meetmrhung/eyecu/documentation/TechnicalManual/Arielle/DaughterBoard1stRevision.JPG

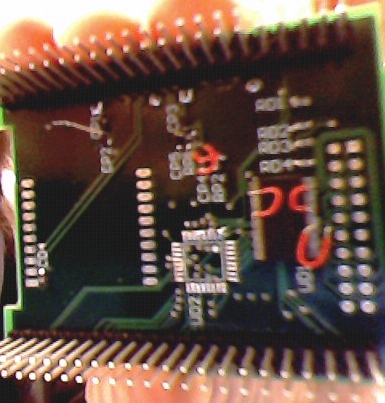
documentation/TechnicalManual/Arielle/DaughterBoard1stRevision.JPG
