meetmrhung/eyecu/documentation/TechnicalManual/Arielle/MSP430Board.JPG

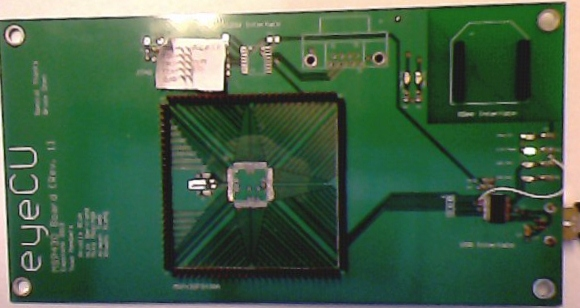
documentation/TechnicalManual/Arielle/MSP430Board.JPG
