meetmrhung/eyecu/documentation/TechnicalManual/Khashi/Power Rev 1 Schematic.png

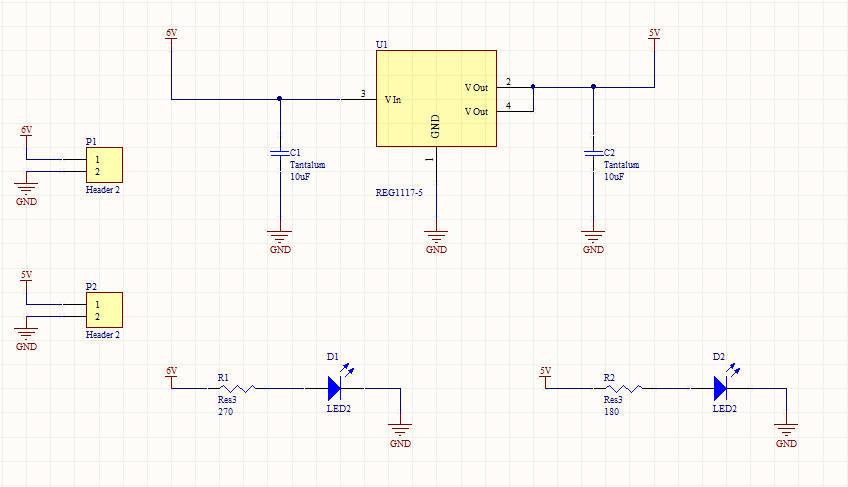
documentation/TechnicalManual/Khashi/Power Rev 1 Schematic.png
