meetmrhung/eyecu/documentation/TechnicalManual/Khashi/Power Rev 2 Schematic.png

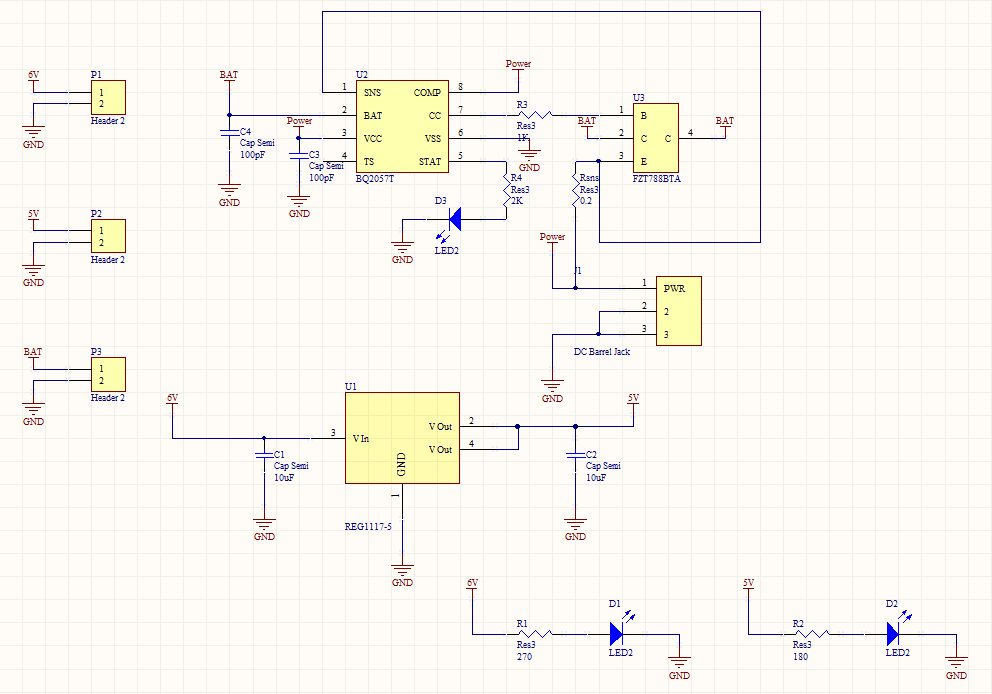
documentation/TechnicalManual/Khashi/Power Rev 2 Schematic.png
