meetmrhung/eyecu/hardware/doc/Camera_Scope_Captures/dclck_no_lvlshft.bmp

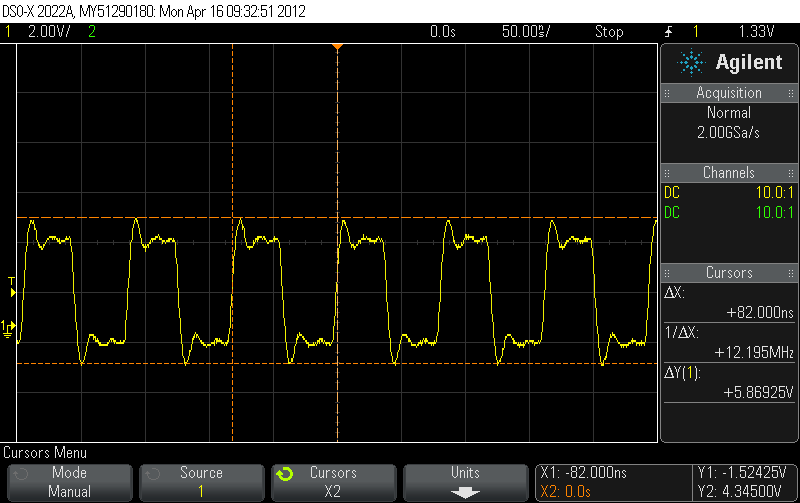
hardware/doc/Camera_Scope_Captures/dclck_no_lvlshft.bmp
