meetmrhung/eyecu/hardware/doc/Camera_Scope_Captures/dout0_no_lvlshft.bmp

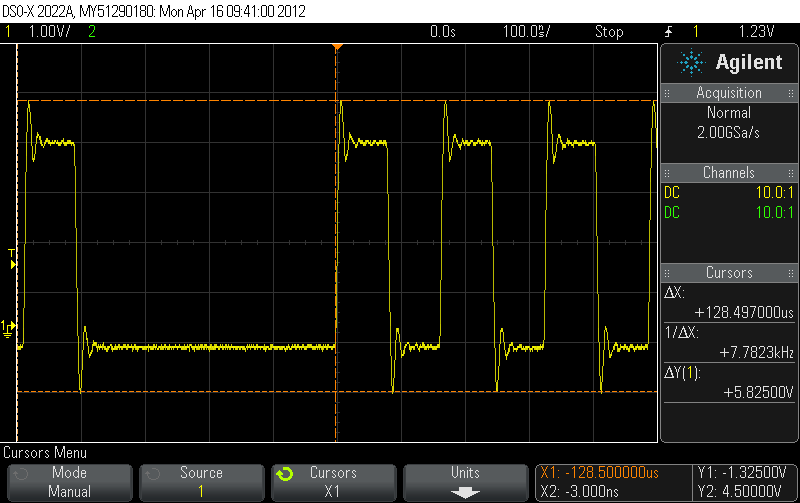
hardware/doc/Camera_Scope_Captures/dout0_no_lvlshft.bmp
