meetmrhung/eyecu/hardware/doc/Camera_Scope_Captures/horiz_sync_no_lvlshf.bmp

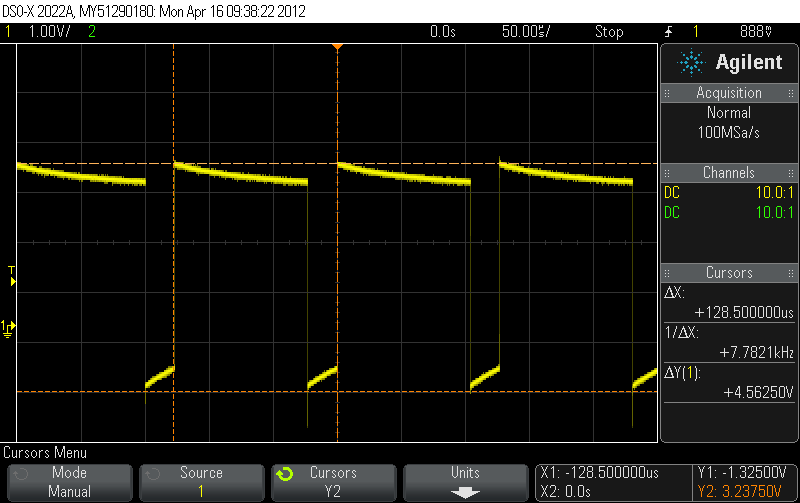
hardware/doc/Camera_Scope_Captures/horiz_sync_no_lvlshf.bmp
