meetmrhung/eyecu/hardware/doc/Camera_Scope_Captures/NewScope/dout0_4_17_12.bmp

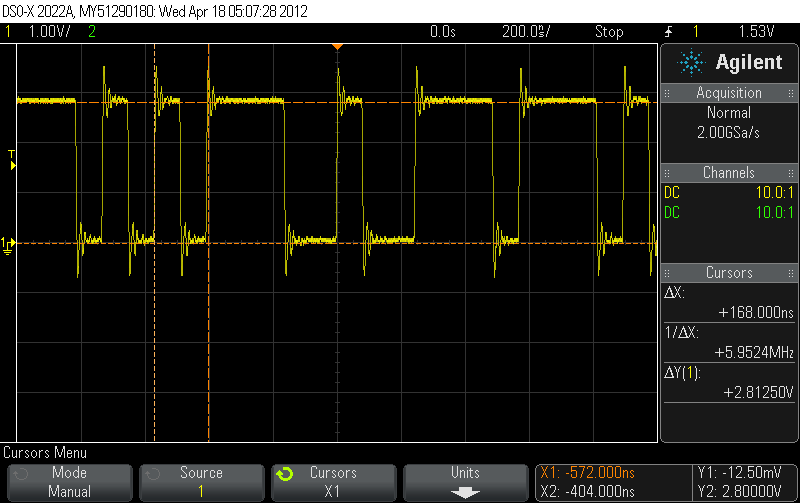
hardware/doc/Camera_Scope_Captures/NewScope/dout0_4_17_12.bmp
