meetmrhung/eyecu/hardware/doc/Camera_Scope_Captures/NewScope/hd_4_17_13.bmp

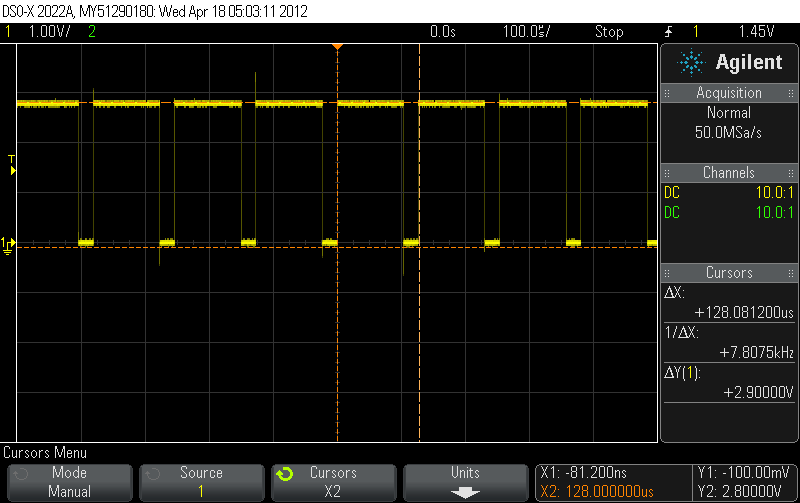
hardware/doc/Camera_Scope_Captures/NewScope/hd_4_17_13.bmp
