meetmrhung/eyecu/hardware/doc/Camera_Scope_Captures/NewScope/vd_4_17_14.bmp

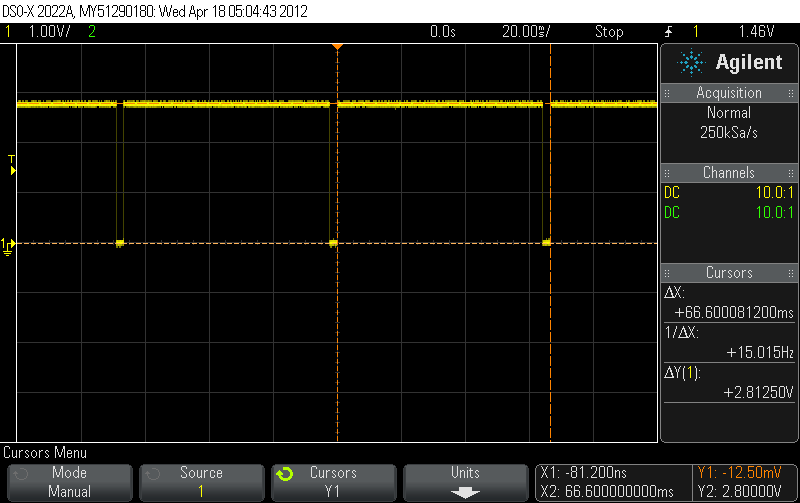
hardware/doc/Camera_Scope_Captures/NewScope/vd_4_17_14.bmp
