meetmrhung/eyecu/hardware/doc/Camera_Scope_Captures/vertical_no_lvlshft.bmp

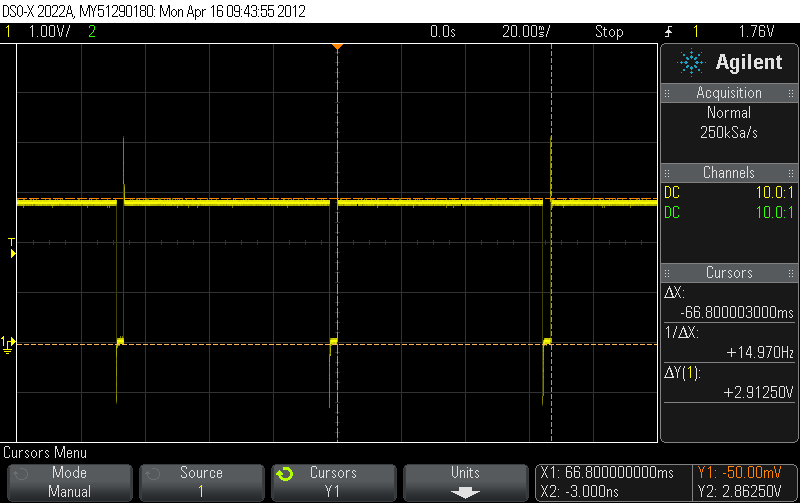
hardware/doc/Camera_Scope_Captures/vertical_no_lvlshft.bmp
