meetmrhung/eyecu/software/stellaris/I2C_Camera_Init.PNG

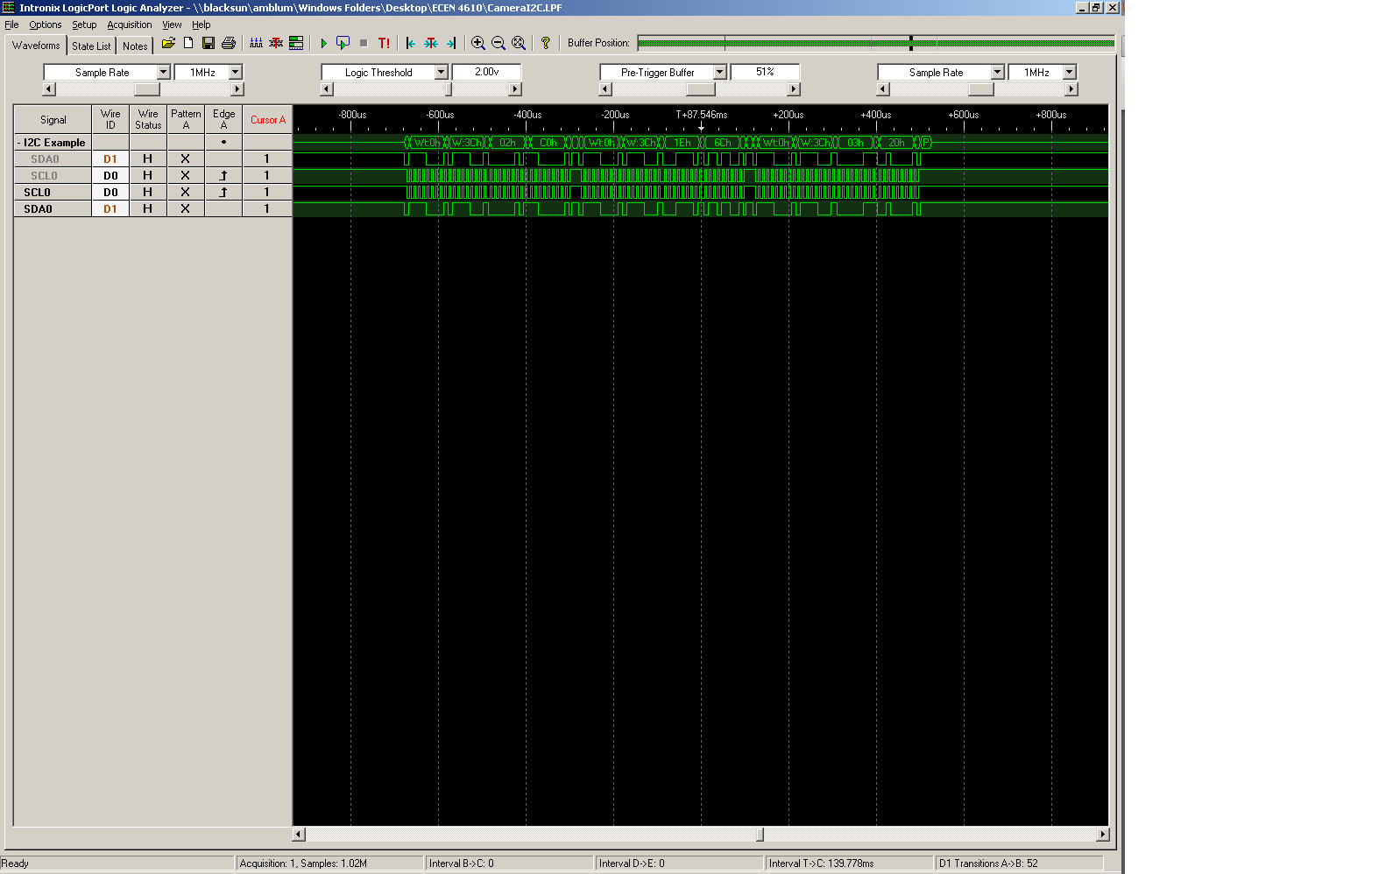
software/stellaris/I2C_Camera_Init.PNG
