meetmrhung/eyecu/hardware/bom/MSP_BOM_Record.xlsx

Serial and JTAG
Part | Manufacturer | Manufacturer Number | Description | Supplier | Price Per Unit ($/sampled) | Quantity Needed | Status (in-hand/ordered/not ordered) | Quantity In Hand | Datasheet (Y/N) | Schematic Part | Footprint | PCB Verified
MAX232 | Maxim | MAX232CWE+ | IC 2DVR/2RCVR RS232 5V 16-SOIC | Digi-Key | 3.47 | 1 | in-hand 3, (only needed 1) | 3 | Y
DB9 Connector | TE Connectivity | 1734351-1 | SERIAL PORT, CONN D-SUB PLUG R/A 9POS GOLD/FL | Digi-Key | 1.17 | 1 | in-hand 2, (only needed 1) | 2 | Y
Resistor 47K | Panasonic | ERJ-8ENF4702V | RES 47.0K OHM 1/4W 1% 1206 SMD | Digi-Key | 0.1 | 1 | in-hand 2, (only needed 1) | 2 | Y
Capacitor 1uF | KEMET | C1206C105K4RACTU | CAP CER 1UF 16V 10% X7R 1206 | Digi-Key | 0.36 | 5 | in-hand 15, (only needed 11) | 15 | Y
Capacitor 0.01uF | KEMET | C1206C103J1RACTU | CAP CER 10000PF 100V 5% X7R 1206 | Digi-Key | 0.36 | 1 | in-hand 5, (only needed 2) | 5 | Y
Capacitor 0.1uF | KEMET | C1206C104K5RACTU | CAP CER 0.1UF 50V 10% X7R 1206 | Digi-Key | 10 @ 1.5 | 1 | in-hand 10 (only needed 3) | 10 | Y
SW-PB | Omran Electronics | B3F-1052 | PUSH BUTTON SWITCH TACTILE SPST-NO 0.05A 24V | Digi-Key | 0.35 | 1 | in-hand 5, (only needed 1) | 5 | Y | TODO | TODO
JTAG Header | Samtec | TSW-105-07-F-D | JTAG HEADER DOUBLE ROW HEADER, 5 PINS PER ROW | Samtec | sample | 1 | in-hand 5, (only needed 1) | 5 | Y
USB Interface
Part | Manufacturer | Manufacturer Number | Description | Supplier | Price Per Unit ($/sampled) | Quantity Needed | Status (in-hand/ordered/not ordered) | Quantity In Hand | Datasheet (Y/N) | Schematic Part | Footprint | PCB Verified
USB Port | Samtec | USB-B-S-S-W-TH | USB-B THRU-HOLE | Samtec | sample | 1 | in-progress order 2 (total need 1) |  | Y
FT232RL | FTDI | FT232RL-REEL | IC USB FS SERIAL UART 28-SSOP | Digi-Key | 4.5 | 1 | in-hand 2, (only needed 1) | 2 | Y
MI0805K400R-10 | Laird Technologies | MI0805K400R-10 | FERRITE BEAD 1.5A 40 OHM 0805 SMD | Digi-Key | 10 @ 0.064 | 1 | in-hand 10, (only needed 1) | 10 | Y
Resistor 4.7K | Panasonic | ERJ-8GEYJ472V | RES 4.7K OHM 1/4W 5% 1206 SMD | Digi-Key | 0.06 | 1 | in-hand 2, (only needed 1) | 2 | Y
Resistor 10K | Panasonic | ERJ-8GEYJ103V | RES 10K OHM 1/4W 5% 1206 SMD | Digi-Key | 0.06 | 1 | in-hand 3, (only needed 1) | 3 | Y
Resistor 300 | Panasonic | ERJ-8GEYJ301V | RES 300 OHM 1/4W 5% 1206 SMD | Digi-Key | 0.06 | 3 | in-hand 10, (only needed 5) | 10 | Y
Capacitor 0.1uF | KEMET | C1206C104K5RACTU | CAP CER 0.1UF 50V 10% X7R 1206 | Digi-Key | 10 @ 1.5 | 2 | in-hand 10 (only needed 3) | 10 | Y
Capacitor 10uF | KEMET | T491A106K010AT | CAP TANT 10UF 10V 10% 1206 | Digi-Key | 0.51 | 1 | in-hand 2, (only needed 1) | 2 | Y
Capacitor 0.01uF | KEMET | C1206C103J1RACTU | CAP CER 10000PF 100V 5% X7R 1206 | Digi-Key | 0.36 | 1 | in-hand 5, (only needed 2) | 5 | Y
Header | Samtec | TSW-103-07-F-S | HEADER SINGLE ROW, 3 PINS | Samtec | sample | 1 | in-hand 4, (only needed 1) | 4 | Y
LED, Red | Lite-On Inc. | LTST-C230EKT | LED RED-ORAN CLR1206REAR MNT SMD | Digi-Key | 0.4 | 1 | in-hand 4, (only needed 2) | 4 | Y
LED, Amber | Lite-On Inc. | LTST-C230AKT | LED AMBER CLR 1206 REAR MNT SMD | Digi-Key | 0.4 | 1 | in-hand 4, (only needed 2) | 4 | Y
LED, Green | Lite-On Inc. | LTST-C150GKT | LED GREEN CLEAR 1206 SMD | Digi-Key | 0.38 | 1 | in-hand 4, (only needed 2) | 4 | Y
Ribbon Cable | Samtec | IDSS-03-D-04.00 | CABLE ASSEMBLY FEMALE SINGLE ROW 3 PINS | Samtec | sample | 1 | in-hand 1 | 1 | Y
 |  | IDMS-03-T-04.00-T |  |  |  |  |  | 1
Xbee Interface
Part | Manufacturer | Manufacturer Number | Description | Supplier | Price Per Unit ($/sampled) | Quantity Needed | Status (in-hand/ordered/not ordered) | Quantity In Hand | Datasheet (Y/N) | Schematic Part | Footprint | PCB Verified
Capacitor 1uF | KEMET | C1206C105K4RACTU | CAP CER 1UF 16V 10% X7R 1206 | Digi-Key | 0.36 | 1 | in-progress order 15 (total need 11) |  | Y
Resistor 300 | Panasonic | ERJ-8GEYJ301V | RES 300 OHM 1/4W 5% 1206 SMD | Digi-Key | 0.06 | 2 | in-hand 10, (only needed 5) | 10 | Y
XBee | Digi International Inc. | OEM RF Module XB24-A...-001 | WIRELESS TRANS. 1mW CHIP ANTENNA SERIES 1 | Sparkfun | 22.95 | 1 | in-hand 2, (only needed 2) | 2 | Y
LED, Red | Lite-On Inc. | LTST-C230EKT | LED RED-ORAN CLR1206REAR MNT SMD | Digi-Key | 0.4 | 1 | in-hand 4, (only needed 2) | 4 | Y
LED, Amber | Lite-On Inc. | LTST-C230AKT | LED AMBER CLR 1206 REAR MNT SMD | Digi-Key | 0.4 | 1 | in-hand 4, (only needed 2) | 4 | Y
LED, Green | Lite-On Inc. | LTST-C230AKT | LED GREEN CLEAR 1206 SMD | Digi-Key | 0.38 | 1 | in-hand 4, (only needed 2) | 4 | Y
MSP430
Part | Manufacturer | Manufacturer Number | Description | Supplier | Price Per Unit ($/sampled) | Quantity Needed | Status (in-hand/ordered/not ordered) | Quantity In Hand | Datasheet (Y/N) | Schematic Part | Footprint | PCB Verified
Crystal | ECS Inc. | ECS-.327-12.5-13FLX-C | CRYSTAL 32.768 KHZ 12.5PF SMD | Digi-Key | 0.94 | 1 | in-hand 2, (only needed 1) | 2 | Y
Capacitor 22pF | KEMET | C1206C220J5GACTU | CAP CER 22PF 50V 5% NP0 1206 | Digi-Key | 0.31 | 2 | in-hand 3, (only needed 2) | 3 | Y
Capacitor 1uF | KEMET | C1206C105K4RACTU | CAP CER 1UF 16V 10% X7R 1206 | Digi-Key | 0.36 | 5 | in-hand 15, (only needed 11) | 15 | Y
Capacitor0.47uF | KEMET | C1206C474J5NACTU | CAP CER 0.47UF 50V 5% X8L 1206 | Digi-Key | 0.96 | 1 | in-hand 2, (only needed 1) | 2 | Y
Header | Samtec | TSW-125-07-F-S | HEADER SINGLE ROW 25 PINS | Samtec | sample | 4 | in-hand 5, (only needed 4) | 5 | Y
MSP430 Chip | Texas Instruments | MSP430F5438AIPZR | MSP430F5438AIPZR 100 PIN LQFP MICROCONTROLLER | Texas Instruments | sample | 1 | in-hand 2, (only needed 1) | 2 | Y
Resistor 100 | Panasonic | ERJ-8GEYJ101V | RES 100 OHM 1/4W 5% 1206 SMD | Digi-Key | 0.06 |  | in-hand 10 | 10 | Y
CPLD | Atmel | ATF22LV10C-10SU | CPLD IC PLD EE 10NS 24-SOIC | Digi-Key | 2.8 |  | in-hand 2 | 2
TPS60501DGS | Texas Instruments | TPS60501DGS | IC CHRG PUMP STPDWN 250MA 10MSOP | Texas Instruments | sample |  | in-hand 2 | 2
Capacitor 2.2uF | KEMET | C3216X5R1C225K/1.60 | CAP CER 2.2UF 16V 10% X5R 1206 | Digi-Key | 0.4 |  | in-hand 4 | 4
TPS79915DDCR | Texas Instruments | TPS79915DDCR | IC LDO 200MA 1.5V TSOT-23-5 | Digi-Key | 0.96 |  | in-hand 3 | 3
TPS79928DDCR | Texas Instruments | TPS79928DDCR | IC LDO 200MA 2.8V TSOT-23-5 | Digi-Key | 0.96 |  | in-hand 3 | 3
Capacitor 1uF | KEMET | C3216X7R1E105M/0.85 | CAP CER 1UF 25V 20% X7R 1206 | Digi-Key | 0.28 |  | in-hand 12 | 12
Capacitor 2.2uF | KEMET | C3216X5R1C225K/1.60 | CAP CER 2.2UF 16V 10% X5R 1206 | Digi-Key | 0.4 |  | in-hand 4 | 4
Capacitor 0.012uF | KEMET | C1206C123K5RACTU | CAP CER 0.012UF 50V 10% X7R 1206 | Digi-Key | 0.48 |  | in-hand 4 | 4
Resistor 165 | Panasonic | ERJ-8ENF1650V | RES 165 OHM 1/4W 1% 1206 SMD | Digi-Key | 0.1 |  | in-hand 4 | 4
Resistor 0.0 | Panasonic | ERJ-8GEY0R00V | RES 0.0 OHM 1/4W 1206 SMD | Digi-Key | 0.06 |  | in-hand 8 | 8
Capacitor 0.1uF | KEMET | C3216X7R1H104K | CAP CER 0.1UF 50V 10% X7R 1206 | Digi-Key | 0.225 |  | in-hand 10 | 10
Oscillator 24 MHz | AVX Corporation | KC2520B24.0000C10E00 | OSCILLATOR 24.0000MHZ SMD | Digi-Key | 3.96 |  | in-hand 2 | 2
SN74LVCH16T245DGGR | Texas Instruments | SN74LVCH16T245DGGR | IC BUS TRANSCVR 16BIT 48TSSOP | Digi-Key | 2.39 |  | in-hand 3 | 3
I2C Level Translator | Texas Instruments | TXS0102DCTR | IC VOLT-LVL TRANSL 2BIT BI SM8 | Texas Instruments | sample |  | in-hand 2 | 2
Resistor 10K | Panasonic | ERJ-8GEYJ103V | RES 10K OHM 1/4W 5% 1206 SMD | Digi-Key | 0.06 |  | in-hand 3 | 3
Crystal 24MHz | ECS INC | ECS-240-20-4 | CRYSTAL 24.000 MHZ 20PF 49US | Digi-Key | 0.81 |  | in-hand 2 | 2
I2C Level Translator | Texas Instruments | PCA9306DCTR | IC VOLT-LEVEL TRANSLATOR SM8 | Digi-Key | 0.94 |  | in-hand 4 | 4
