meetmrhung/eyecu/hardware/bom/Daughter_and_Camera_Board_PCB_BOM.xlsx

Camera Interface
Part | Manufacturer | Manufacturer Number | Description | Supplier | Supplier Part Number | Price Per Unit ($/sampled) | Quantity Needed | Status (in-hand/ordered/not ordered) | Quantity In Hand | Datasheet (Y/N) | Schematic Part | Footprint | PCB Verified
Camera Connection Header | Samtec | TSW-110-09-G-D | MALE TO MALE 10x2 HEADER | Samtec | TSW-110-09-G-D | sampled | 1 | in-hand 6, (only needed 2) | 6
FIFO Buffer | Integrated Device Technology | IDT72V241L10PF | IC FIFO SYNC 4KX9 10NS 32QFP | DigiKey | 800-1518-ND | 24.89 | 1 | in-progress order 2
Resistor 165 | Panasonic | ERJ-3EKF1650V | RES 165 OHM 1/10W 1% 0603 SMD | DigiKey | P165HCT-ND | 0.04 | 2 | 4
??? Resistor 300
Capacitor 1 uF | Muarata Electronics North America | GRM188R60J105MA01D | CAP CER 1UF 6.3V 20% X5R 0603 | DigiKey | 490-1549-1-ND | 0.032 | 1 | 10
LED Green | OSRAM | LG Q971-KN-1 | LED CHIPLED 570NM GREEN 0603 SMD | DigiKey | 475-1409-1-ND | 0.1 | 1 | 2
LED Amber | OSRAM | LA L296-Q2R2-1-Z | LED SMARTLED AMBER 615NM 0603 | DigiKey | 475-2712-1-ND | 0.17 | 2 | 1
LED Red | OSRAM | LS Q976-NR-1 | LED CHIPLED 633NM RED 0603 SMD | DigiKey | 475-2512-1-ND | 0.11 | 1 | 1
Connections to BeagleBone
Part | Manufacturer | Manufacturer Number | Description | Supplier | Supplier Part Number | Price Per Unit ($/sampled) | Quantity Needed | Status (in-hand/ordered/not ordered) | Quantity In Hand | Datasheet (Y/N) | Schematic Part | Footprint | PCB Verified
BeagleBone Connection Header | Samtec | TSW-123-09-G-D | MALE TO MALE 23x2 HEADER | Samtec | TSW-123-09-G-D | sampled | 2 | in-hand 6, (only needed 2)
XBee | Digi International Inc. | OEM RF Module XB24-A...-001 | WIRELESS TRANS. 1mW CHIP ANTENNA SERIES 1 | Sparkfun | WRL-08664 | 22.95 | 1 | in-hand 2, (only needed 2) | 2 | Y
Capacitor 1 uF | Muarata Electronics North America | GRM188R60J105MA01D | CAP CER 1UF 6.3V 20% X5R 0603 | DigiKey | 490-1549-1-ND | 0.032 | 1 | 10
Resistor 665 | Panasonic | ERJ-3EKF6650V | RES 665 OHM 1/10W 1% 0603 SMD | DigiKey | P665HCT-ND | 0.04 | 1 | 6
Resistor 165 | Panasonic | ERJ-3EKF1650V | RES 165 OHM 1/10W 1% 0603 SMD | DigiKey | P165HCT-ND | 0.04 | 1 | 4
LED Pink | Panasonic | LNJP12X8ARA | LED SMD PINK TSS TYPE | DigiKey | LNJP12X8ARACT-ND | 0.54 | 1 | 1
LED Blue | OSRAM | LB Q39G-L2N2-35-1 | LED CHIPLED BLUE 470NM 0603 SMD | DigiKey | 475-2816-1-ND | 0.27 | 1 | 4
Camera Board
Part | Manufacturer | Manufacturer Number | Description | Supplier | Supplier Part Number | Price Per Unit ($/sampled) | Quantity Needed | Status (in-hand/ordered/not ordered) | Quantity In Hand | Datasheet (Y/N) | Schematic Part | Footprint | PCB Verified
Crystal | AVX Corporation | KC2520B24.5760C10E00 | OSCILLATOR 24.5760MHZ SMD | DigiKey | 478-4779-1-ND | 3.96 | 1 | 2
Mosfet N | Fairchild Semiconductor | FDV301N | MOSFET N-CH 25V 220MA SOT-23 | DigiKey | FDV301NCT-ND | 0.47 | 3 | 3
CMOS Camera - 640x480 | Toshiba | TCM8230MD | CMOS CAMERA 8-BIT WIDE RAW DATA OUTPUT RGB/YUV |  | SEN-08667 | 9.95 | 1 | 5
SN74LVCH16T245DGGR | Texas Instruments | SN74LVCH16T245DGGR | IC BUS TRANSCVR 16BIT 48TSSOP | Digi-Key | 296-19568-1-ND | 2.39 | 1 | 4
TPS79915DDCR | Texas Instruments | TPS79915DDCR | IC LDO 200MA 1.5V TSOT-23-5 | Digi-Key | 296-17777-1-ND | 0.96 | 1 | 3
TPS79928DDCR | Texas Instruments | TPS79928DDCR | IC LDO 200MA 2.8V TSOT-23-5 | Digi-Key | 296-17781-1-ND | 0.96 | 1 | 3
Resistor 2.0K | Panasonic | ERJ-3GEYJ202V | RES 2.0K OHM 1/10W 5% 0603 SMD | Digi-Key | P2.0KGCT-ND | 0.02 | 4 | 4
Resistor 0.0 | Panasonic | ERJ-3GEY0R00V | RES 0.0 OHM 1/10W 0603 SMD | Digi-Key | P0.0GCT-ND | 0.02 | 3 | 4
Resistor 10K | Panasonic | ERJ-3GEYJ103V | RES 10K OHM 1/10W 5% 0603 SMD | Digi-Key | P10KGCT-ND | 0.02 | 1 | 2
Resistor 165 | Panasonic | ERJ-3EKF1650V | RES 165 OHM 1/10W 1% 0603 SMD | DigiKey | P165HCT-ND | 0.04 | 2 | 4
Capacitor 1 uF | Muarata Electronics North America | GRM188R60J105MA01D | CAP CER 1UF 6.3V 20% X5R 0603 | DigiKey | 490-1549-1-ND | 0.032 | 5 | 10
Capacitor 0.1uF | Muarata Electronics North America | GRM188R71E104KA01D | CAP CER 0.1UF 25V 10% X7R 0603 | DigiKey | 490-1524-1-ND | 0.026 | 2 | 10
Capacitor 0.01uF | Muarata Electronics North America | GRM188R71H103KA01D | CAP CER 10000PF 50V 10% X7R 0603 | DigiKey | 490-1512-1-ND | 0.023 | 2 | 10
Capacitor 2.2uF | Taiyo Yuden | JMK107BJ225KA-T | CAP CER 2.2UF 6.3V 10% X5R 0603 | DigiKey | 587-1254-1-ND | 0.24 | 2 | 4
LED Blue | OSRAM | LB Q39G-L2N2-35-1 | LED CHIPLED BLUE 470NM 0603 SMD | DigiKey | 475-2816-1-ND | 0.27 | 2 | 4
