meetmrhung/eyecu/hardware/bom/Power PCB BOM.xlsx

Description | Quantity | Manufacturer P/N: | Supplier P/N: | Supplier
Linear Regulator, 5V, 800mA | 1 | REG117-5 | 296-27921-1-ND | Digi-Key
Capacitor, Tantalum, 10uF, 10% | 2 | TR3B106K010C0750 | 718-1462-1-ND | Digi-Key
LED, Red, 1.7V, 50mA | 2 | SML-LX1206SRC-TR | 67-1359-1-ND | Digi-Key
Resistor,Thick Film, 180Ohms, 1/4 W, 1% | 1 | RC1206FR-07180RL | 311-180FRCT-ND | Digi-Key
Resistor,Thick Film, 270Ohms, 1/4 W, 1% | 1 | RC1206FR-07270RL | 311-270FRCT-ND | Digi-Key
DC Plug, 2.1mm ID, 5.5mm OD, 24AWG | 1 | CA-2185 | CP-2185-ND | Digi-Key
Dean Ultra Plug, Female | 1 | Ultra Plug | Ultra Plug, Female (2) | Amazon
