meetmrhung/eyecu/documentation/budget/budget.xlsx

Section | Component | Quantity | Cost (each) | Cost to Team | Extended cost | Source
Wireless
 | XBee | 2 | 11.75 | 11.75 | 23.5 | Sparkfun.com
 | USB XBee Explorer | 1 | 24.95 | 24.95 | 24.95 | Sparkfun.com
 | XBee Breakout Board | 2 | 2.95 | 2.95 | 5.9 | Sparkfun.com
Processing |  |  |  | 0
 | Beagle Bone Evaluation Board | 2 | 89 | 0 | 0 | Capstone
Mechanical |  |  |  | 0
 | Lens-less Glasses | 1 | 5.99 | 5.99 | 5.99
Camera |  |  |  | 0
 | 640x480 CMOS Camera | 5 | 9.99 | 9.95 | 49.75 | Sparkfun.com
 | Test Cameras | 3 | Donated |  | 0 | Capstone
 | FTDI to USB | 1 | 10 | 10 | 10 | Sparkfun.com
Manufacturing |  |  |  | 0
 | PCB Fabrications (2 at 4 layer) | 3 | 66 | 66 | 198 | 4pcb.com (Advanced Circuits)
 | PCB Fabrications (2 at 4 layer, 2 image) | 3 | 112 | 112 | 336 | 4pcb.com (Advanced Circuits)
Components
 | LCD Screen | 9.95 | 1 |  | 0 | Adafruit.com
 | Hardware Buffer | 2 | 25 | 25 | 50 | Digikey.com
 | Daughterboard components | 40 | 2 |  | 0 | Digikey.com
Presentation
 | Poster | 1 | 55 | 55 | 55 | ITLL
Misc.
 | Shipping, miscellanous parts | 1 | 200 | 200 | 200
Total Cost |  |  |  |  | 959.09
