meetmrhung/eyecu/hardware/solidworks/BeagleBone.SLDASM

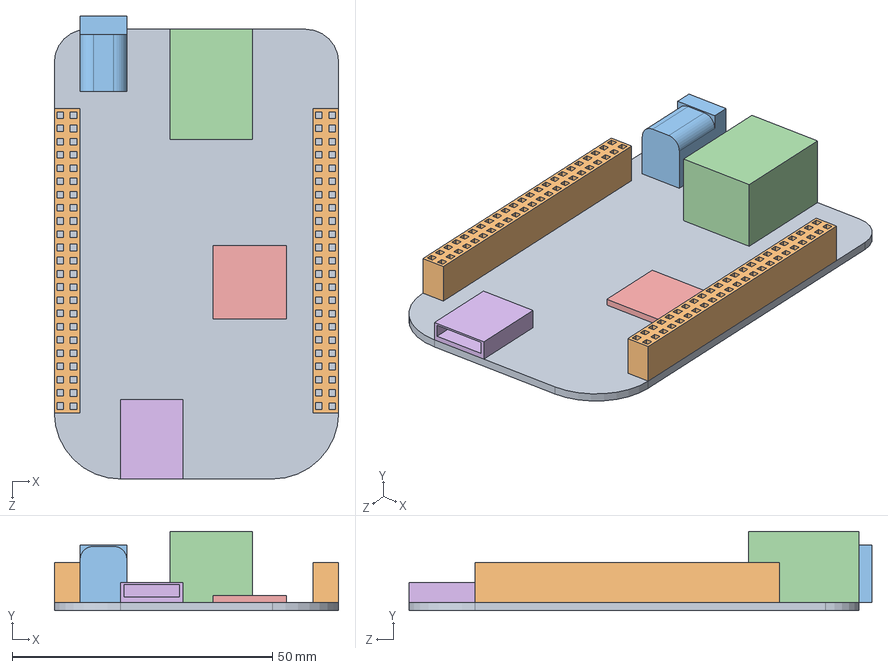
[picture p51: CAD file, 2012-03-21]
hardware/solidworks/BeagleBone.SLDASM
54.6 x 15.2 x 88.9 mm
BeagleBone_PCB
BeagleBone_Header x 2
BeagleBone_DC_Jack
BeagleBone_Ethernet
BeagleBone_ARM
BeagleBone_USB_A
