meetmrhung/eyecu/hardware/solidworks/BeagleBone_DC_Jack.SLDPRT

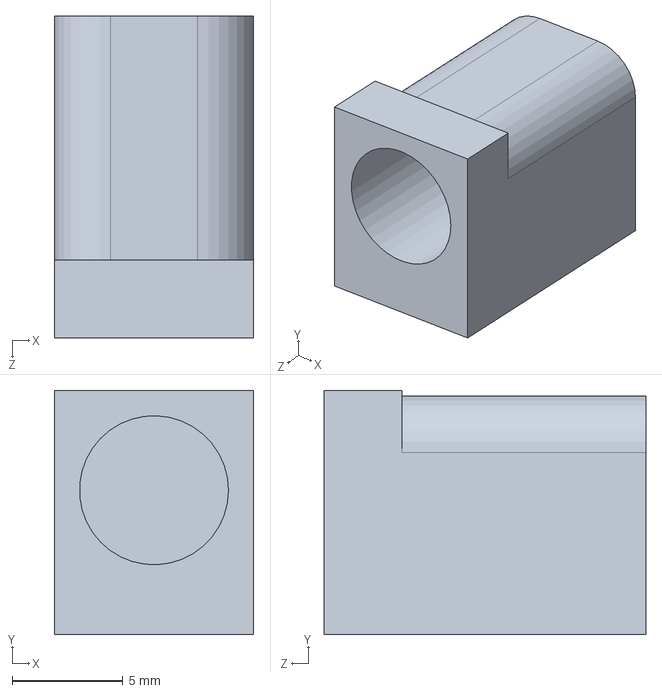
[picture p52: CAD file, 2012-03-21]
hardware/solidworks/BeagleBone_DC_Jack.SLDPRT
8.99 x 11.0 x 14.5 mm
