meetmrhung/eyecu/hardware/solidworks/BeagleBone_ARM.SLDPRT

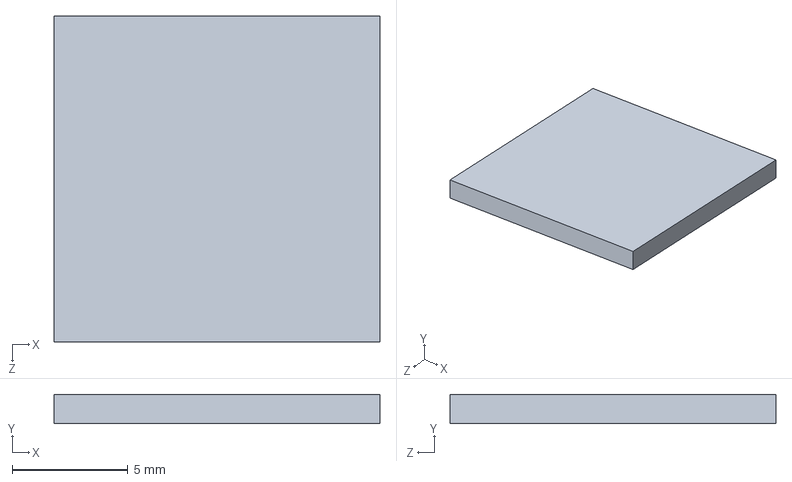
[picture p53: CAD file, 2012-03-21]
hardware/solidworks/BeagleBone_ARM.SLDPRT
14.1 x 1.27 x 14.1 mm
