meetmrhung/eyecu/hardware/solidworks/BeagleBone_USB_A.SLDPRT

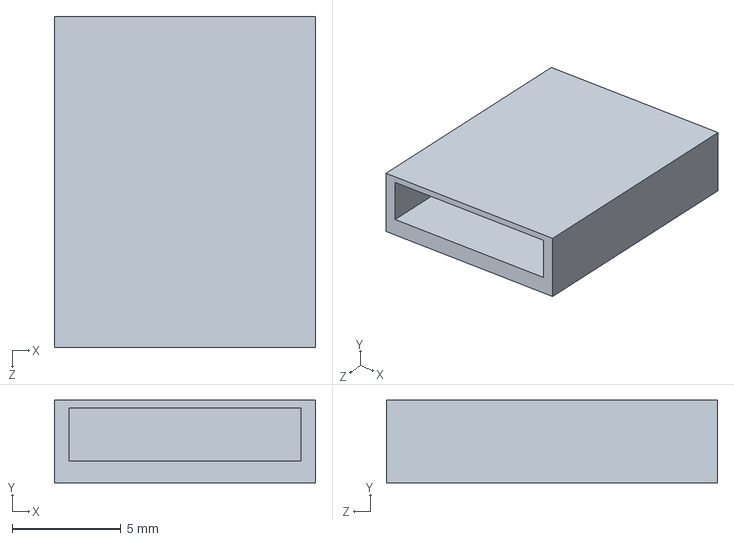
[picture p54: CAD file, 2012-03-21]
hardware/solidworks/BeagleBone_USB_A.SLDPRT
12.0 x 3.81 x 15.2 mm
