meetmrhung/eyecu/hardware/solidworks/BeagleBone_Header.SLDPRT

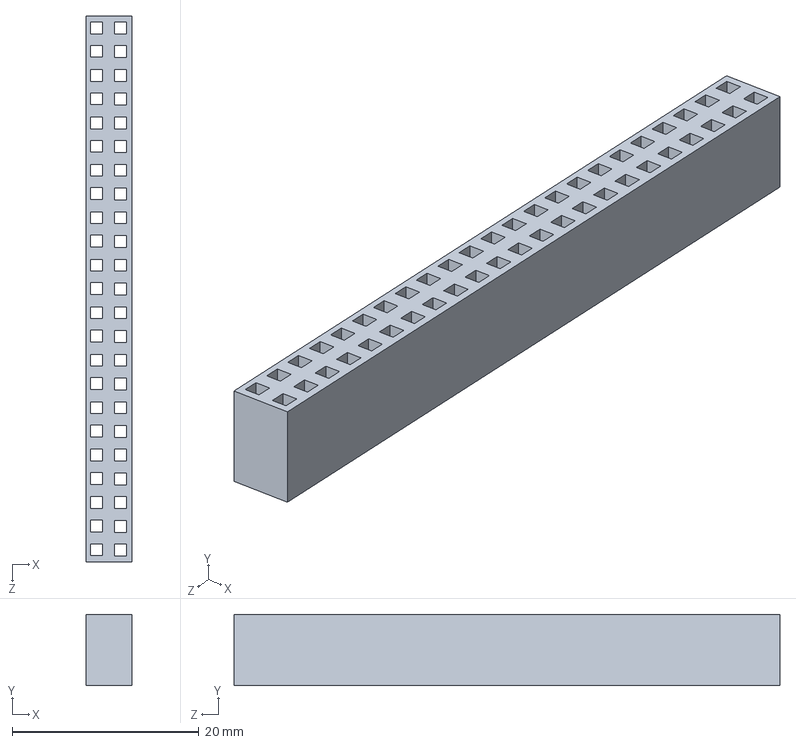
[picture p55: CAD file, 2012-03-21]
hardware/solidworks/BeagleBone_Header.SLDPRT
4.95 x 7.62 x 58.4 mm
