meetmrhung/eyecu/hardware/solidworks/BeagleBone_PCB.SLDPRT

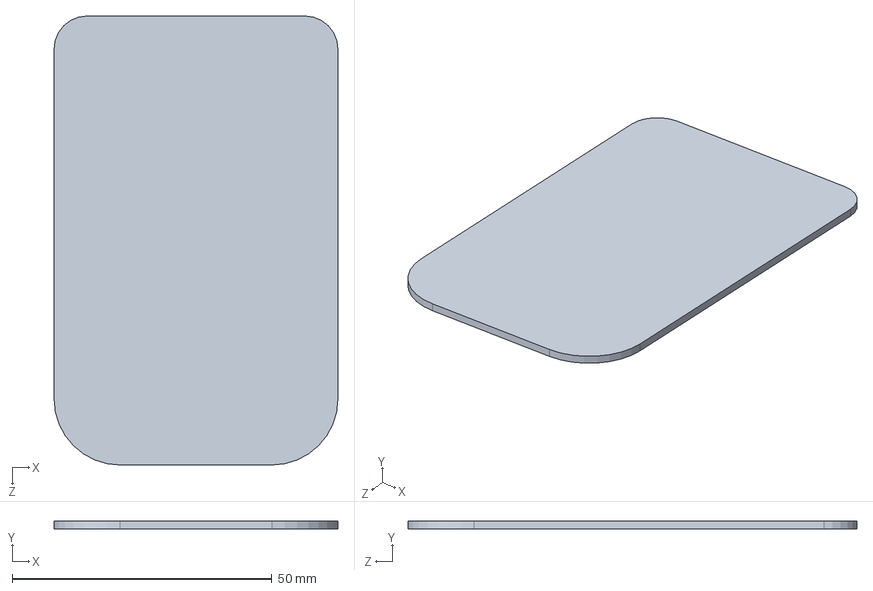
[picture p56: CAD file, 2012-03-21]
hardware/solidworks/BeagleBone_PCB.SLDPRT
54.6 x 1.57 x 86.4 mm
