meetmrhung/eyecu/hardware/solidworks/BeagleBone_Ethernet.SLDPRT

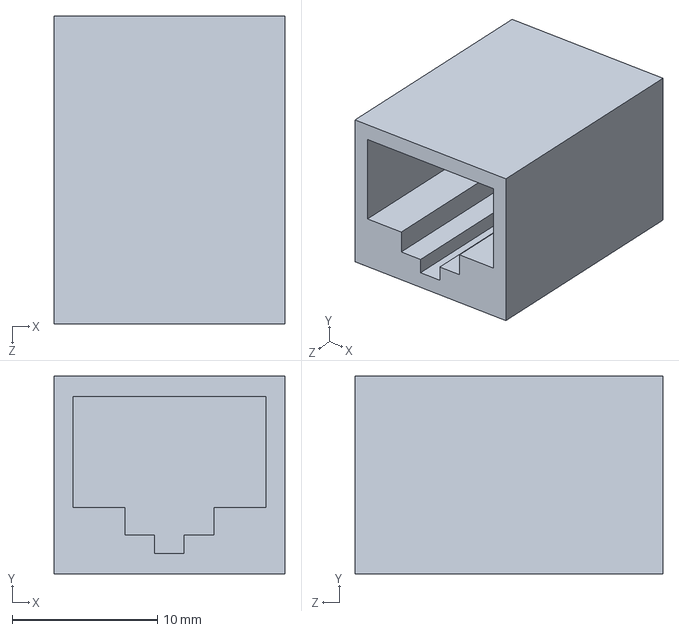
[picture p57: CAD file, 2012-03-21]
hardware/solidworks/BeagleBone_Ethernet.SLDPRT
15.9 x 13.6 x 21.2 mm
