meetmrhung/eyecu/documentation/TechnicalManual/Arielle/CameraProtoboard.JPG

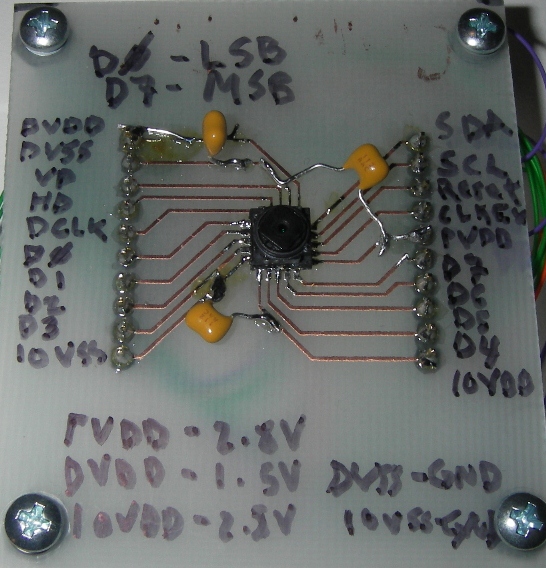
documentation/TechnicalManual/Arielle/CameraProtoboard.JPG
