meetmrhung/eyecu/documentation/TechnicalManual/Arielle/EyeGlassesPrototype.JPG

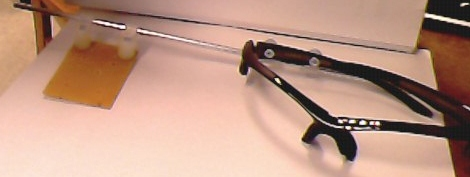
documentation/TechnicalManual/Arielle/EyeGlassesPrototype.JPG
