meetmrhung/eyecu/documentation/TechnicalManual/Arielle/CameraBoardTesting0.JPG

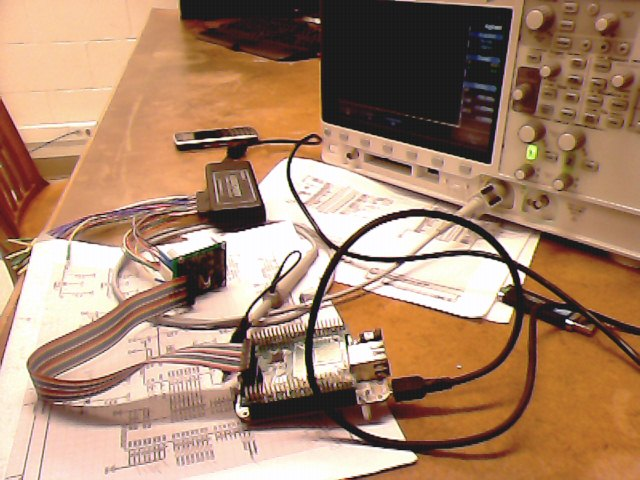
documentation/TechnicalManual/Arielle/CameraBoardTesting0.JPG
