meetmrhung/eyecu/documentation/TechnicalManual/Arielle/CameraBoardTesting1.JPG

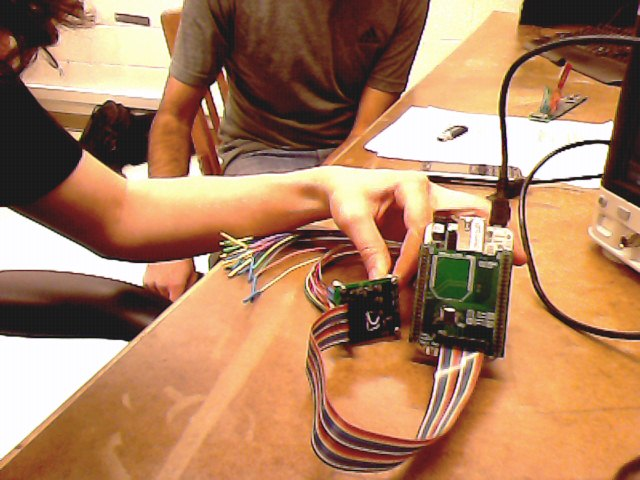
documentation/TechnicalManual/Arielle/CameraBoardTesting1.JPG
