meetmrhung/eyecu/hardware/doc/MSP430_Todo_list.docx

MSP 430 To do list

Header Footprints

Make XBee Component and footprint

Double Check the Power for schematic

-Add power and ground for MSP430

-I would collect the powers and grounds together in the schematic diagram

Do PCB layout and routing

Complete Advance Circuits PCB check thingy

Submit order to Digikey and finalize

Submit Samtec order and finalize
