meetmrhung/eyecu/hardware/schematics/BONE_SCH.pdf

REV | BY Description | DATE
A3 | Production release. | 10/21/2011 | GC

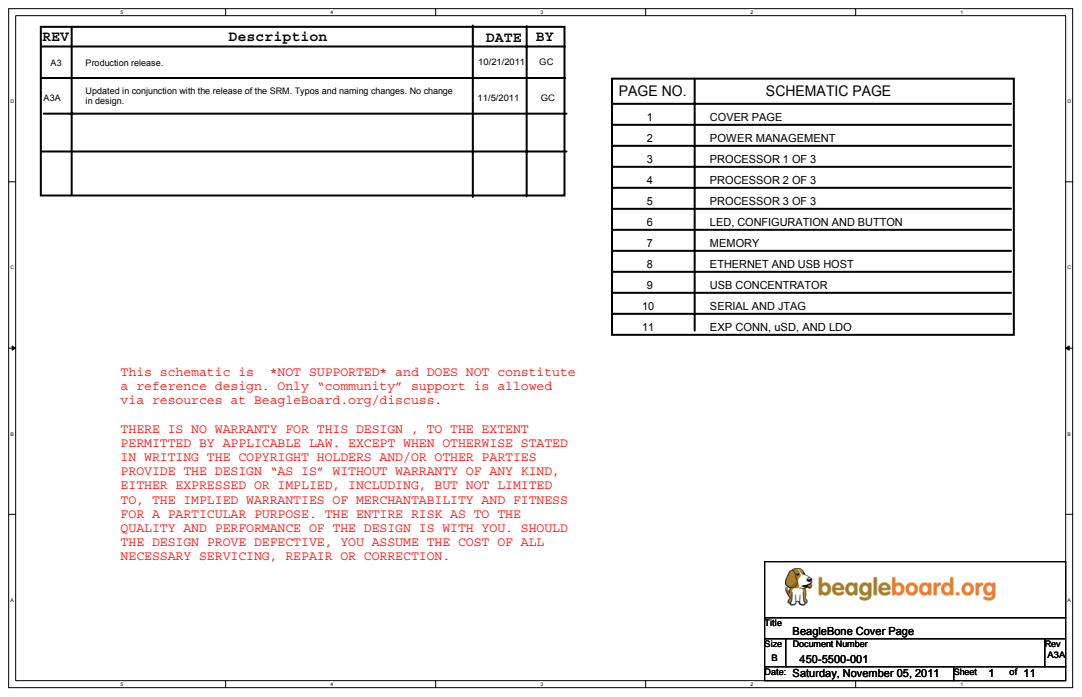
[picture p97: page 1]
PAGE NO.; SCHEMATIC PAGE; EXP CONN, uSD, AND LDO; Updated in conjunction with the release of the SRM. Typos and naming changes. No change; in design.

COVER PAGE
POWER MANAGEMENT
PROCESSOR 1 OF 3
PROCESSOR 2 OF 3
PROCESSOR 3 OF 3
LED, CONFIGURATION AND BUTTON
MEMORY
ETHERNET AND USB HOST
USB CONCENTRATOR
SERIAL AND JTAG

This schematic is *NOT SUPPORTED* and DOES NOT constitute
a reference design. Only “community” support is allowed
via resources at BeagleBoard.org/discuss.

THERE IS NO WARRANTY FOR THIS DESIGN , TO THE EXTENT
PERMITTED BY APPLICABLE LAW. EXCEPT WHEN OTHERWISE STATED
IN WRITING THE COPYRIGHT HOLDERS AND/OR OTHER PARTIES
PROVIDE THE DESIGN “AS IS” WITHOUT WARRANTY OF ANY KIND,
EITHER EXPRESSED OR IMPLIED, INCLUDING, BUT NOT LIMITED
TO, THE IMPLIED WARRANTIES OF MERCHANTABILITY AND FITNESS
FOR A PARTICULAR PURPOSE. THE ENTIRE RISK AS TO THE
QUALITY AND PERFORMANCE OF THE DESIGN IS WITH YOU. SHOULD
THE DESIGN PROVE DEFECTIVE, YOU ASSUME THE COST OF ALL
NECESSARY SERVICING, REPAIR OR CORRECTION.

Title
BeagleBone Cover Page

Size Size Size B B B | Document Number Document Number Document Number 450-5500-001 450-5500-001 450-5500-001 | Rev Rev Rev A3A A3A A3A

Date: Date: Date: Saturday, November 05, 2011 Saturday, November 05, 2011 Saturday, November 05, 2011 | Sheet Sheet Sheet 1 1 1 of of of 11 11 11

# 5V DC POWER

### P_INT_LDO

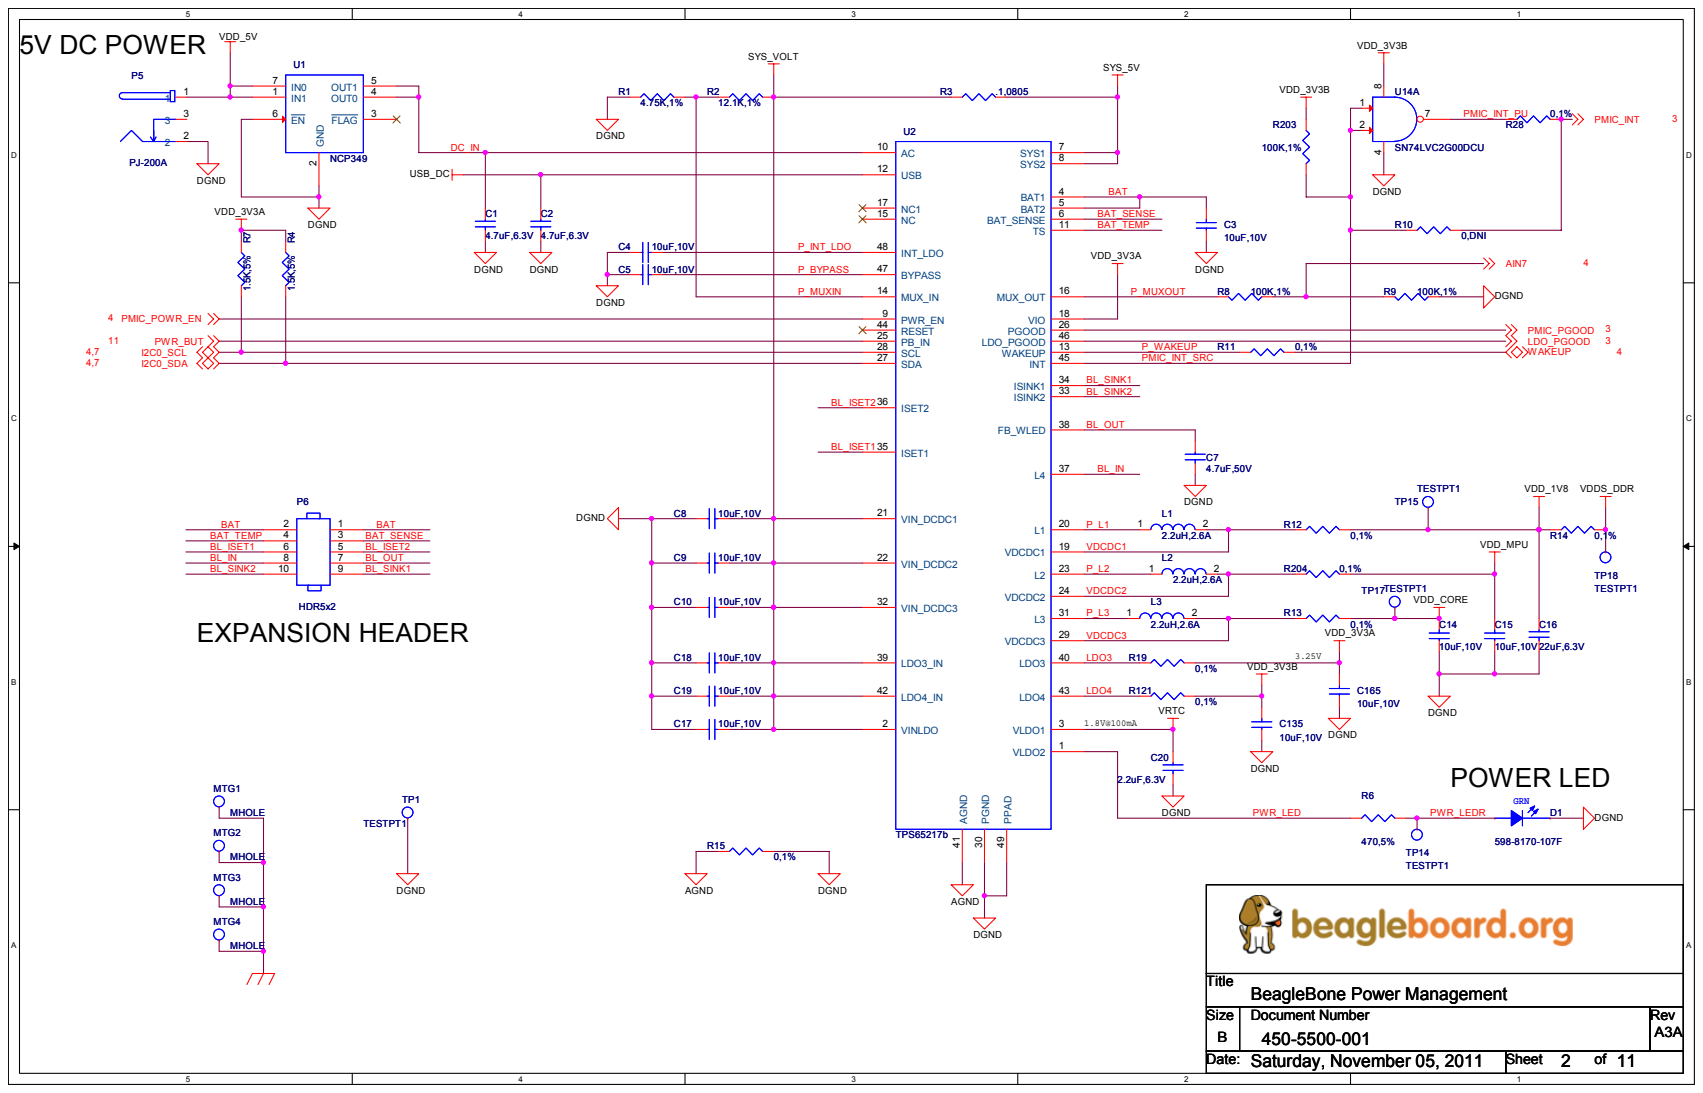
[picture p98: page 2]
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

Date: Date: Date: Saturday, November 05, 2011 Saturday, November 05, 2011 Saturday, November 05, 2011 | Sheet Sheet Sheet 2 2 2 of of of 11 11 11

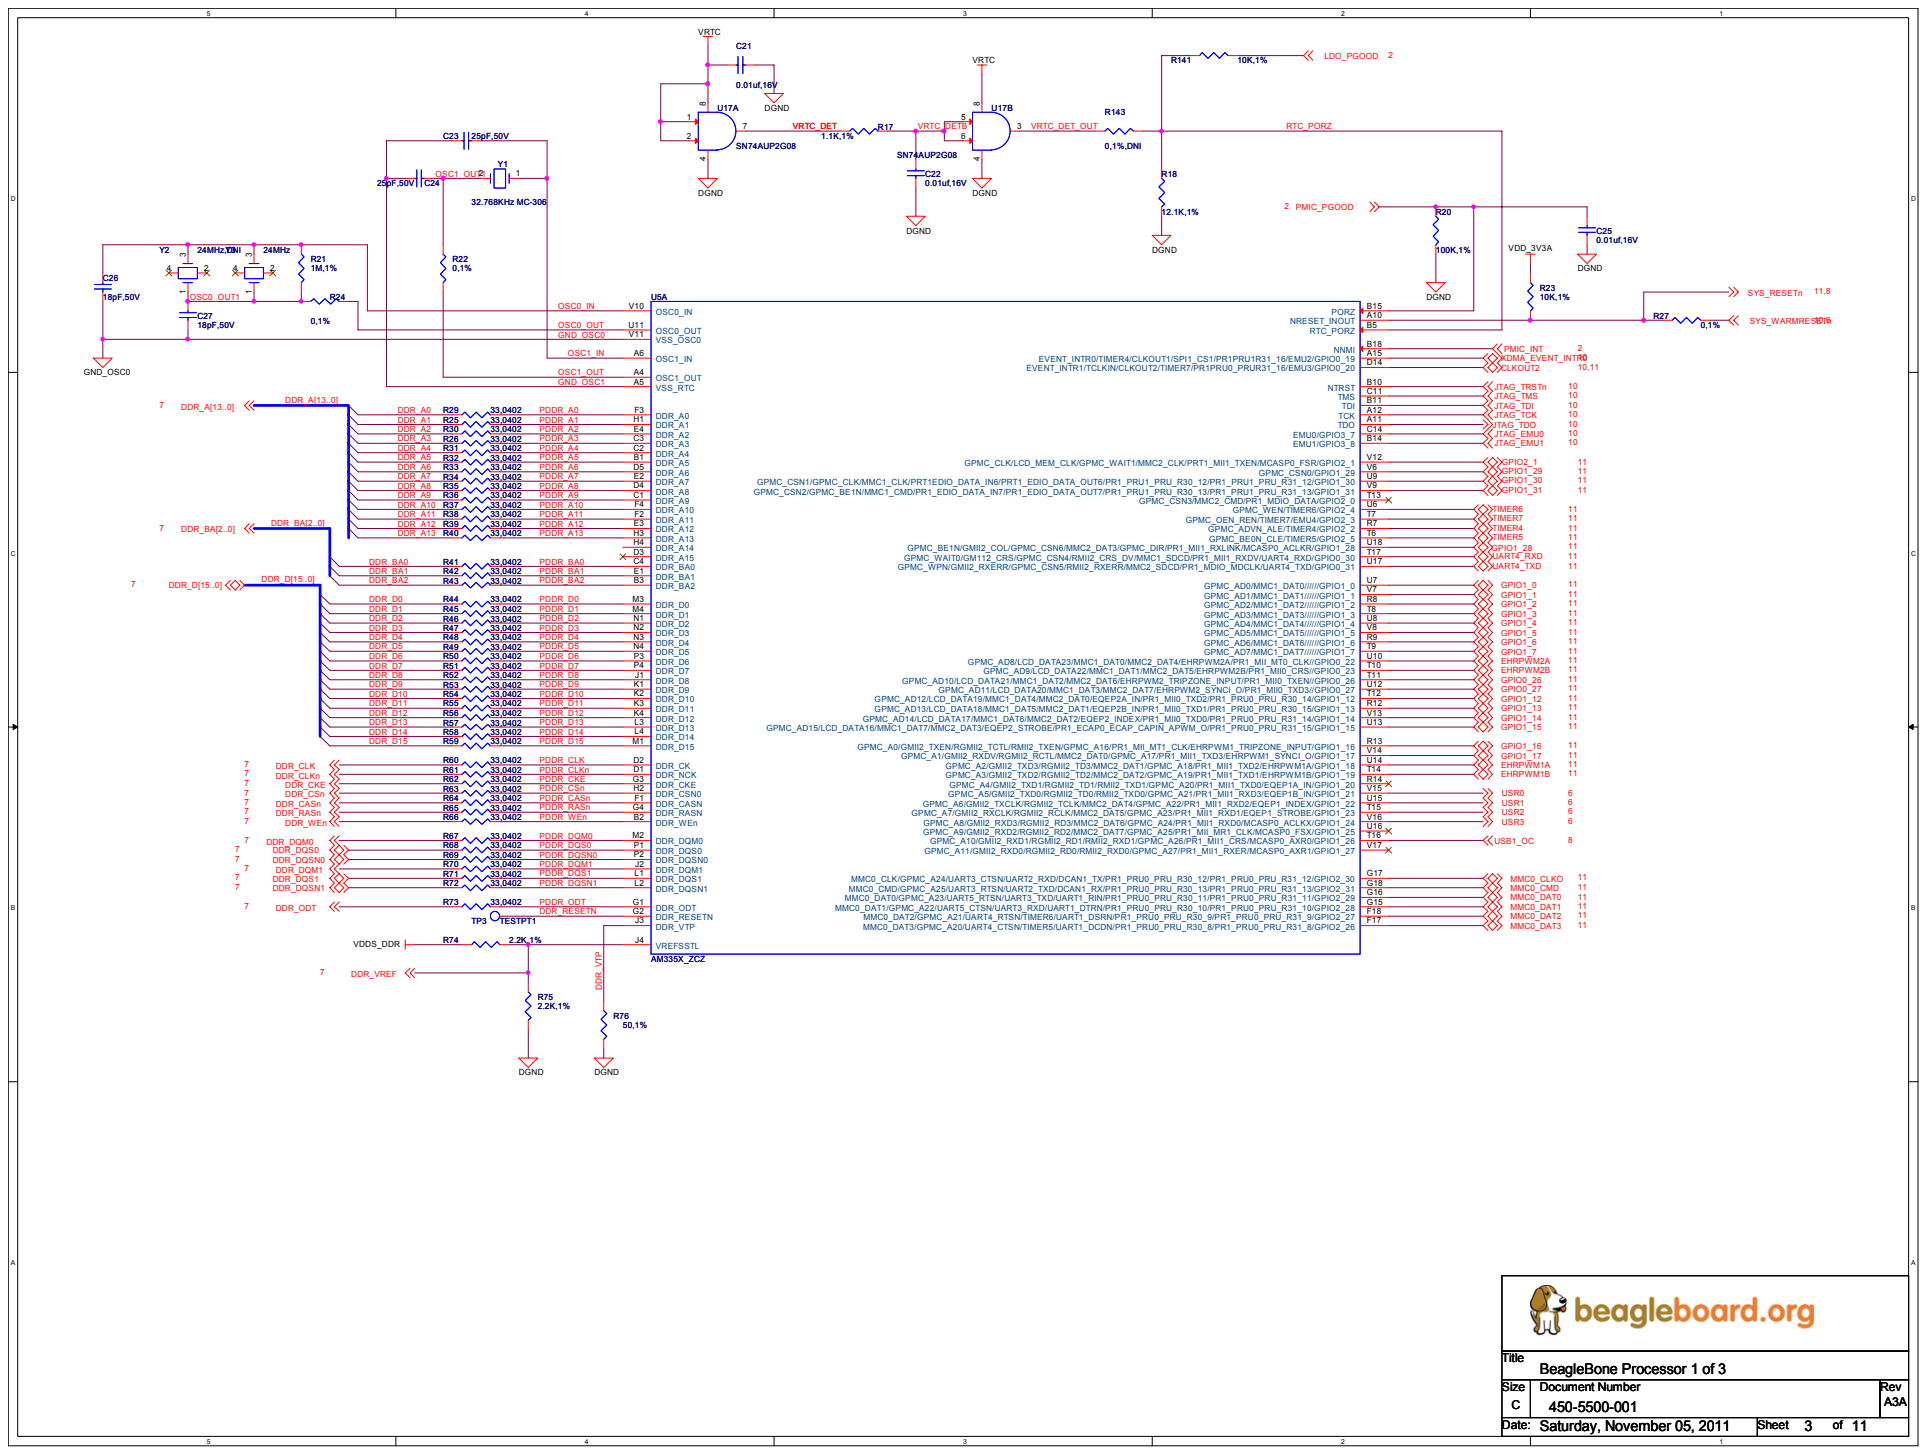
[picture p99: page 3]

Size Size Size C C C | Document Number Document Number Document Number 450-5500-001 450-5500-001 450-5500-001 | Rev Rev Rev A3A A3A A3A

Date: Date: Date: Saturday, November 05, 2011 Saturday, November 05, 2011 Saturday, November 05, 2011 | Sheet Sheet Sheet 3 3 3 of of of 11 11 11

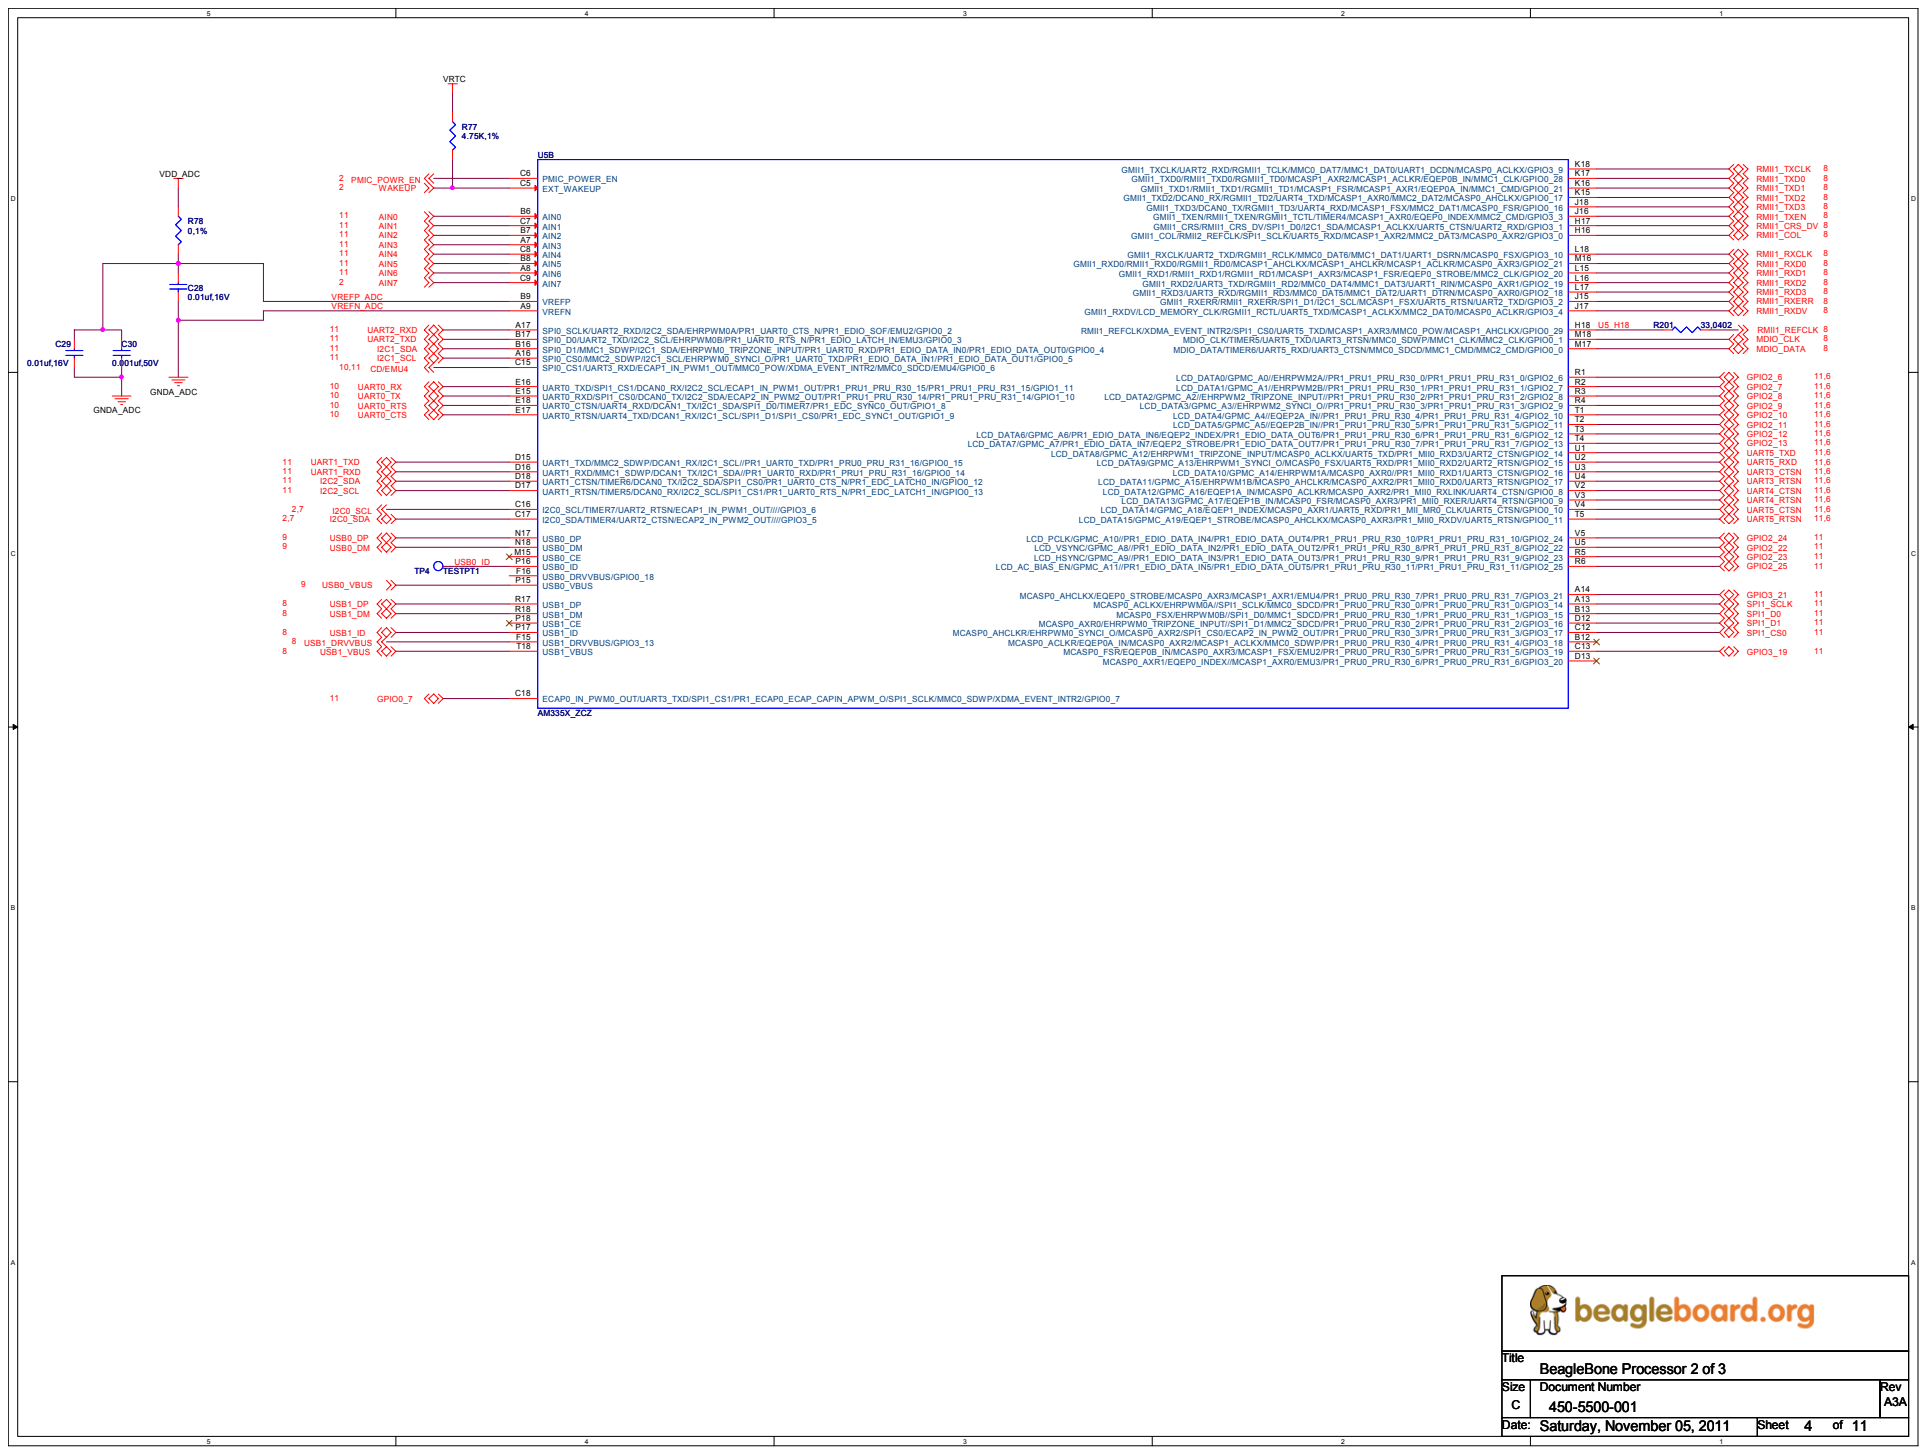
[picture p100: page 4]
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

Date: Date: Date: Saturday, November 05, 2011 Saturday, November 05, 2011 Saturday, November 05, 2011 | Sheet Sheet Sheet 4 4 4 of of of 11 11 11

## C540.01uf,16V

## C370.01uf,16V

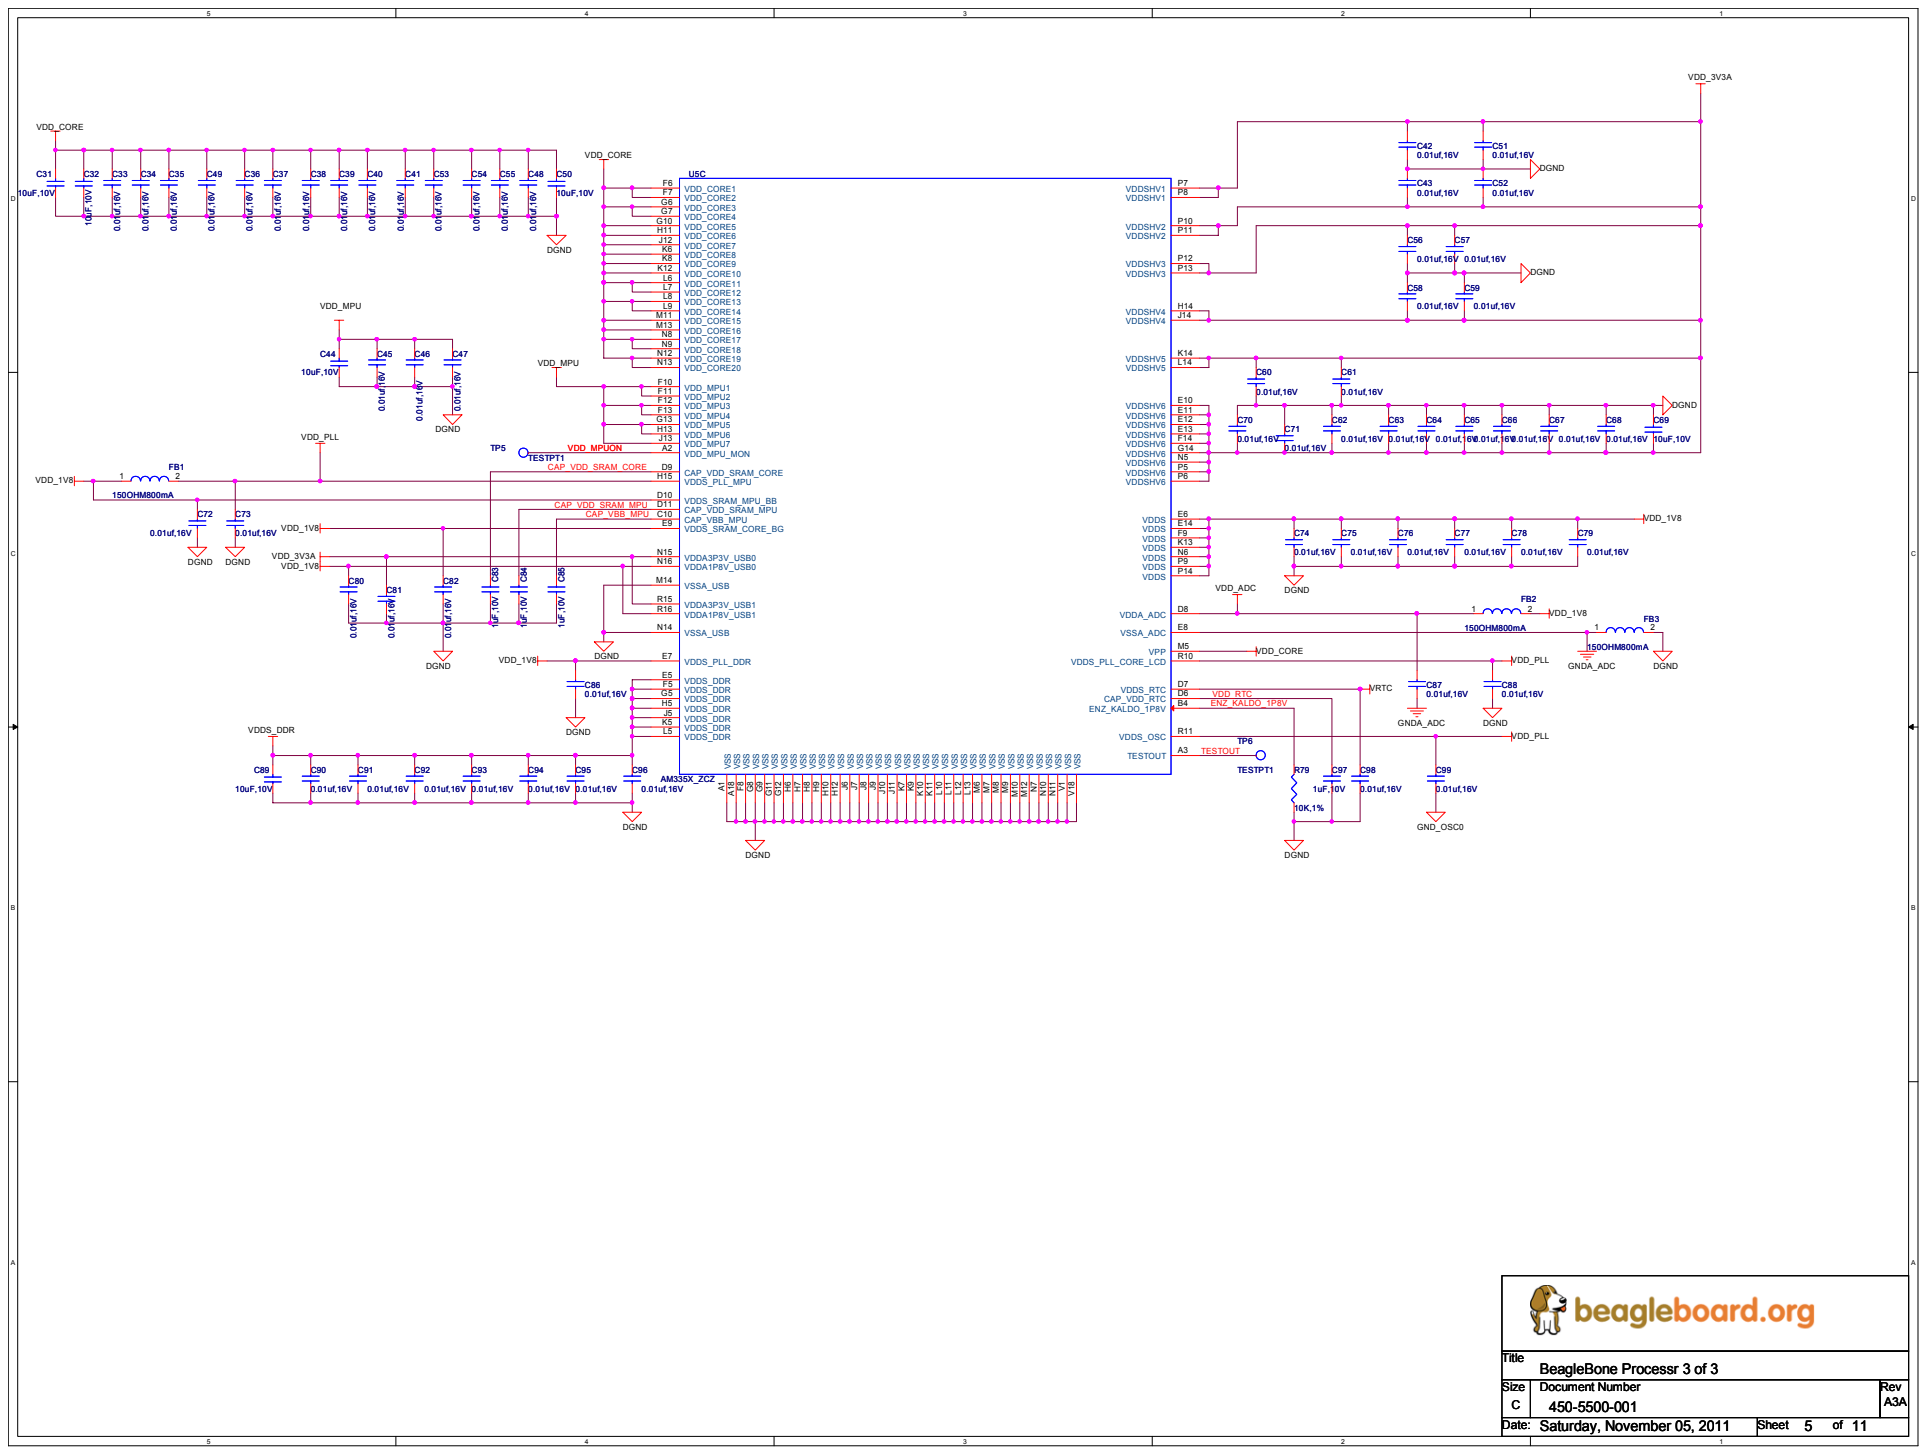
[picture p101: page 5]
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

Date: Date: Date: Saturday, November 05, 2011 Saturday, November 05, 2011 Saturday, November 05, 2011 | Sheet Sheet Sheet 5 5 5 of of of 11 11 11

## SYS_BOOT8 SYS_BOOT9

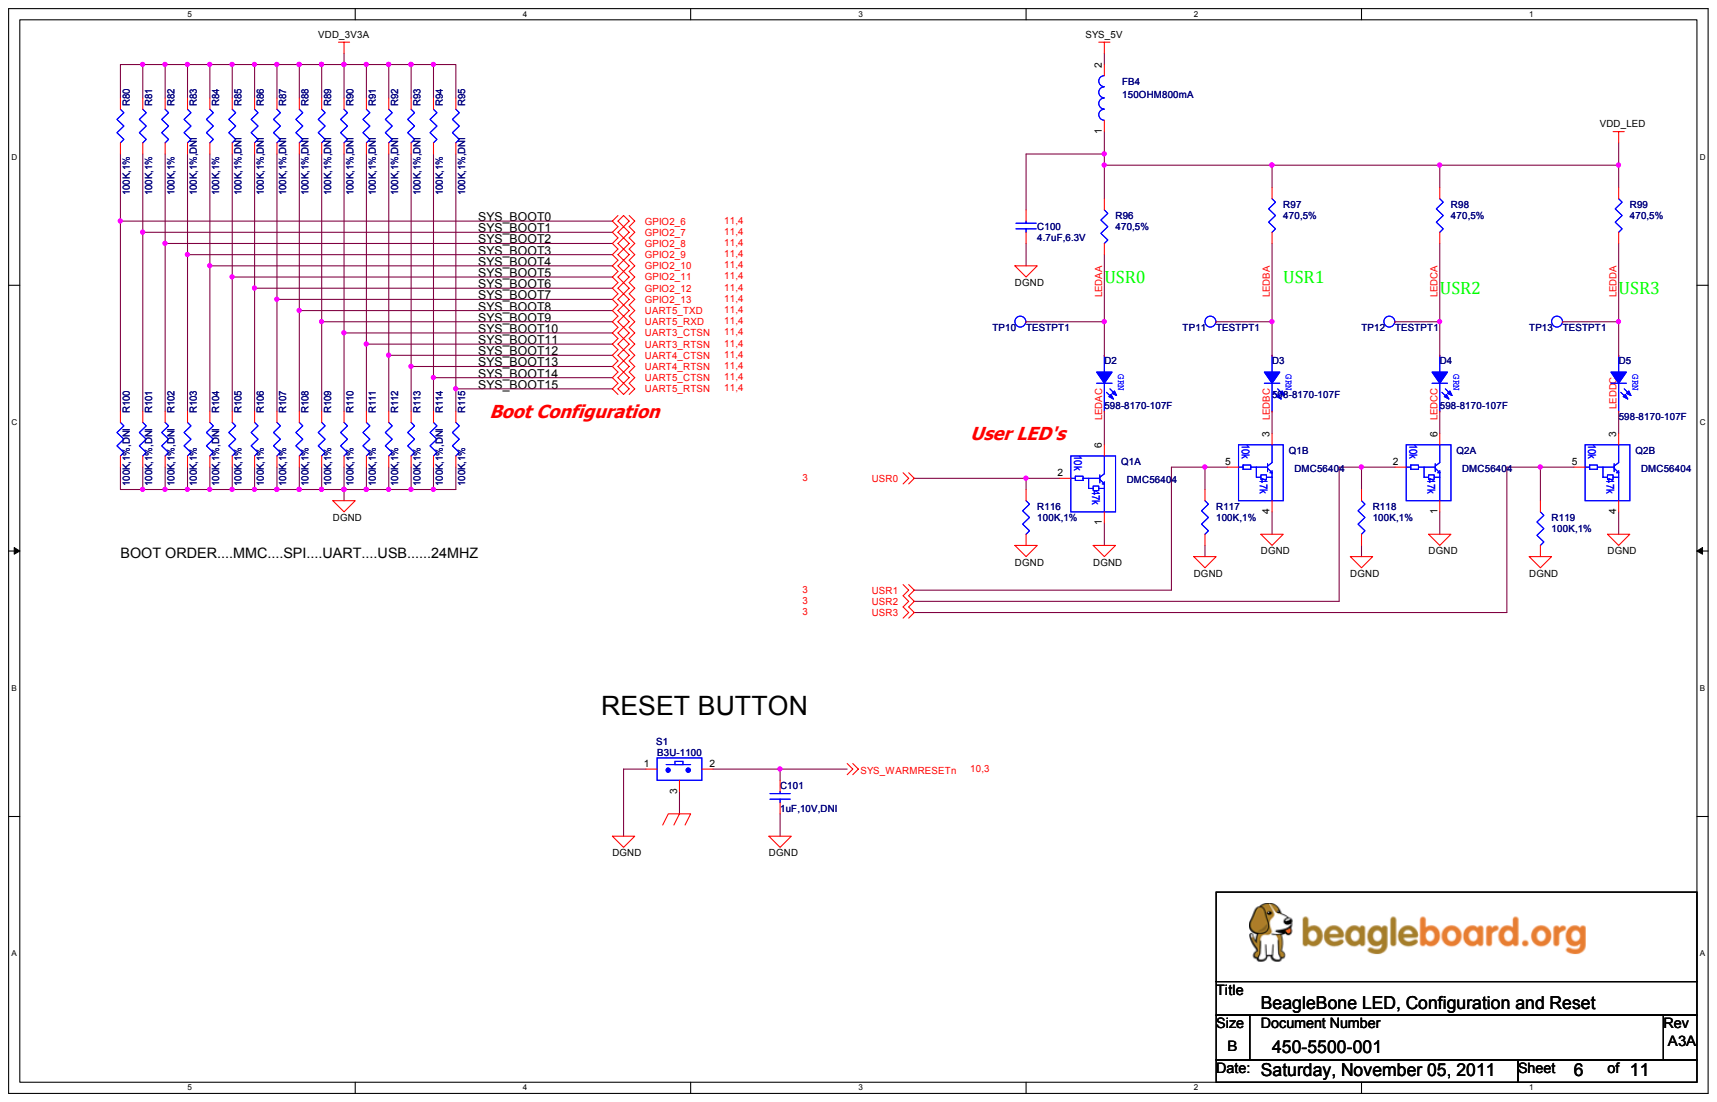
[picture p102: page 6]

BOOT ORDER....MMC....SPI....UART....USB......24MHZ

Title
BeagleBone LED, Configuration and Reset

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

Date: Date: Date: Saturday, November 05, 2011 Saturday, November 05, 2011 Saturday, November 05, 2011 | Sheet Sheet Sheet 6 6 6 of of of 11 11 11

# Variable & MAC Memory

### DDR_A13R

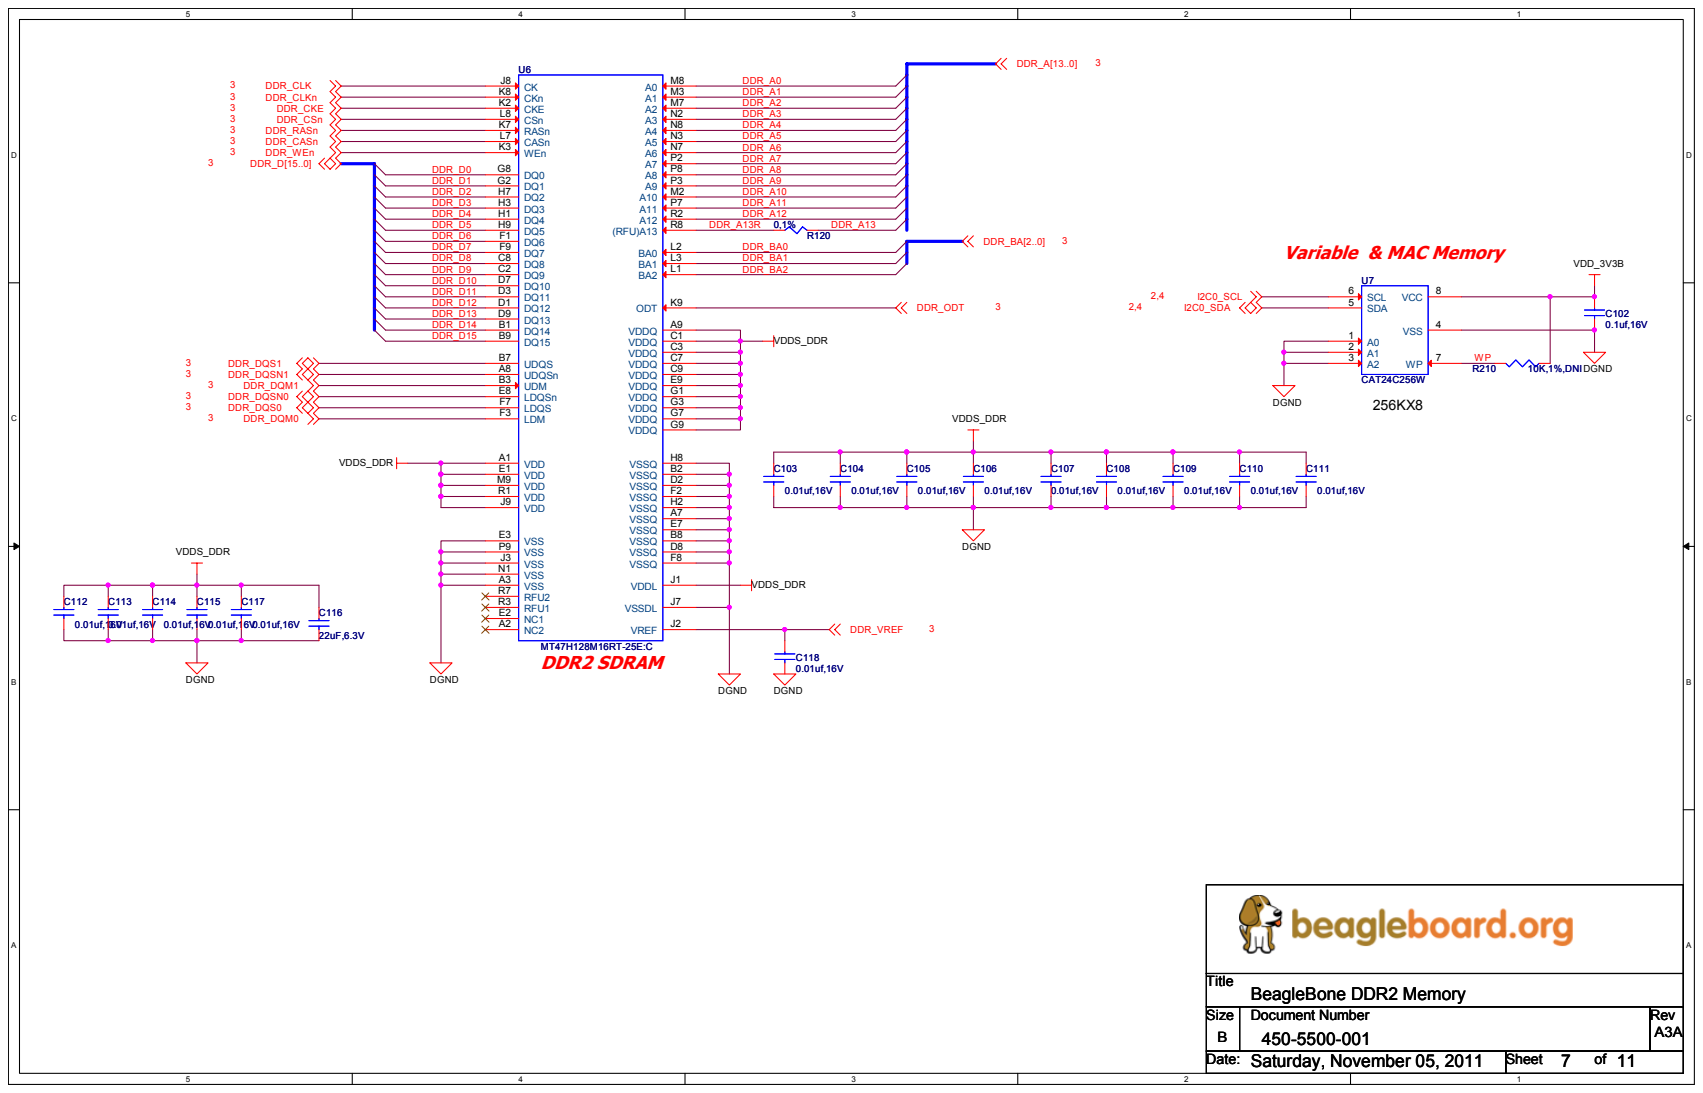
[picture p103: page 7]
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

Date: Date: Date: Saturday, November 05, 2011 Saturday, November 05, 2011 Saturday, November 05, 2011 | Sheet Sheet Sheet 7 7 7 of of of 11 11 11

# ETHERNET CONNECTOR

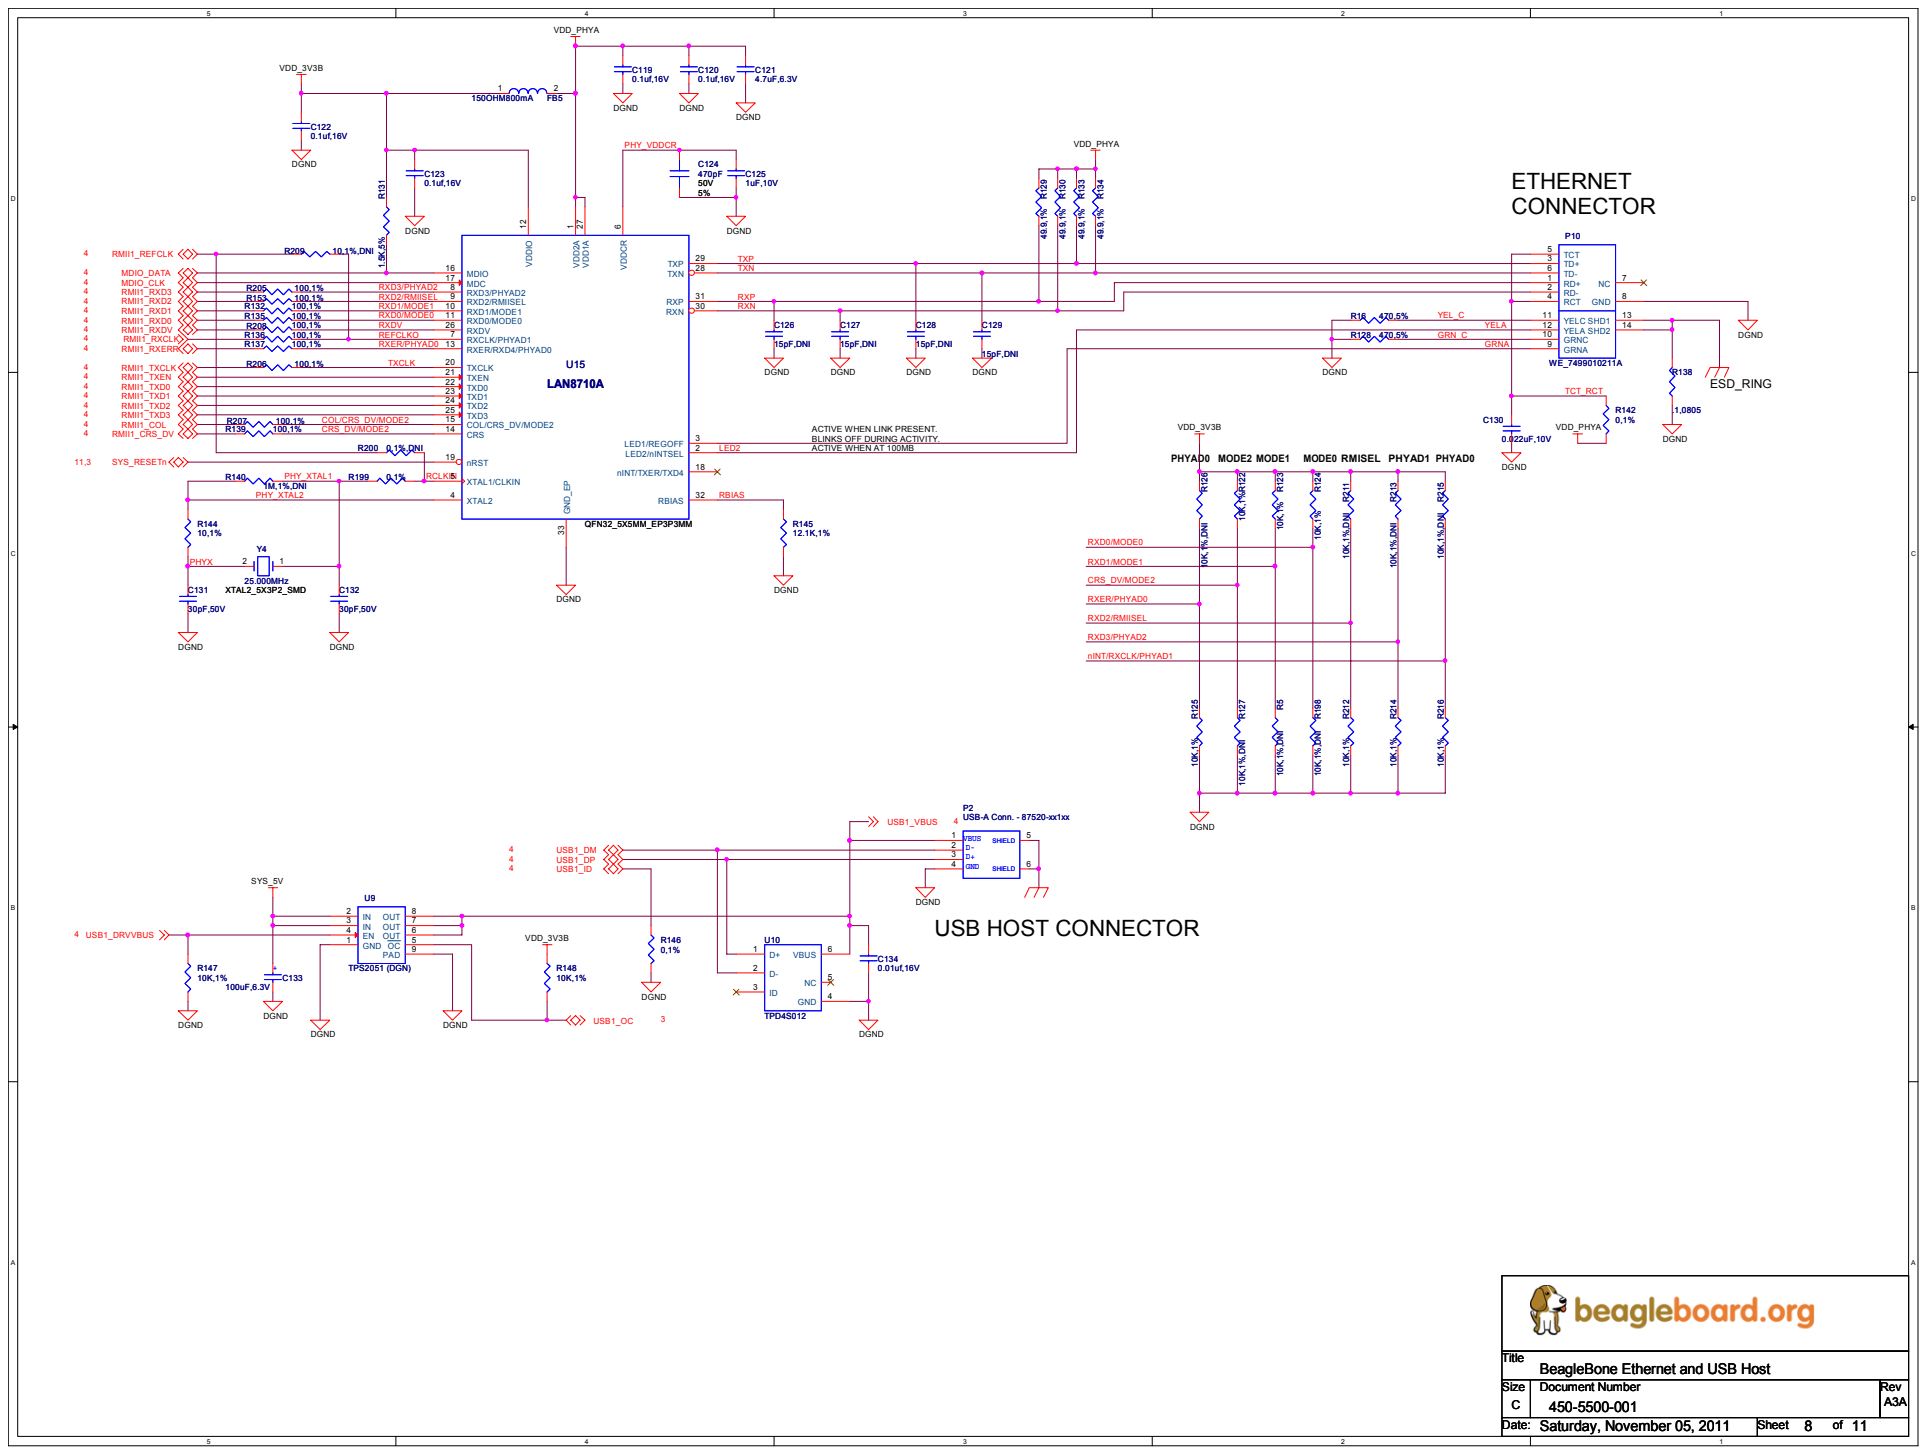
[picture p104: page 8]

ACTIVE WHEN LINK PRESENT.
BLINKS OFF DURING ACTIVITY.
ACTIVE WHEN AT 100MB

Title
BeagleBone Ethernet and USB Host

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

Date: Date: Date: Saturday, November 05, 2011 Saturday, November 05, 2011 Saturday, November 05, 2011 | Sheet Sheet Sheet 8 8 8 of of of 11 11 11

# USB PC CONNECTOR

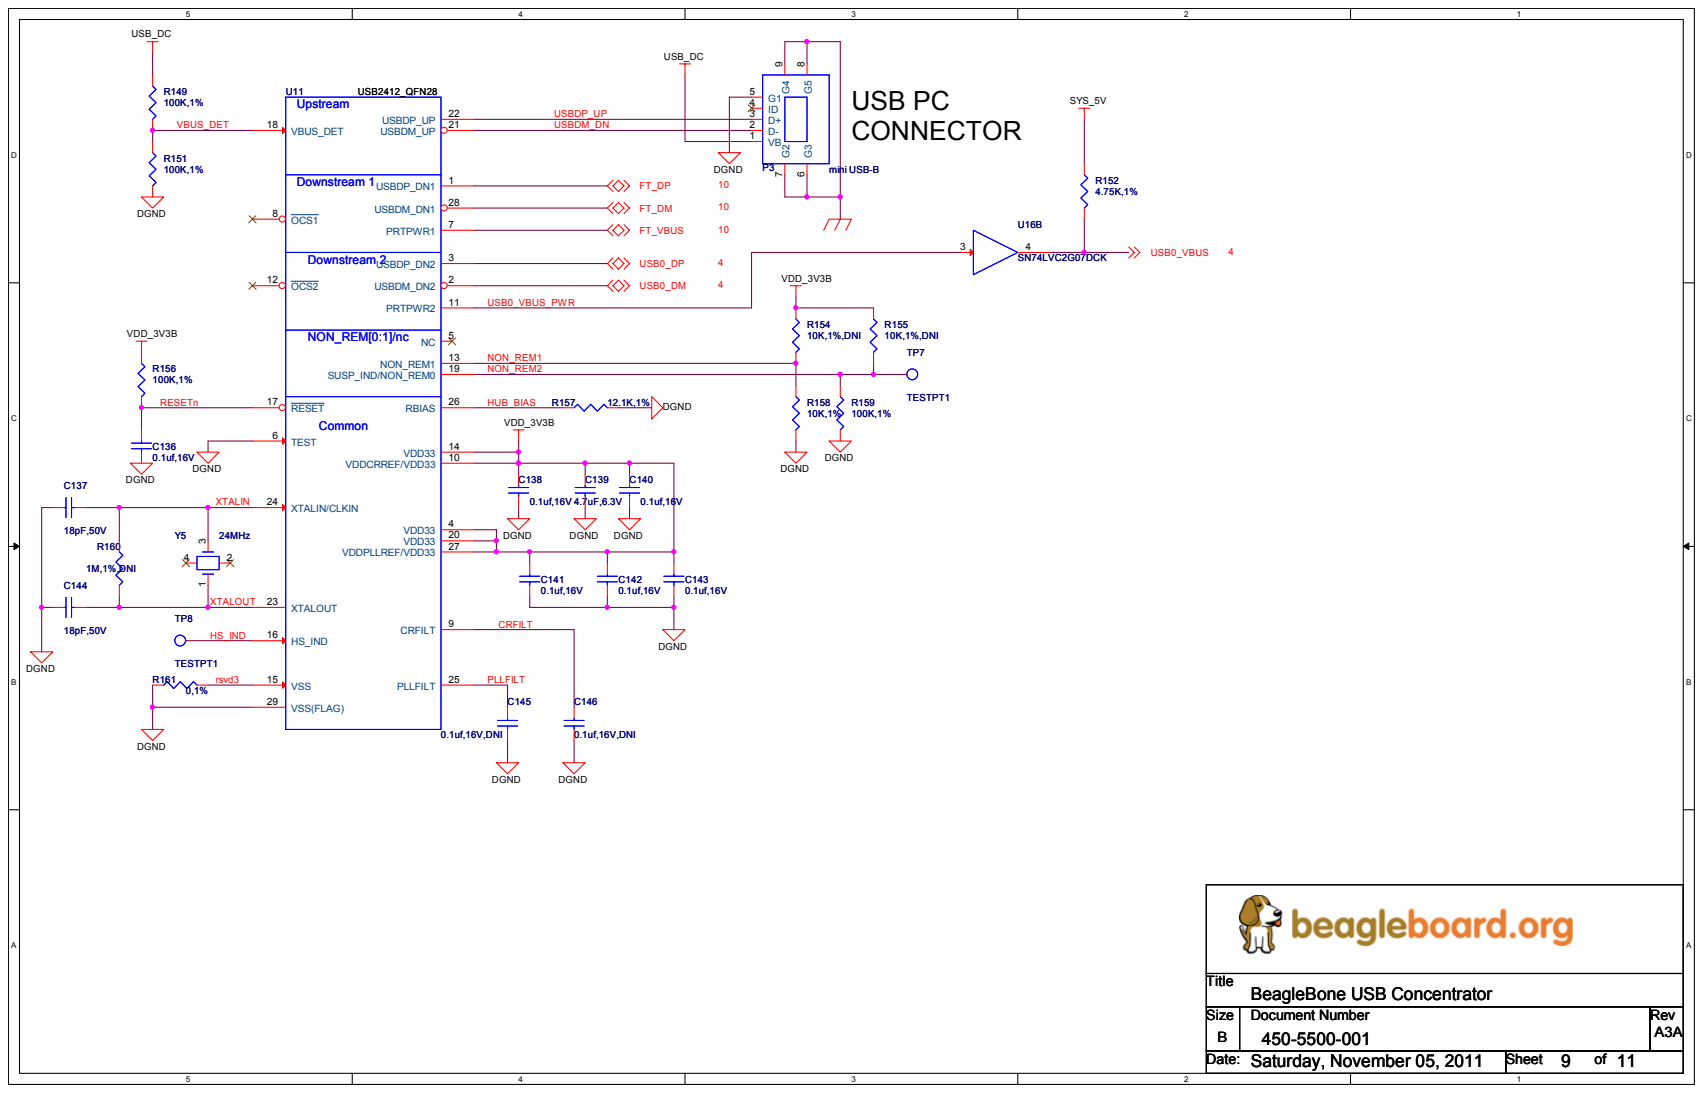
[picture p105: page 9]
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

Date: Date: Date: Saturday, November 05, 2011 Saturday, November 05, 2011 Saturday, November 05, 2011 | Sheet Sheet Sheet 9 9 9 of of of 11 11 11

### VDD_FTREGIN

### VDD_FTVPLL

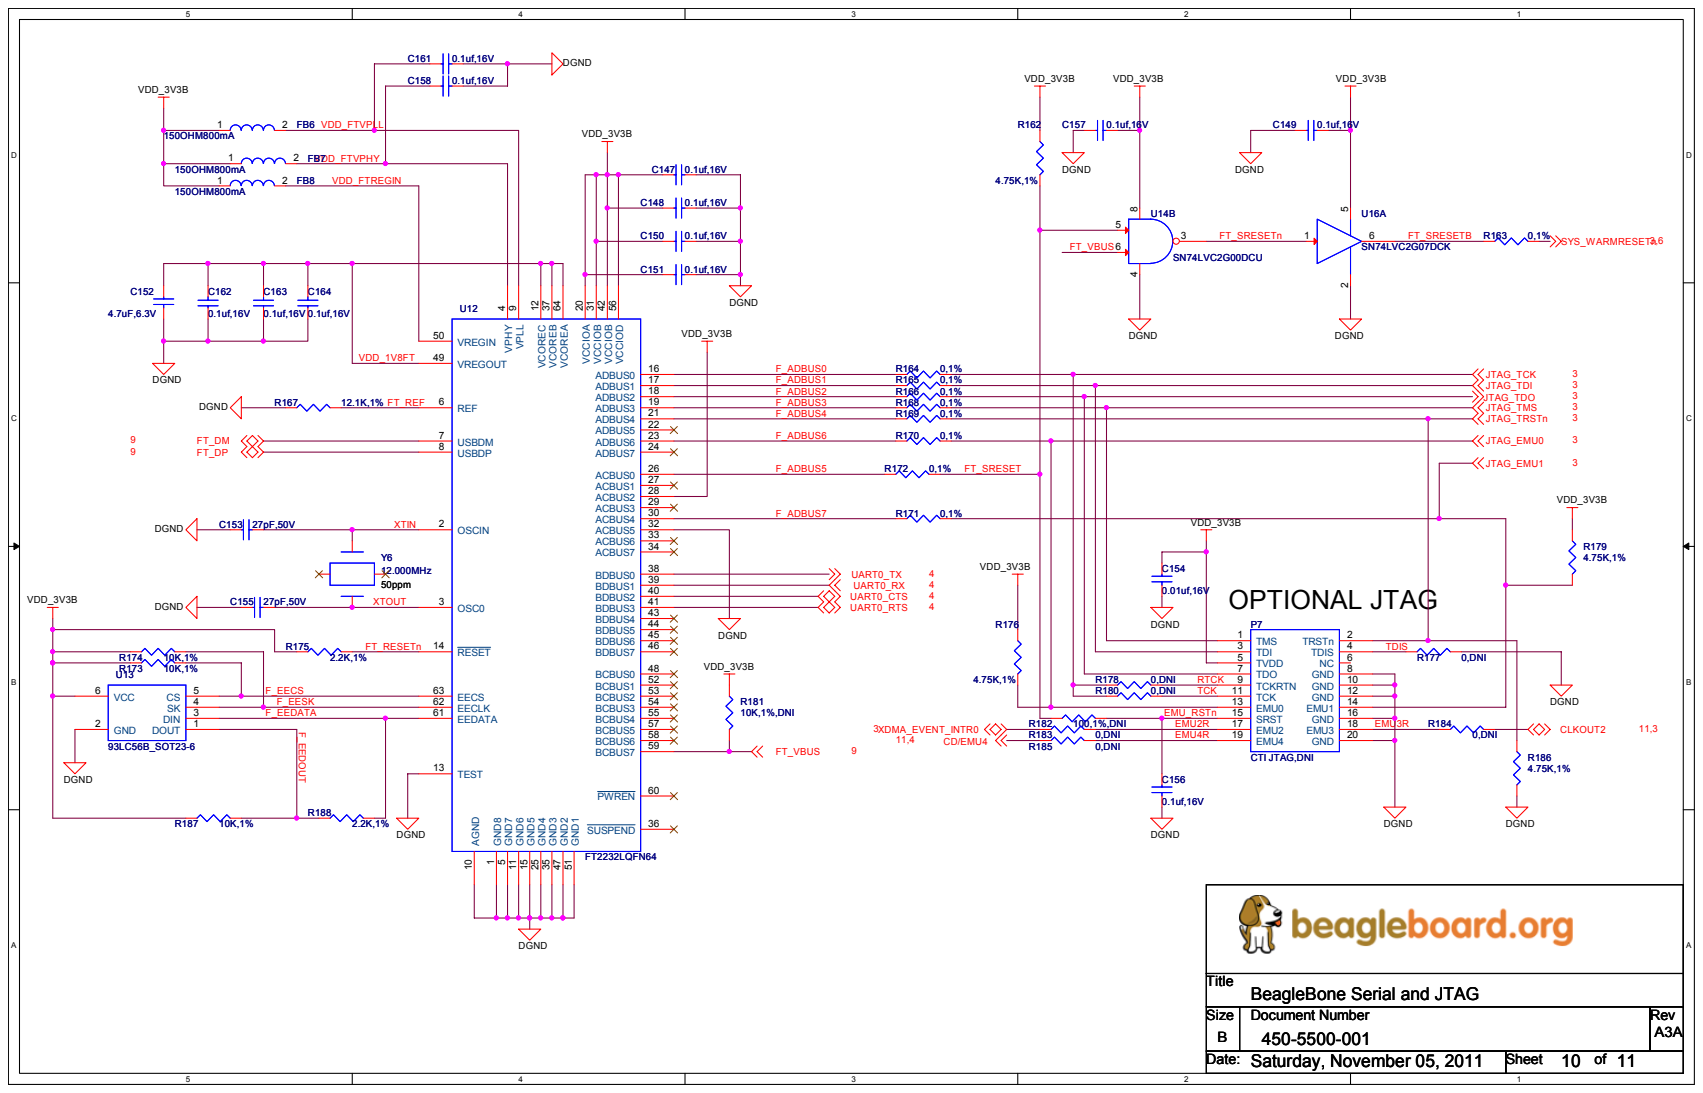
[picture p106: page 10]

Title
BeagleBone Serial and JTAG

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

Date: Date: Date: Saturday, November 05, 2011 Saturday, November 05, 2011 Saturday, November 05, 2011 | Sheet Sheet Sheet 10 10 10 of of of 11 11 11

### DGND

### VDD_5V

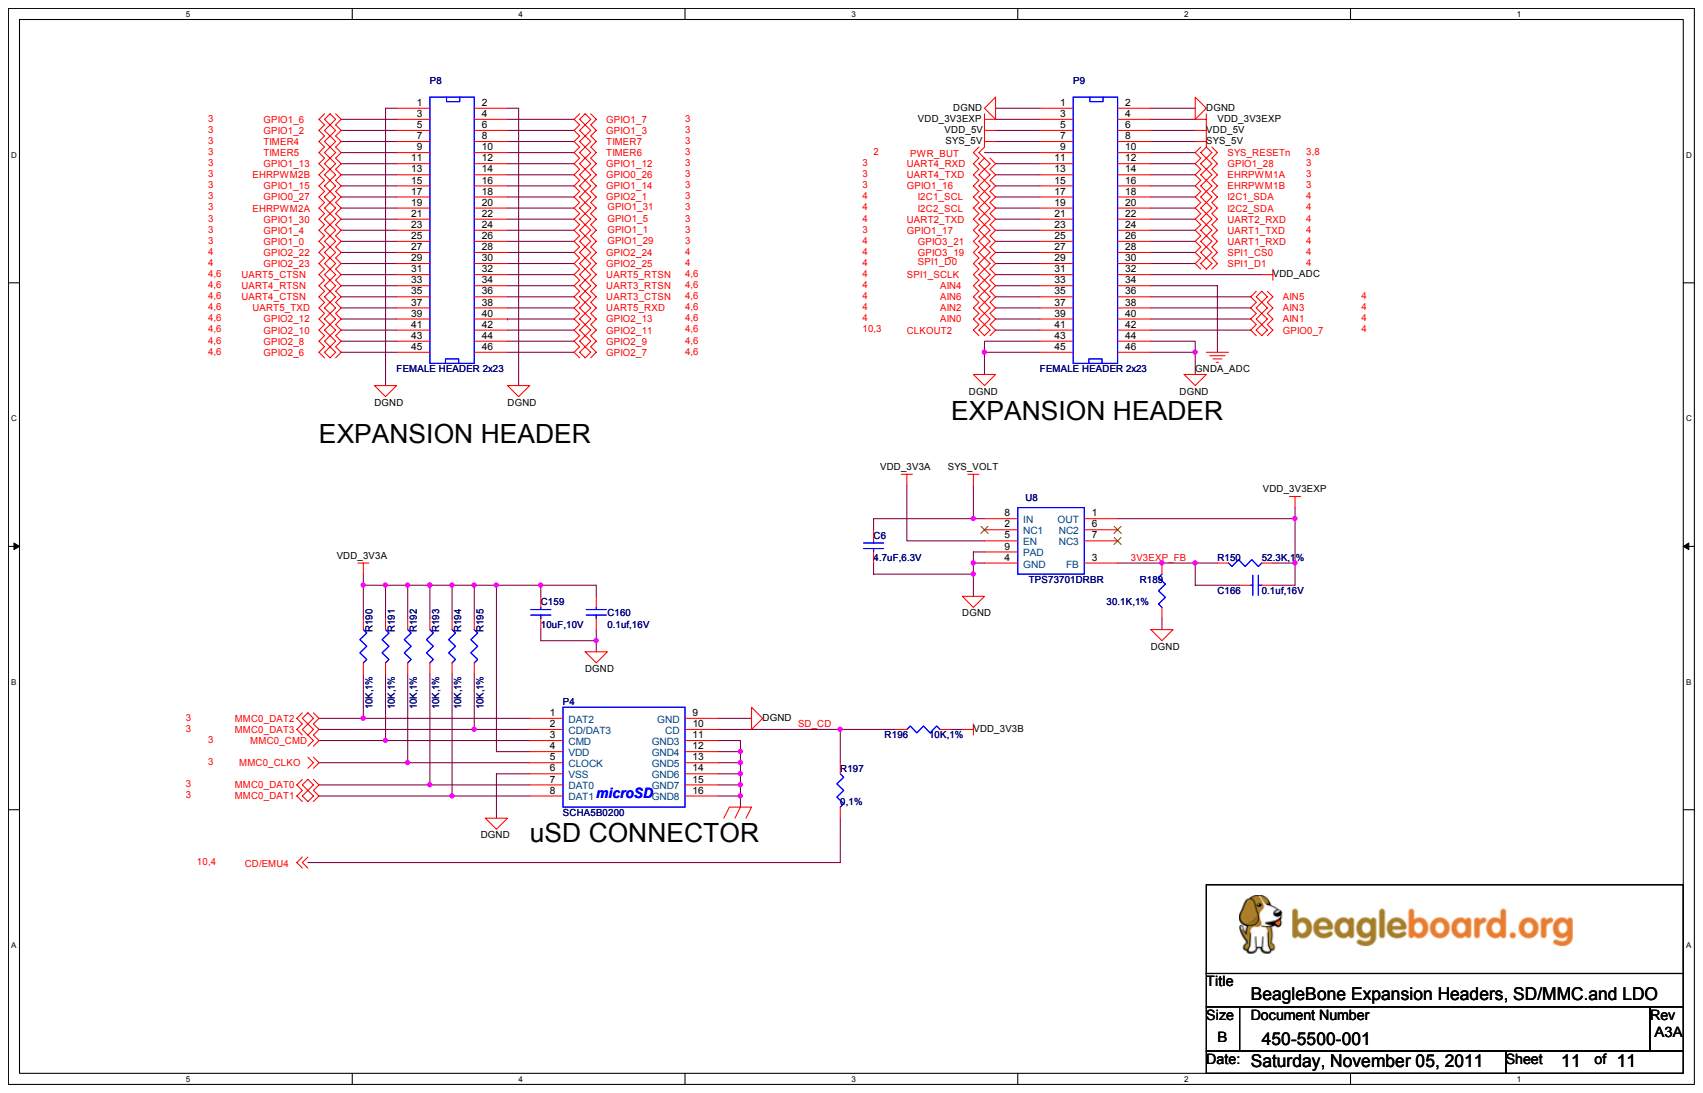
[picture p107: page 11]

Title
BeagleBone Expansion Headers, SD/MMC.and LDO

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

Date: Date: Date: Saturday, November 05, 2011 Saturday, November 05, 2011 Saturday, November 05, 2011 | Sheet Sheet Sheet 11 11 11 of of of 11 11 11
