meetmrhung/eyecu/documentation/budget/capstone_digikey_feb29.pdf

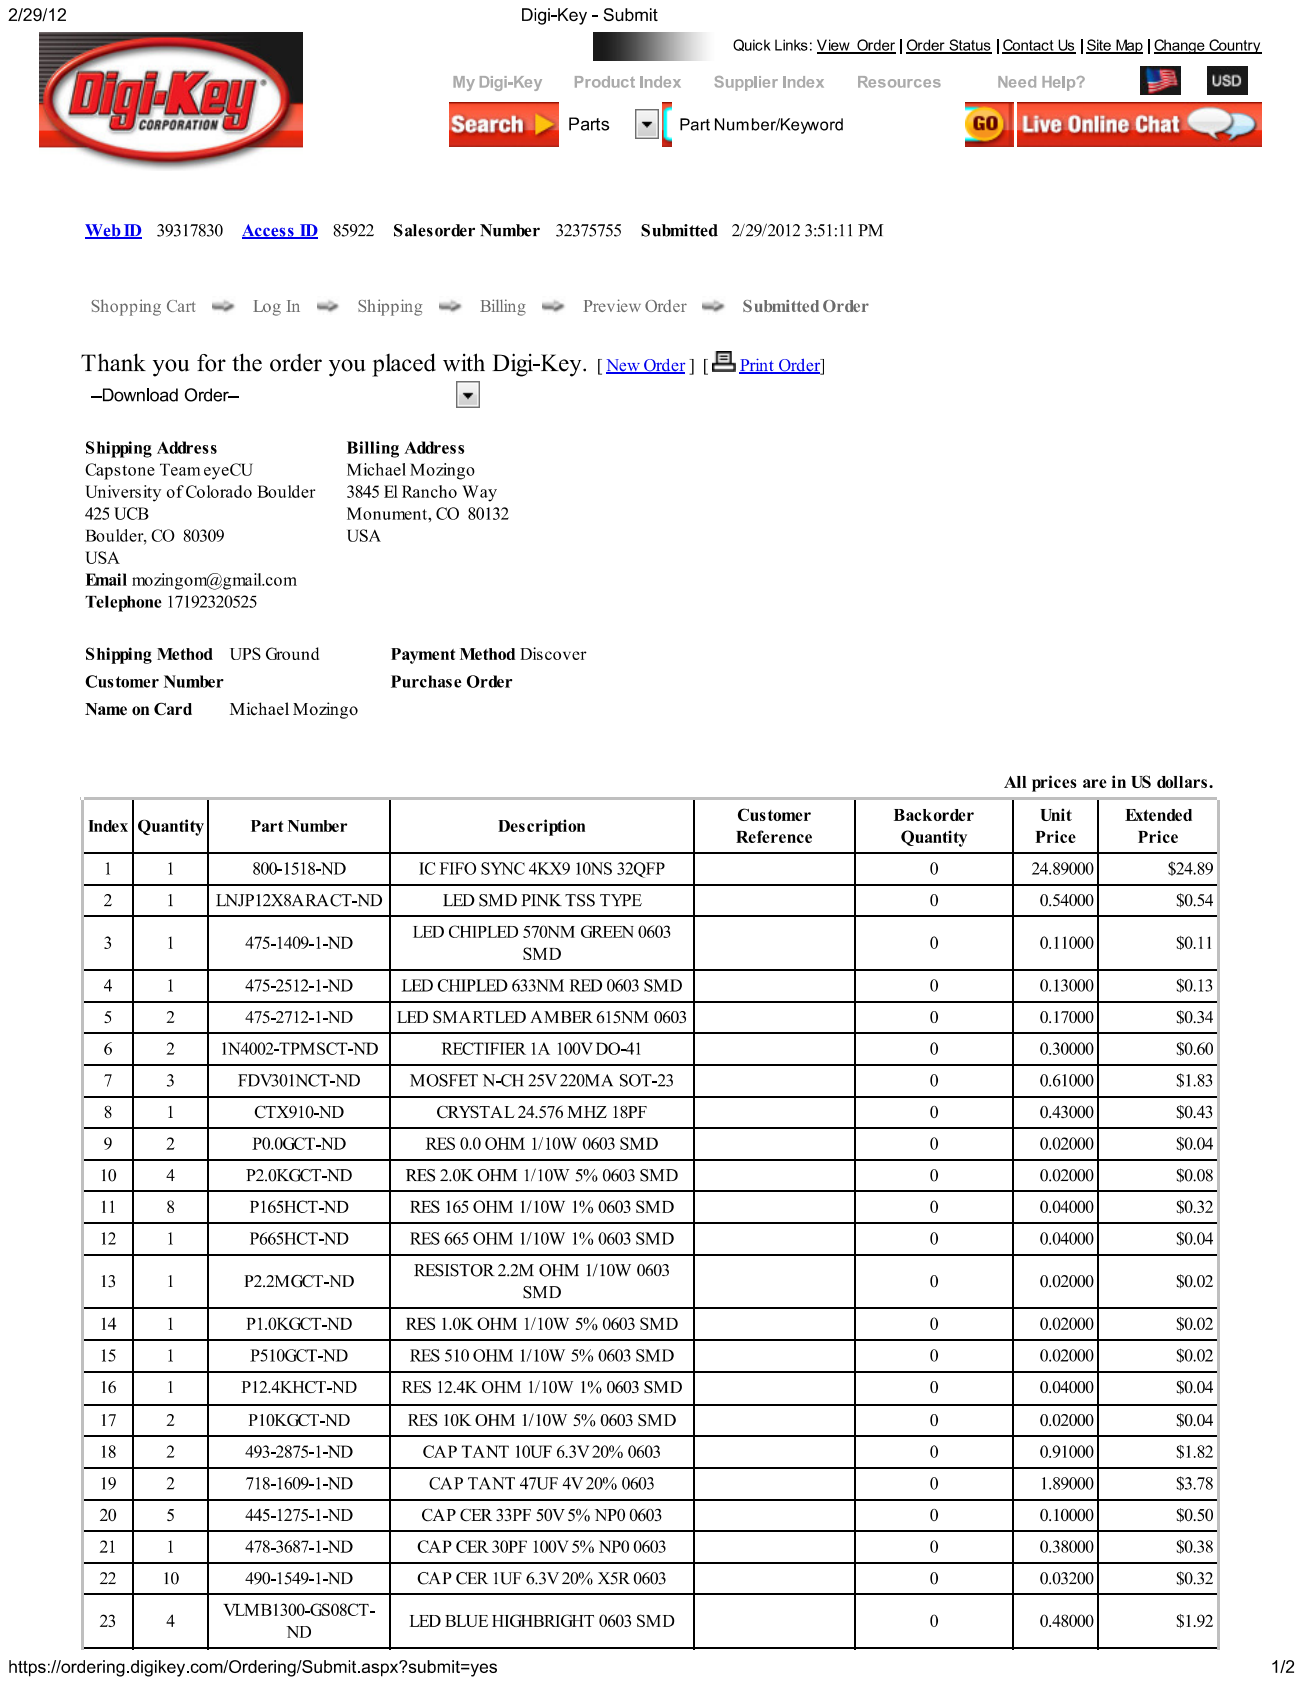
[picture p108: page 1]

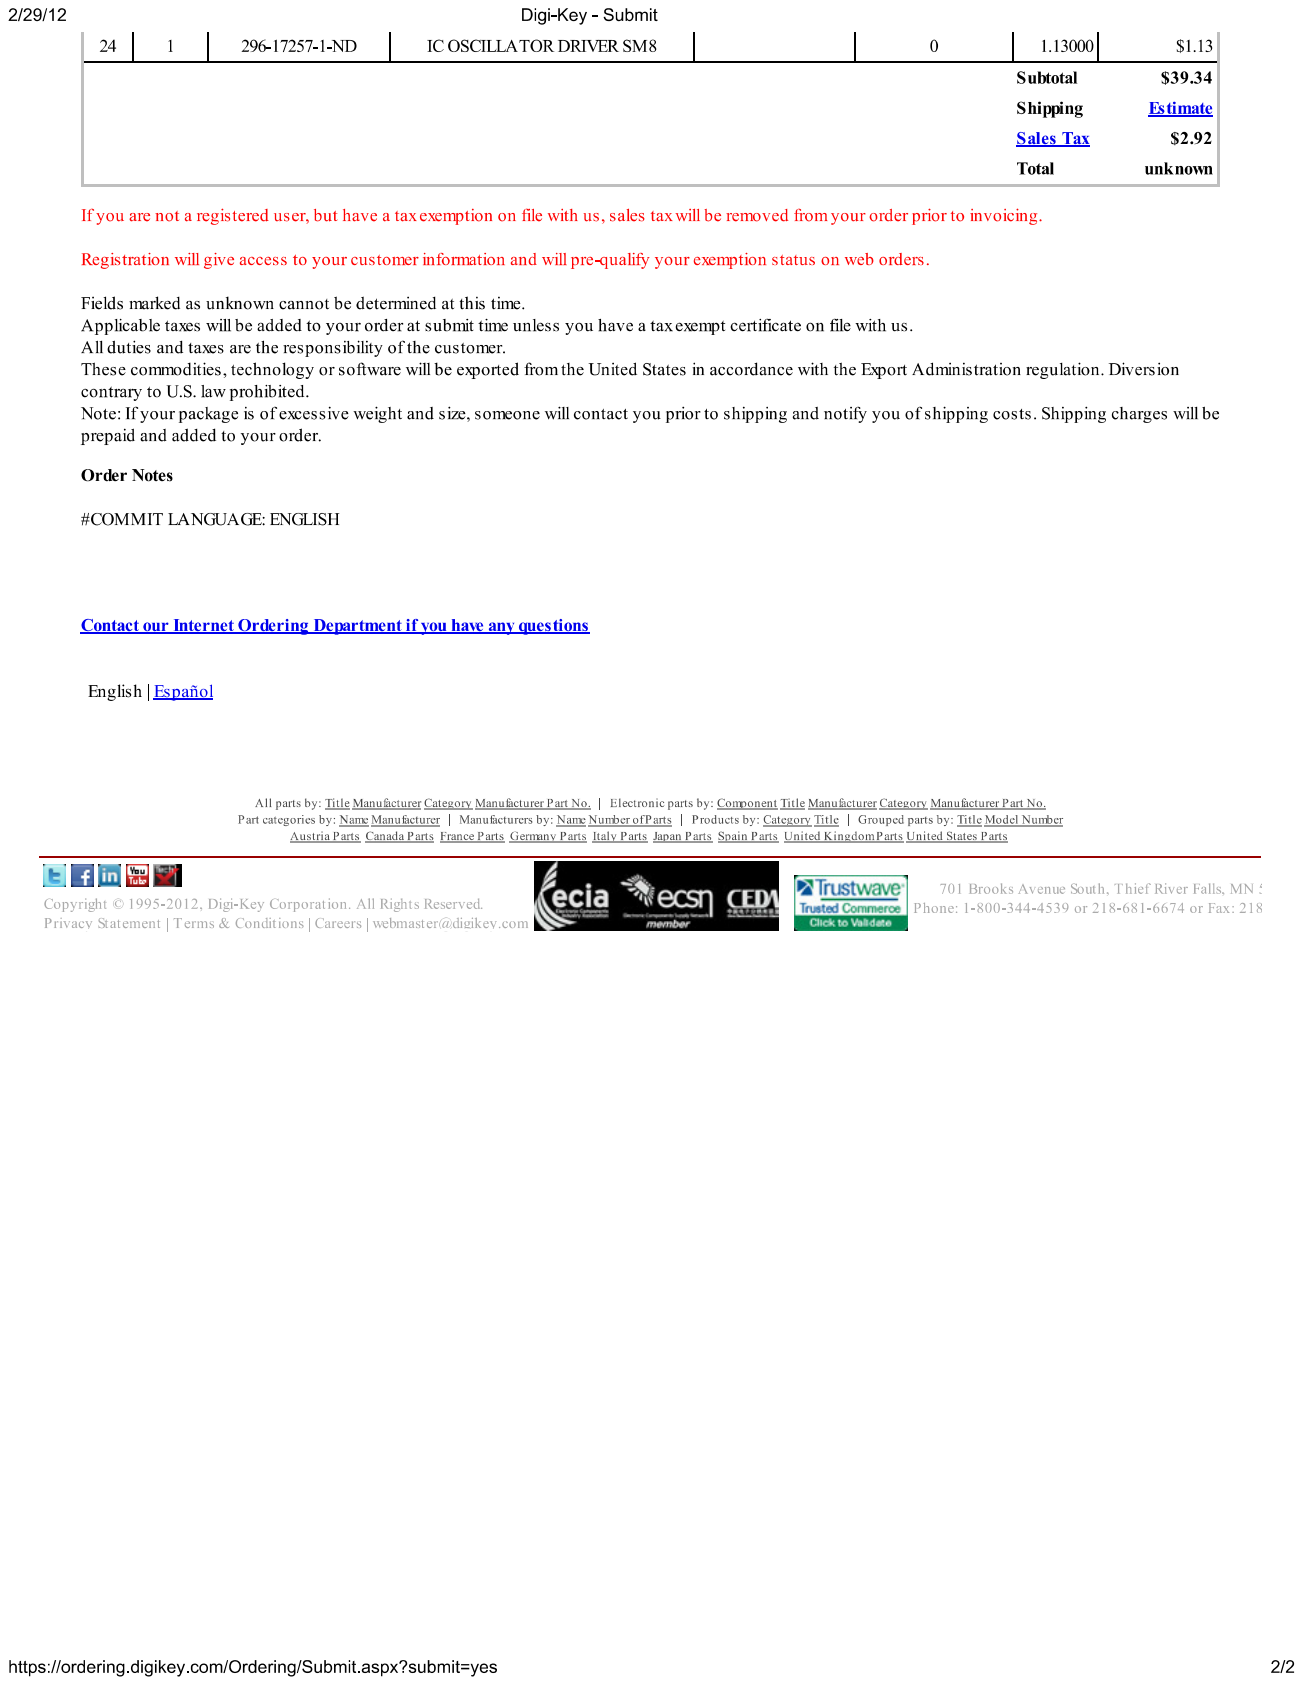
[picture p109: page 2]
