meetmrhung/eyecu/documentation/budget/capstone_samtec_feb29.pdf

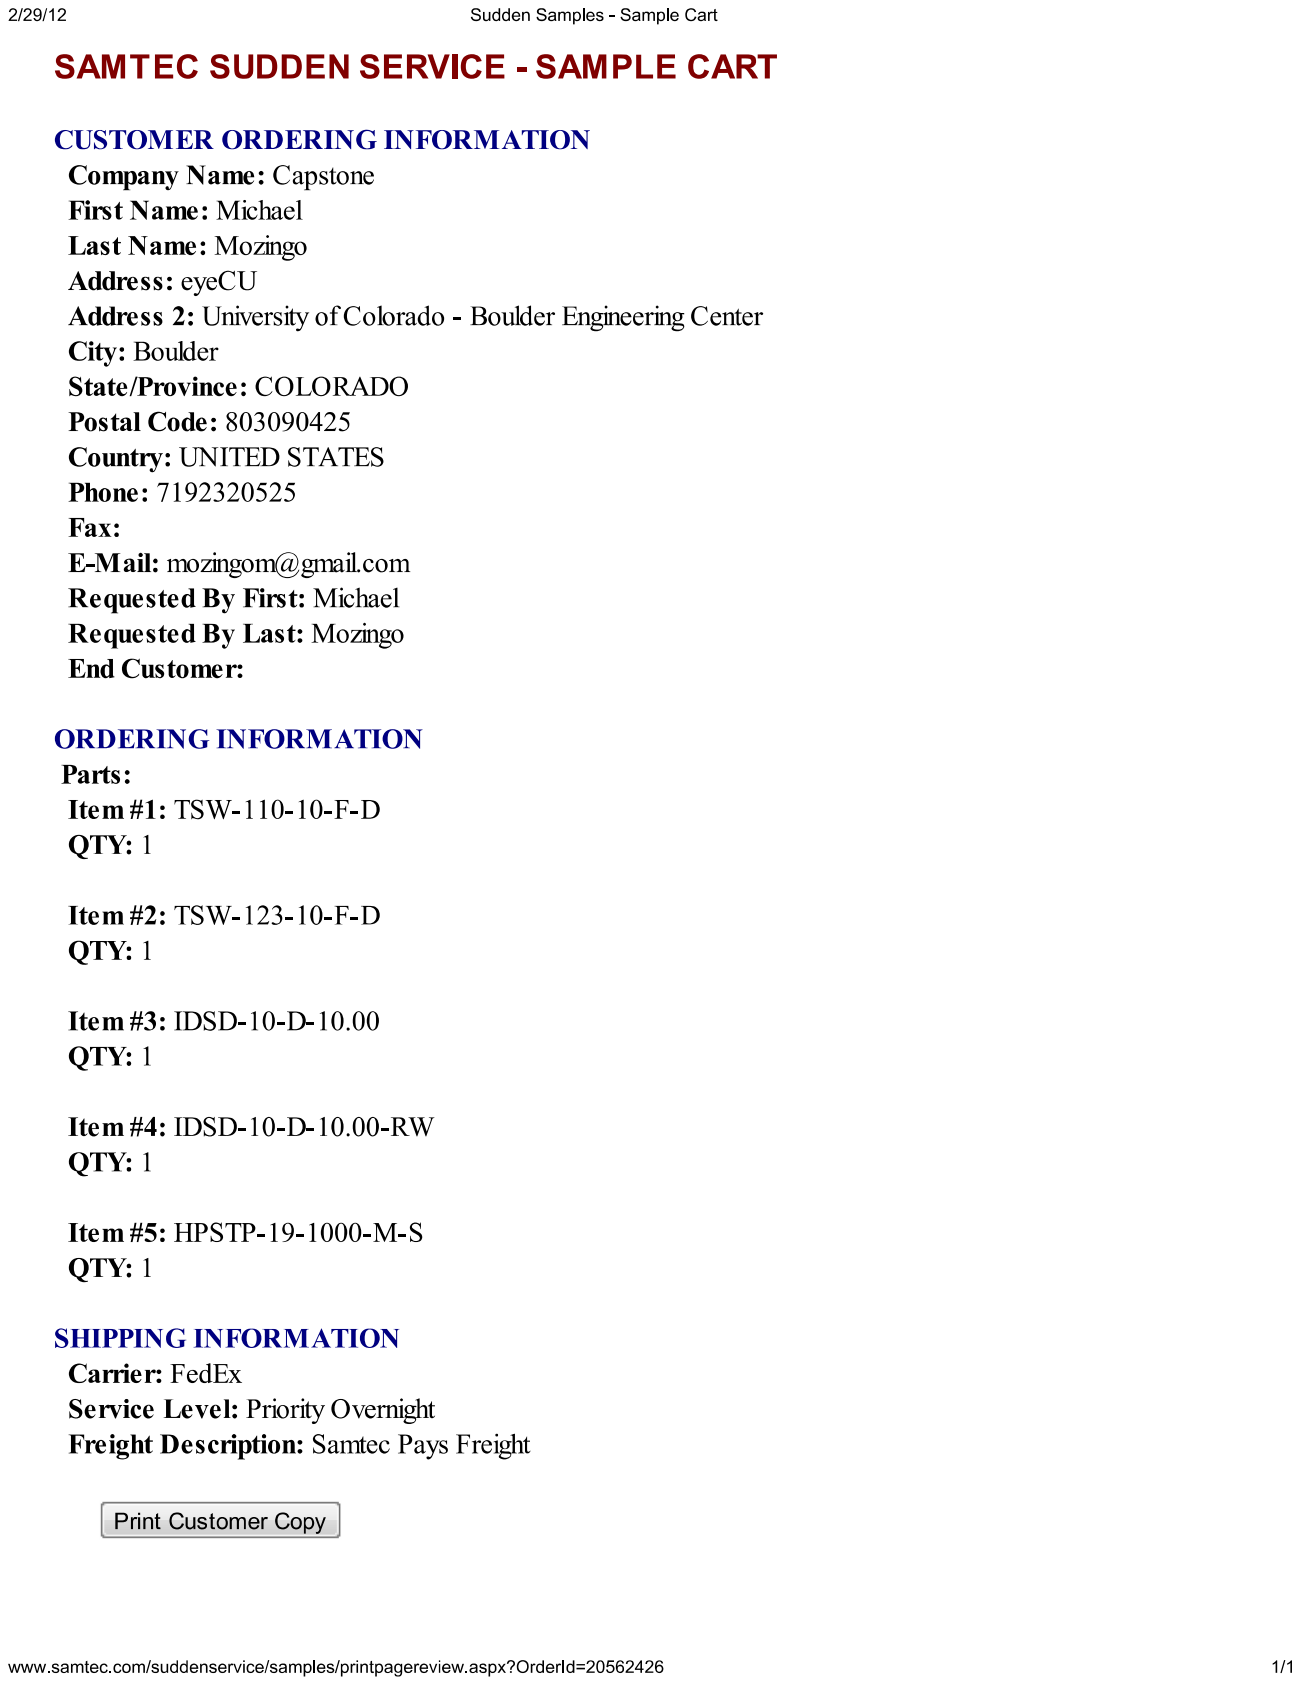
[picture p110: page 1]
