meetmrhung/eyecu/documentation/budget/Capstone_ti_samples_feb_29.pdf

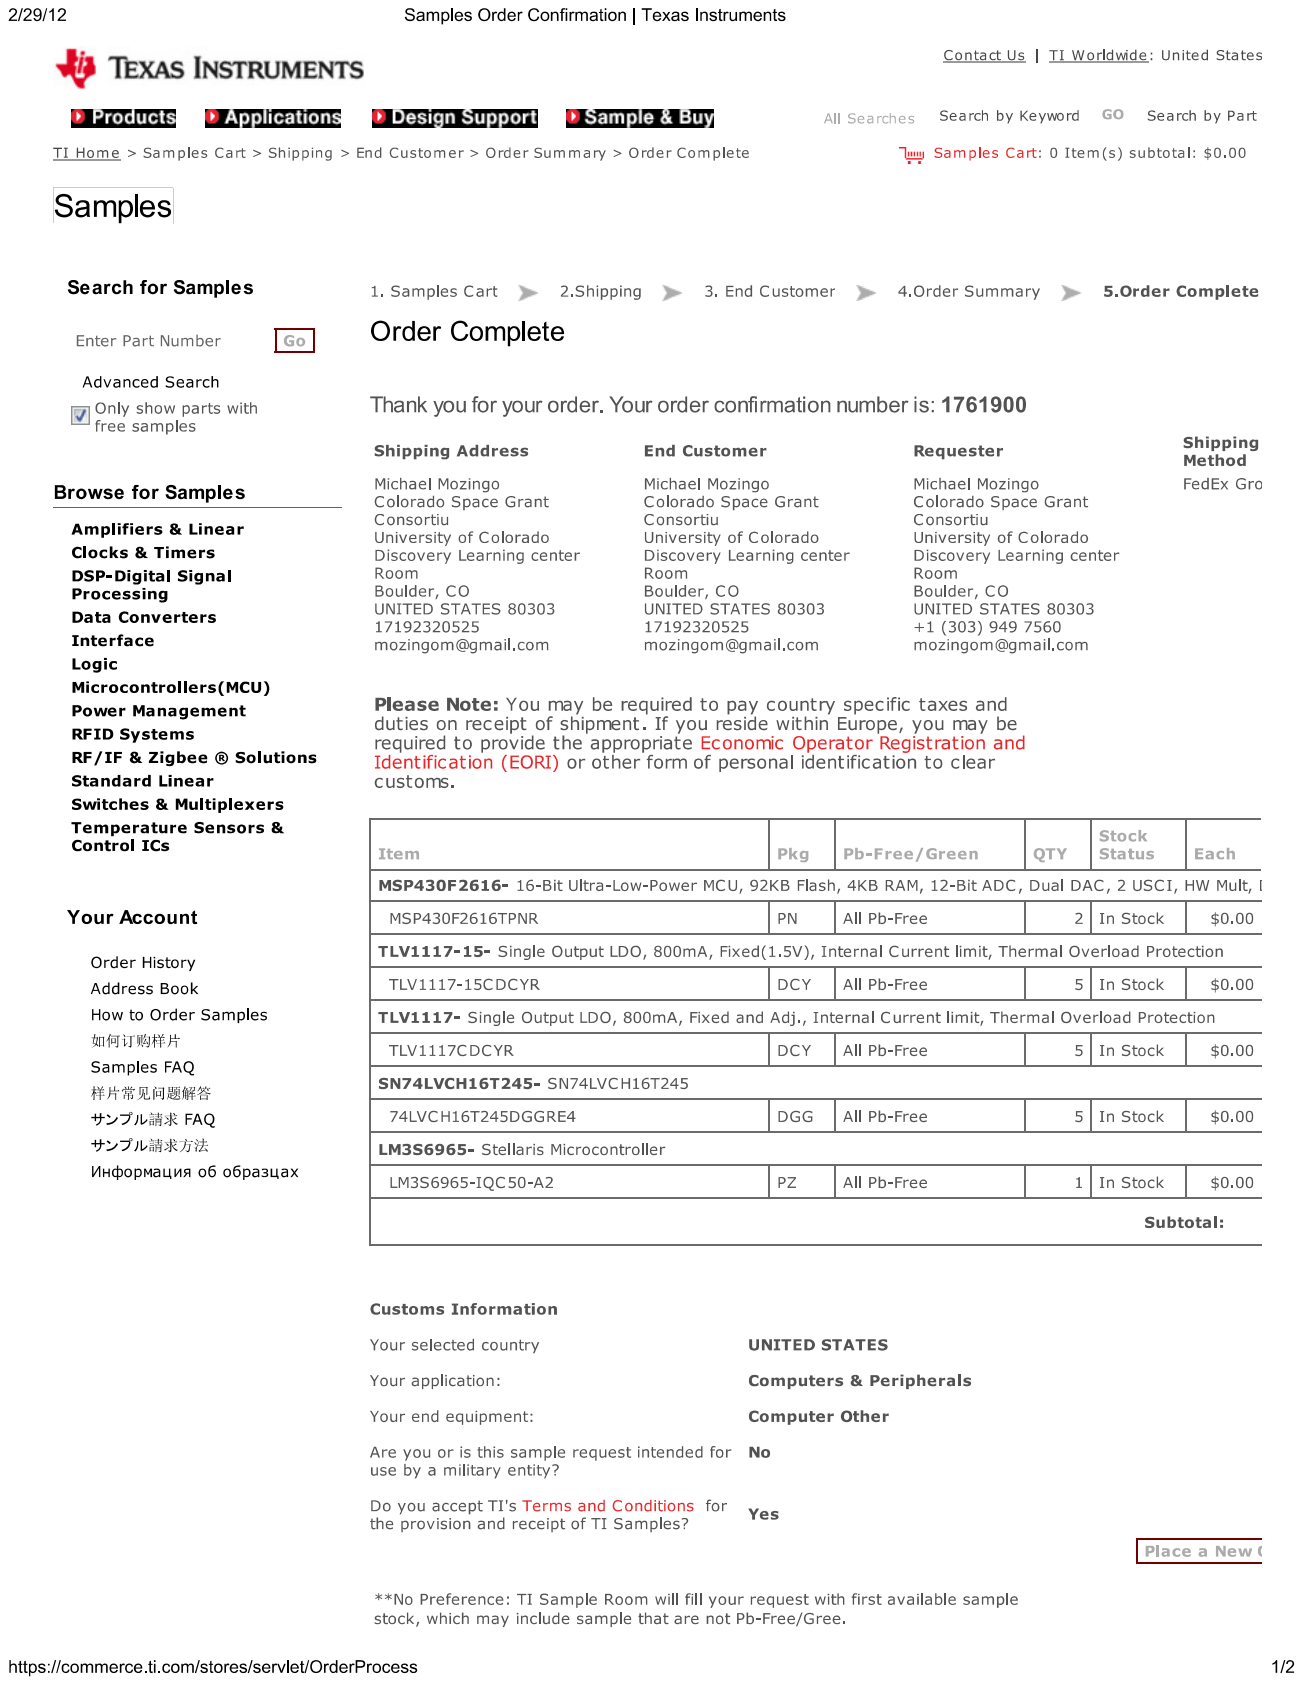
[picture p111: page 1]

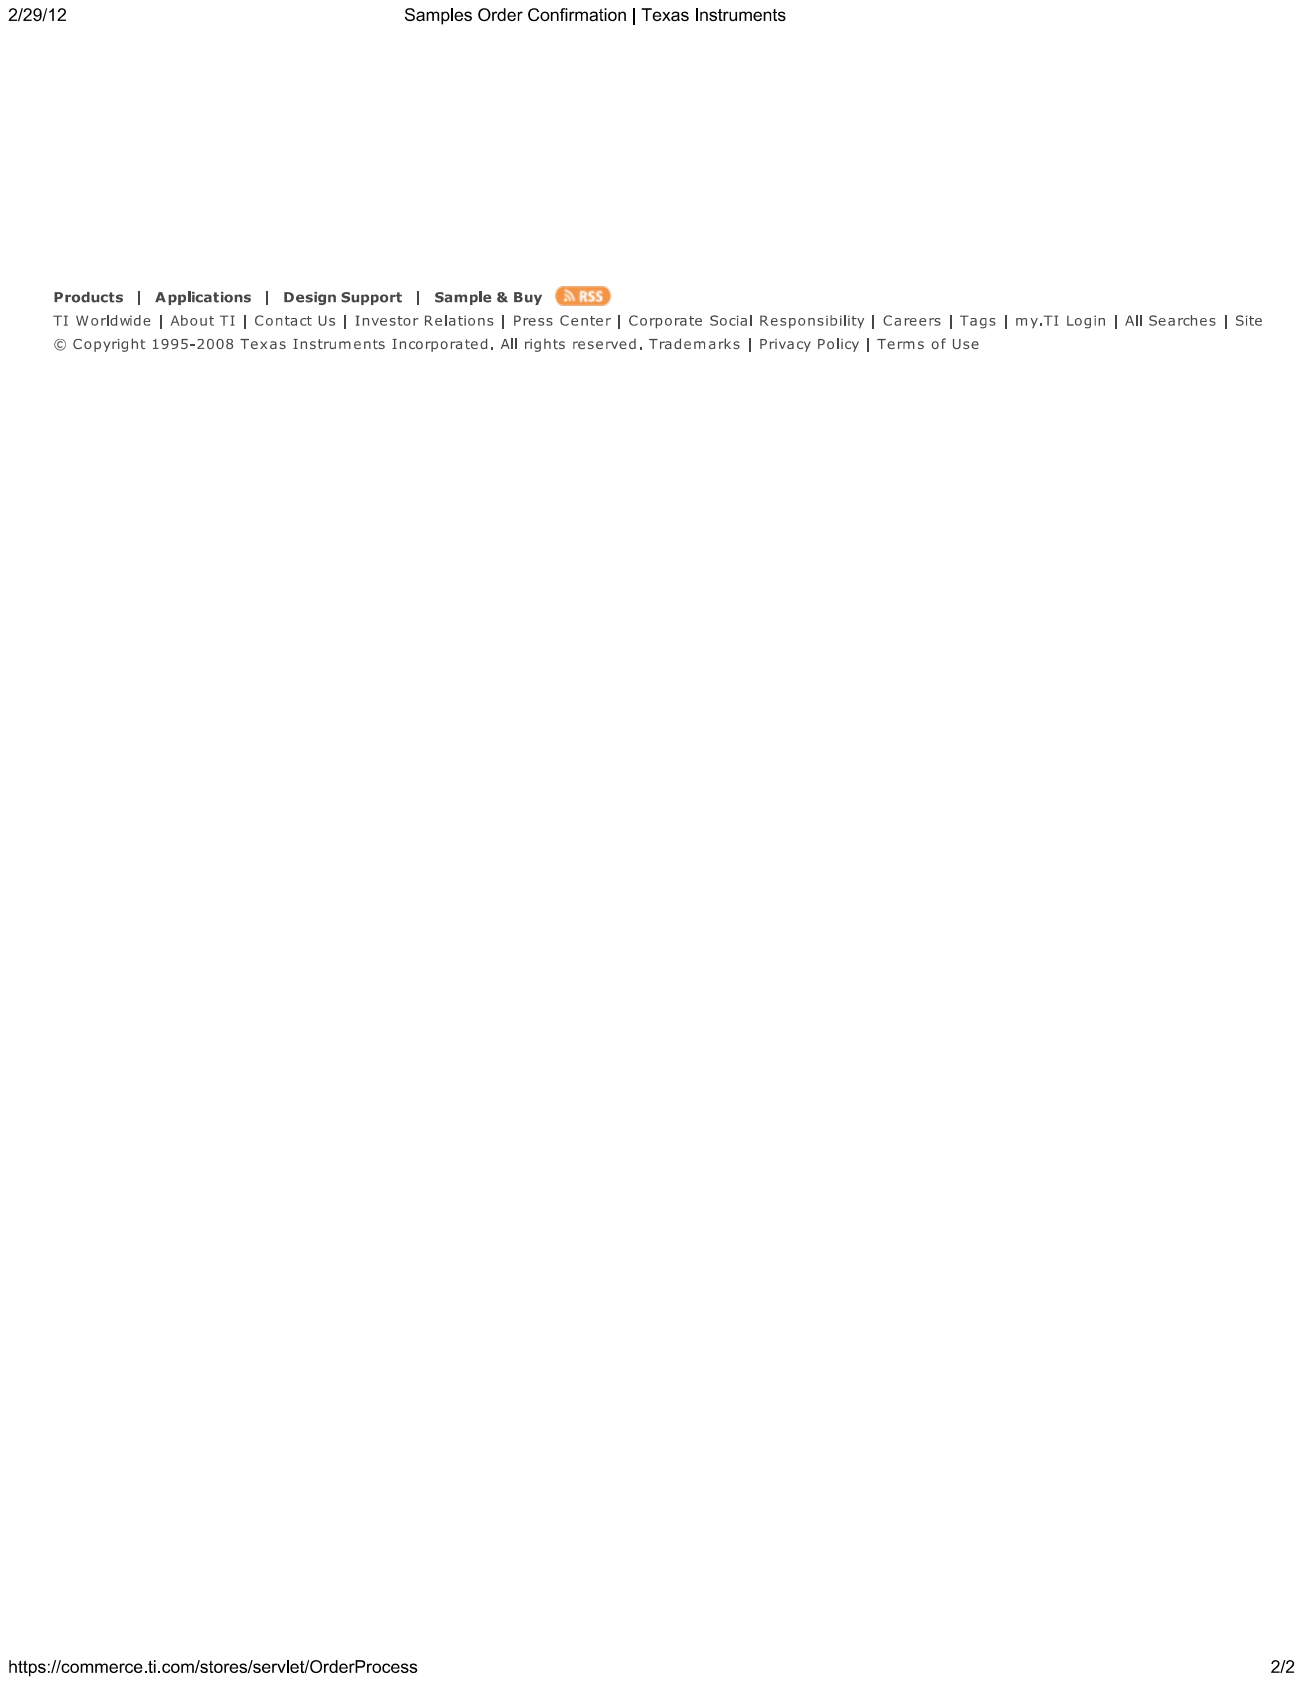
[picture p112: page 2]
