meetmrhung/eyecu/documentation/TechnicalManual/Arielle/MSP430BoardProject.pdf

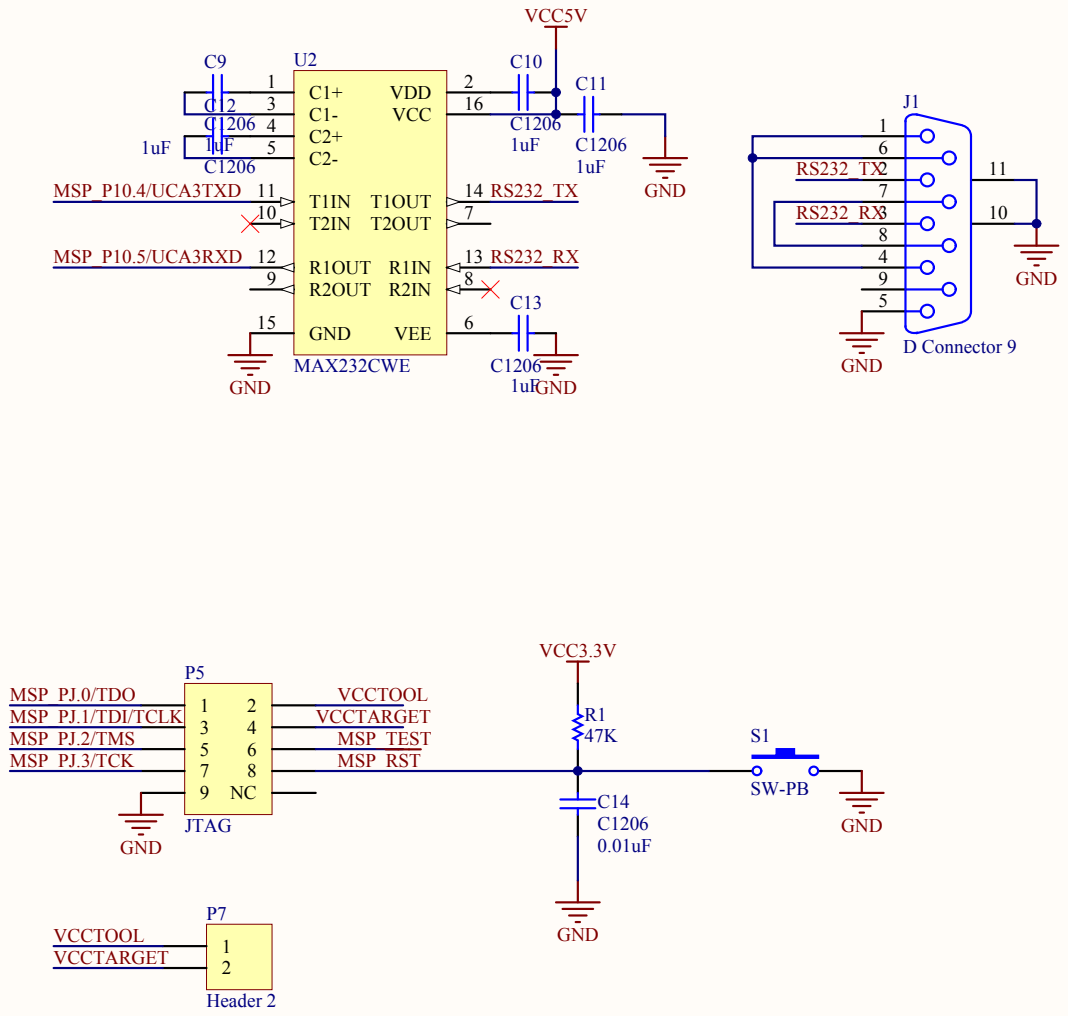
[picture p113: page 1]

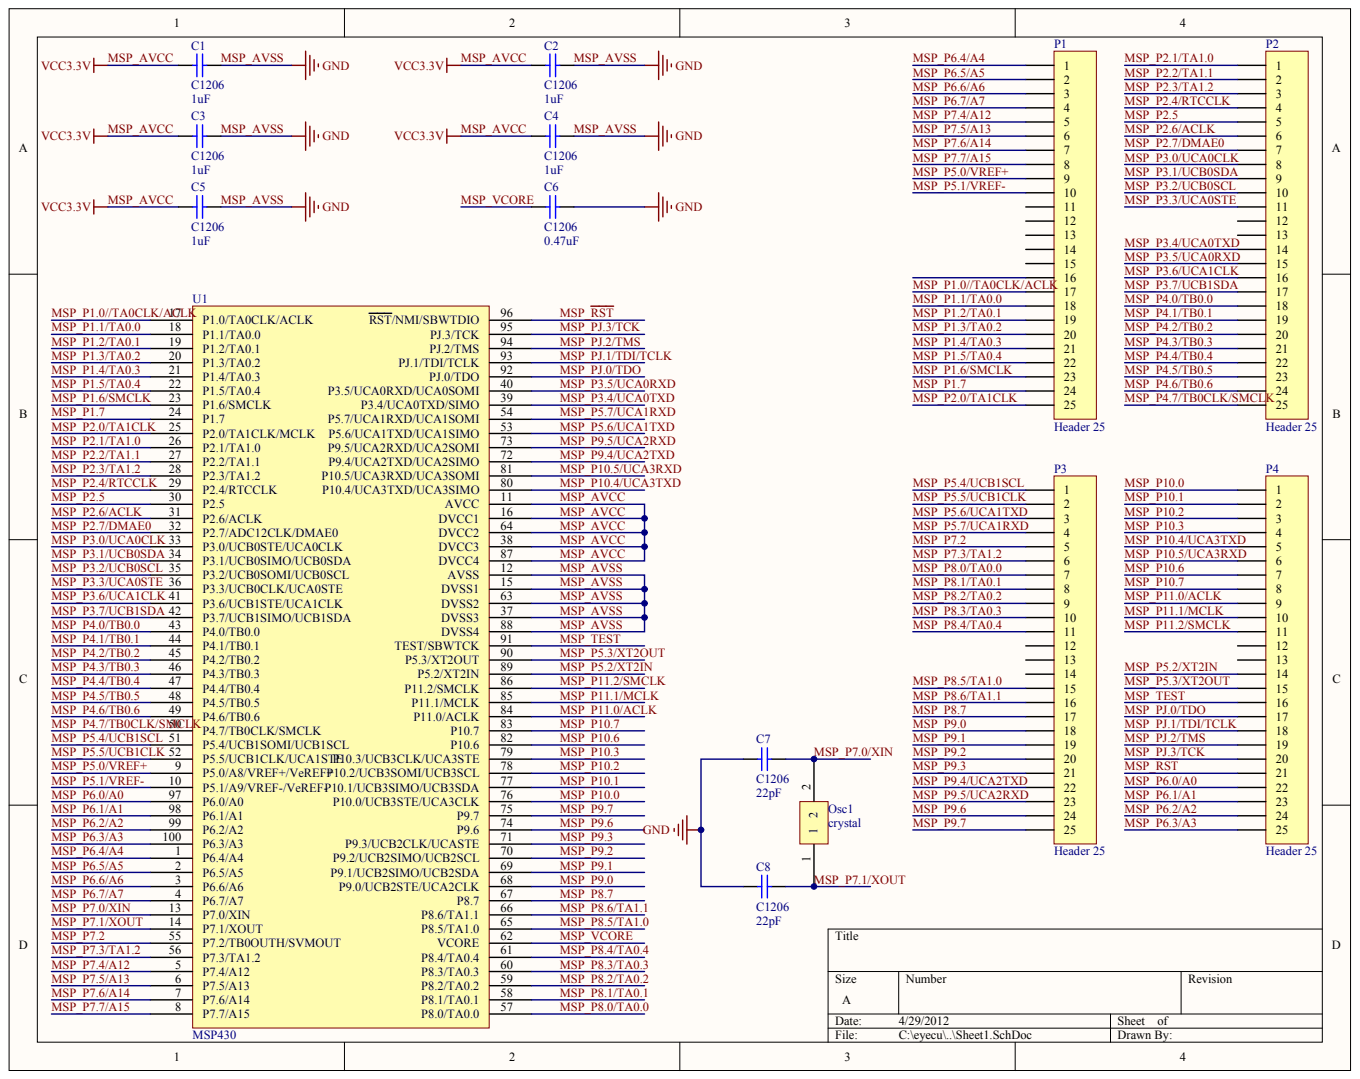
[picture p114: page 2]

MSP_AVCC

MSP_AVSS

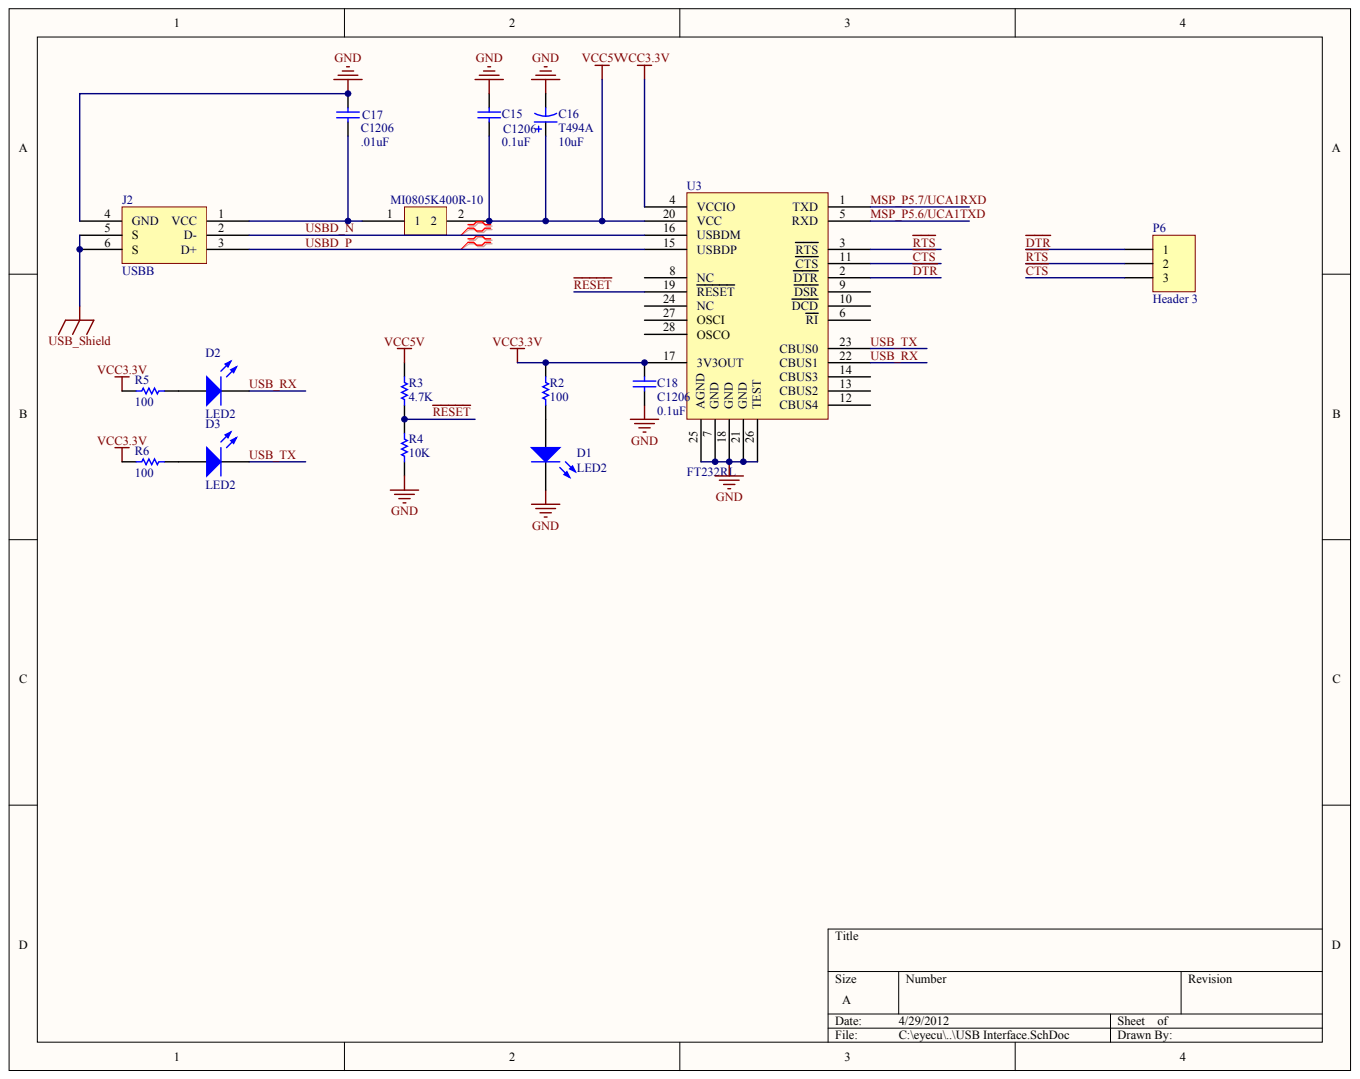
[picture p115: page 3]

S D-S D+ | 2 USBD_N | USBDP 15 USBDM 16

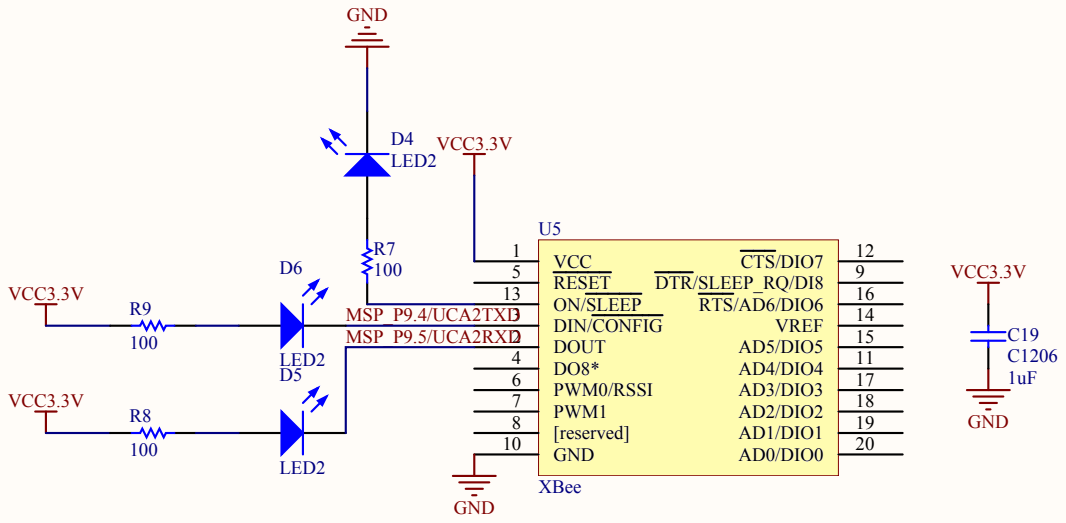
[picture p116: page 4]

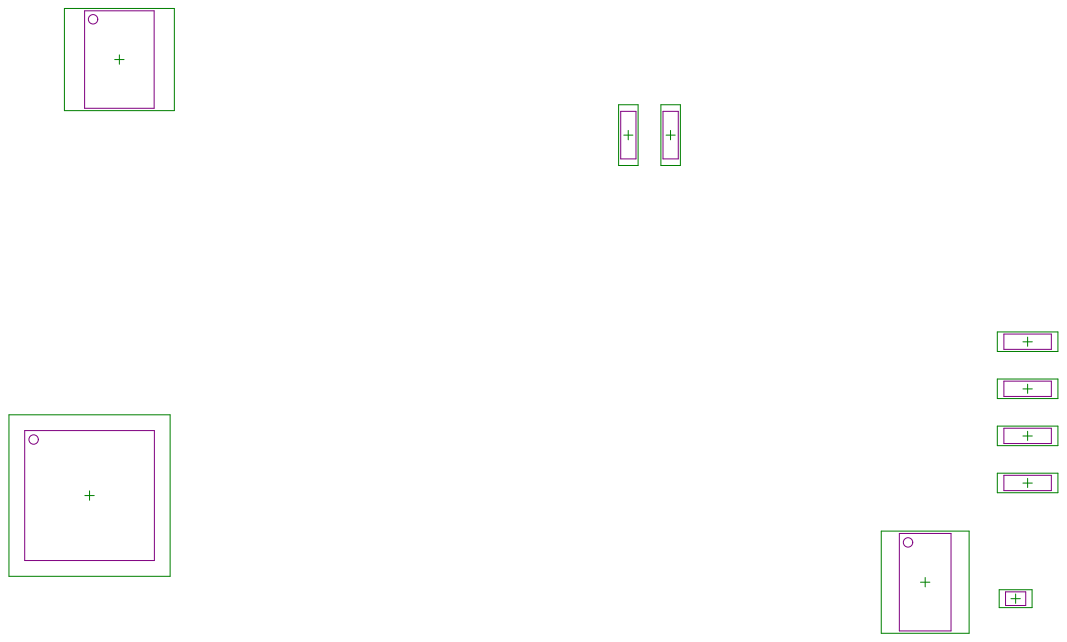
[picture p117: page 5]

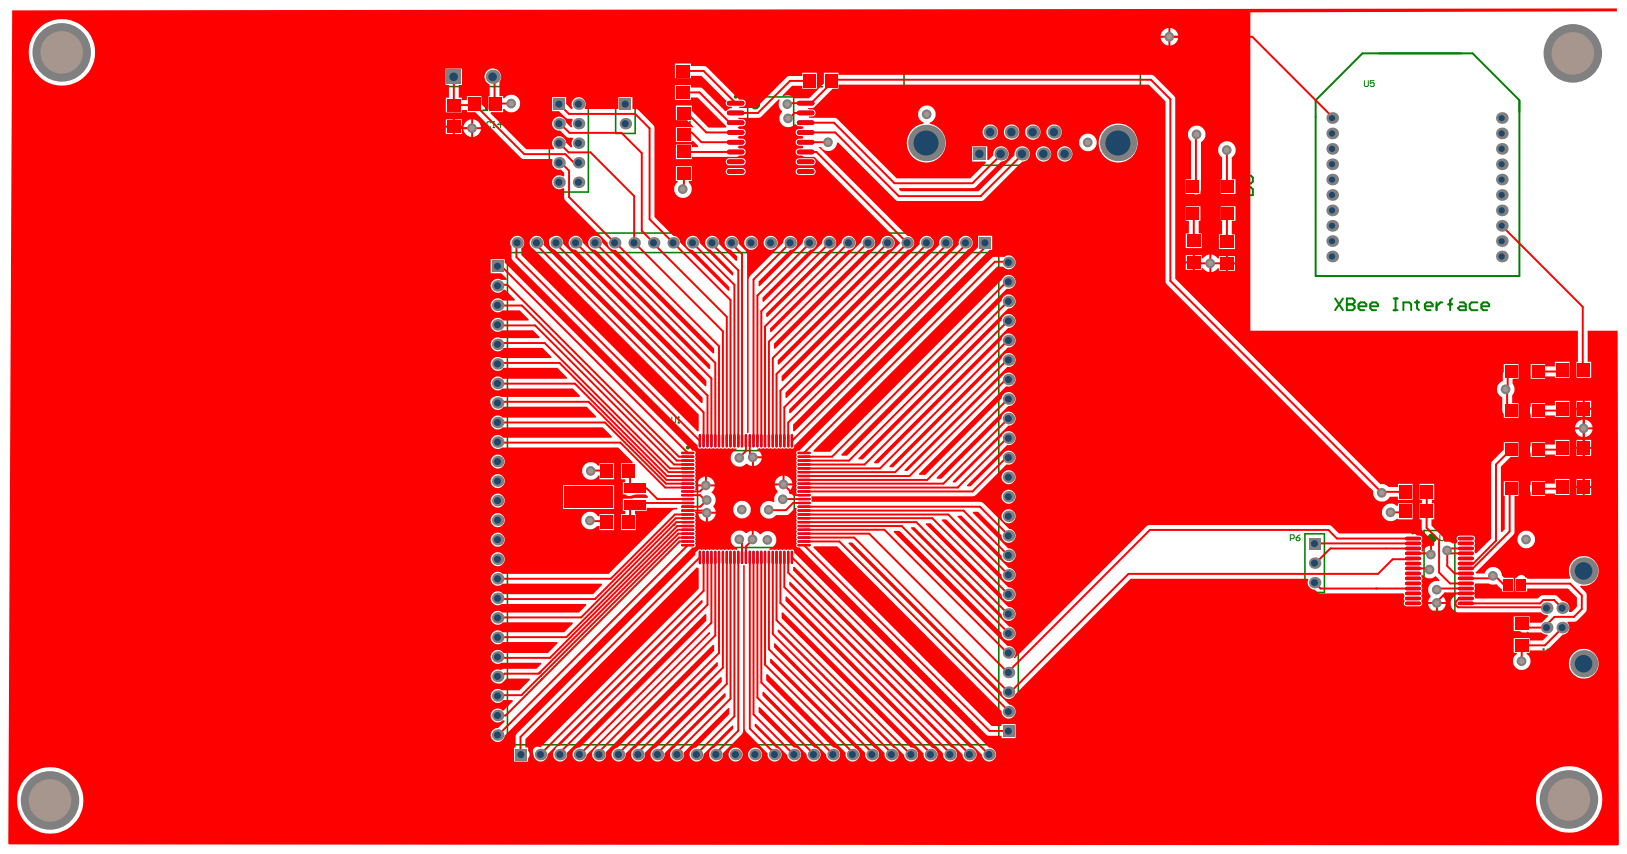
[picture p118: page 6]

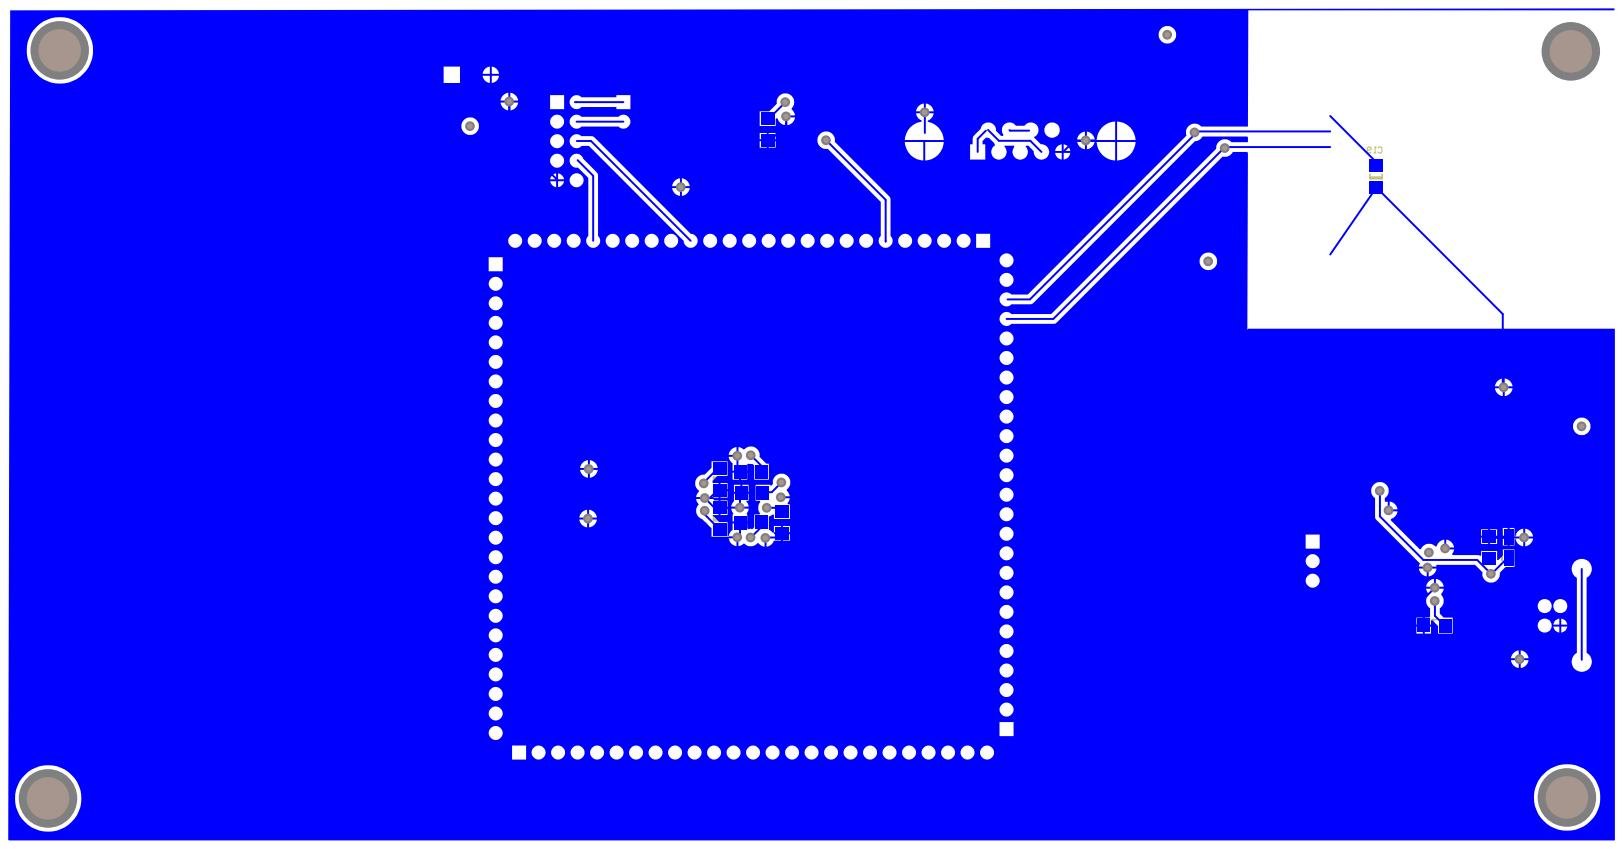
[picture p119: page 7]

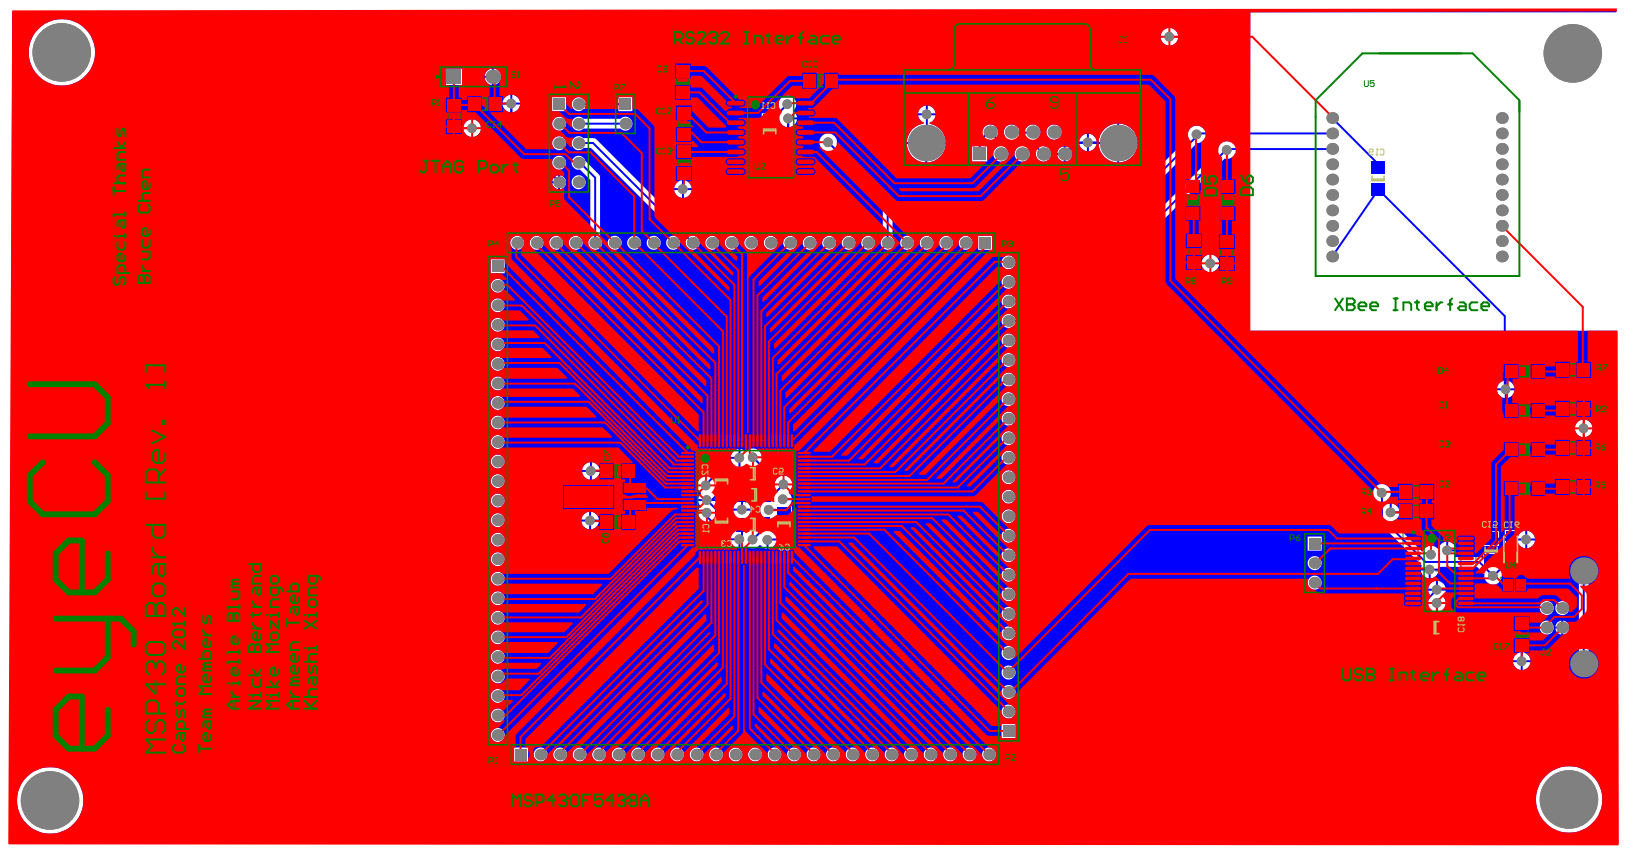
[picture p120: page 8]
