meetmrhung/eyecu/documentation/TechnicalManual/Arielle/MSP430PCBnoPolygonPour.pdf

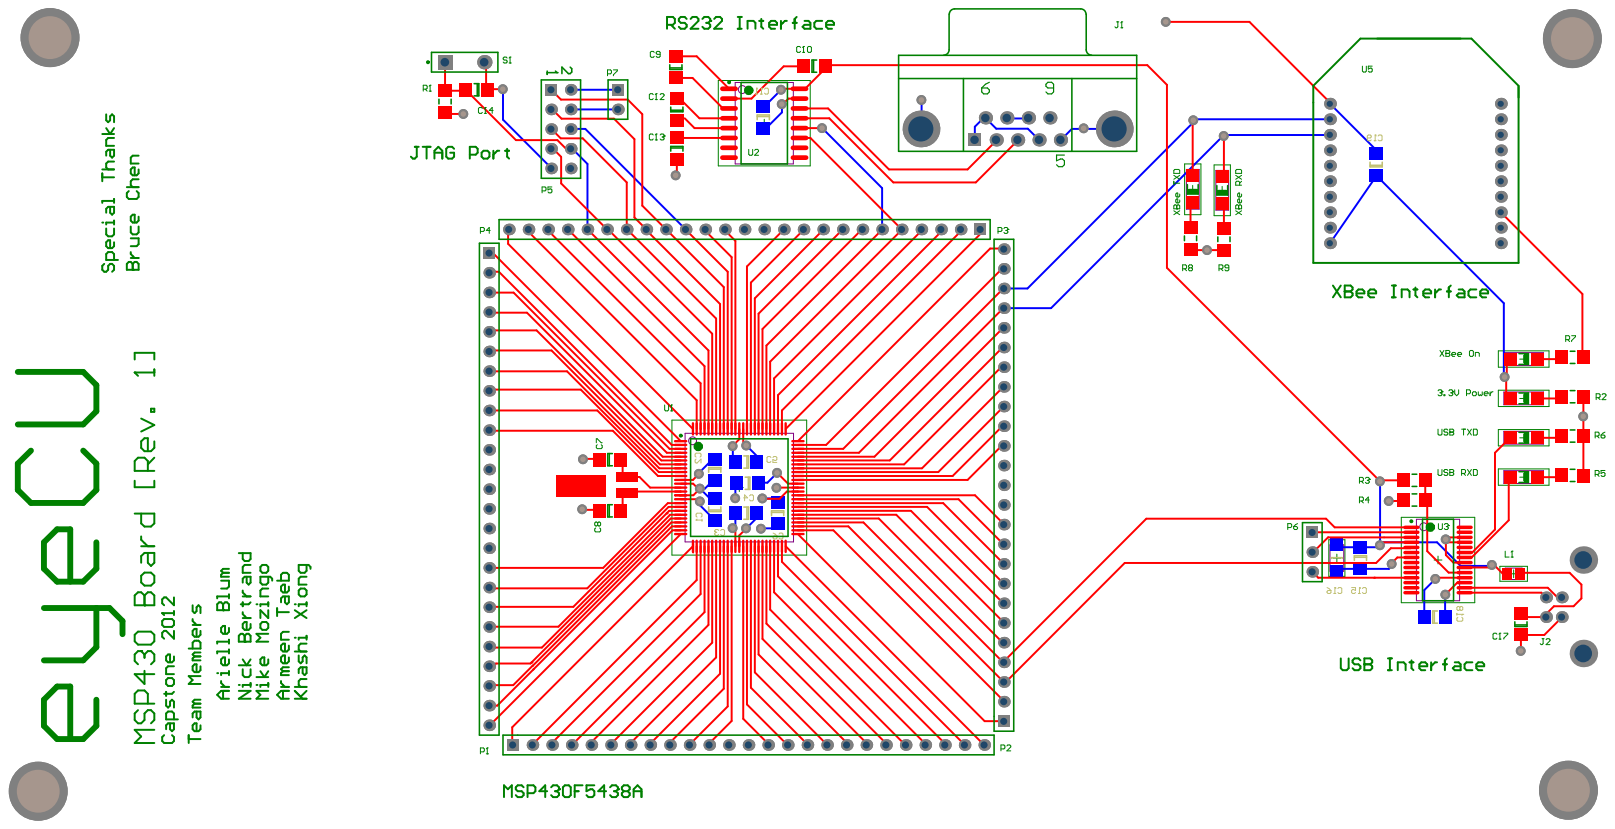
[picture p121: page 1]
