meetmrhung/eyecu/(list of files, drawings)

Other design files:
hardware/schematics/daughterboard/camera.SchDoc
hardware/schematics/daughterboard/CameraInterface.SchDoc
hardware/schematics/daughterboard/connections_to_beaglebone.SchDoc
hardware/schematics/daughterboard/daughterboard.PcbDoc
hardware/schematics/daughterboard/daughterboard.PcbLib
hardware/schematics/daughterboard/daughterboard.PrjPcb
hardware/schematics/daughterboard/daughterboard.SchLib
hardware/schematics/daughterboard/misc.PcbLib
hardware/schematics/msp430/Crystal_32K.PcbLib
hardware/schematics/msp430/Crystal_32K.SchLib
hardware/schematics/msp430/ferrite_bead.PcbLib
hardware/schematics/msp430/ferrite_bead.SchLib
hardware/schematics/msp430/FT232RL.SchLib
hardware/schematics/msp430/ft232rl_pcb.PcbLib
hardware/schematics/msp430/jtag_connector.PcbLib
hardware/schematics/msp430/KEMET_T491A_Capacitor.PcbLib
hardware/schematics/msp430/LED_LiteOn.PcbLib
hardware/schematics/msp430/LED_LiteOn.SchLib
hardware/schematics/msp430/MSP430_Board.PcbDoc
hardware/schematics/msp430/MSP430BoardProject.PrjPcb
hardware/schematics/msp430/MSP430F5438A.PcbLib
hardware/schematics/msp430/MSP430F5438A.SchLib
hardware/schematics/msp430/MSPpcb.PcbDoc
hardware/schematics/msp430/Serial_and_JTAG.SchDoc
hardware/schematics/msp430/serial_port.PcbLib
hardware/schematics/msp430/Sheet1.SchDoc
hardware/schematics/msp430/USB Interface.SchDoc
hardware/schematics/msp430/usbb_lib.SchLib
hardware/schematics/msp430/usbb_pcb.PcbLib
hardware/schematics/msp430/XBee.PcbLib
hardware/schematics/msp430/XBee.SchDoc
hardware/schematics/msp430/XBee.SchLib
hardware/schematics/old/camera/camera.PcbDoc
hardware/schematics/old/camera/camera.PcbLib
hardware/schematics/old/camera/camera.PrjPcb
hardware/schematics/old/camera/main.SchDoc
hardware/schematics/old/camera/misc.SchLib
hardware/schematics/old/daughterboard/CameraInterface.SchDoc
hardware/schematics/old/daughterboard/daughterboard.PcbLib
hardware/schematics/old/daughterboard/daughterboard.PrjPcb
hardware/schematics/old/daughterboard/daughterboard.SchLib
hardware/schematics/old/daughterboard/main.SchDoc
hardware/schematics/old/daughterboard/misc.PcbLib
hardware/schematics/old/daughterboard/usb_ethernet.SchDoc
hardware/schematics/power/Power.PcbDoc
hardware/schematics/power/Power.SchDoc
hardware/schematics/power/PowerPCB.PrjPcb
hardware/schematics/power/REG1117-5.PcbLib
hardware/schematics/power/REG1117-5.SchLib
hardware/schematics/power_rev2/BQ2057T.PcbLib
hardware/schematics/power_rev2/BQ2057T.SchLib
hardware/schematics/power_rev2/DC Barrel Jack.SchLib
hardware/schematics/power_rev2/FZT788BTA.PcbLib
hardware/schematics/power_rev2/FZT788BTA.SchLib
hardware/schematics/power_rev2/MAX1555.PcbLib
hardware/schematics/power_rev2/MAX1555.SchLib
hardware/schematics/power_rev2/Power_REV_2.PcbDoc
hardware/schematics/power_rev2/Power_REV_2.SchDoc
hardware/schematics/power_rev2/PowerPCB_REV_2.PrjPcb
hardware/schematics/power_rev2/REG1117-5.PcbLib
hardware/schematics/power_rev2/REG1117-5.SchLib
hardware/schematics/power_rev2/USB_mini_b.SchLib
hardware/schematics/RapidCamera/Camera.SchDoc
hardware/schematics/RapidCamera/Rapid_Camera.PrjPcb
hardware/schematics/RapidCamera/rapidcamera.PcbDoc
hardware/schematics/RapidCamera/rapidcamera.PcbLib
hardware/schematics/RapidCamera/rapidcamera.SchLib
