meetmrhung/eyecu/(commit log)

2012-01-20 First import
    [camera.PcbLib, camera.PrjPcb, main.SchDoc, misc.SchLib]
2012-01-20 camera board proto
    [camera.PcbLib, camera.PrjPcb, main.SchDoc, misc.SchLib]
2012-01-20 camera board layout added
    [camera.PcbDoc]
2012-01-27 Added flowcharts
2012-01-28 Updted flow charts
2012-01-30 More flowchart fixing
2012-01-30 more updates to flowcharts'
2012-01-31 Updated flowcharts
2012-02-12 Uploaded IRB documents and supporting material
2012-02-13 Updated Main System flowchart
2012-02-14 Started daughterboard schematic.
    [daughterboard.PcbLib, daughterboard.PrjPcb, daughterboard.SchLib, main.SchDoc]
2012-02-17 Uploaded in-progress camera configuration/i2C protocol. Project in CCSv4, currently no code but comments about execution and camera registers.
2012-02-18 Backing up camera I2C code under development. Almost complete I2C initialization of master. Half complete I2C write from Master to Slave. Complete outline for register initialization on the camera, s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
2012-02-19 Made cameraI2C.h, completed necessary I2C functions. Have not compiled/tested/debugged
2012-02-20 worked on daughterboard schematic
    [CameraInterface.SchDoc, daughterboard.PrjPcb, daughterboard.SchLib, main.SchDoc, misc.PcbLib, usb_ethernet.SchDoc]
2012-02-23 Added daughterboard schematics and layout. Layout not finished.
    [CameraInterface.SchDoc, camera.SchDoc, connections_to_beaglebone.SchDoc, daughterboard.PcbDoc, daughterboard.PcbLib, daughterboard.PrjPcb, daughterboard.SchLib, misc.PcbLib]
2012-02-23 worked on daughter layout
    [CameraInterface.SchDoc, camera.SchDoc, connections_to_beaglebone.SchDoc, daughterboard.PcbDoc, daughterboard.PrjPcb]
2012-02-24 More layout work for the daughterboard.
    [CameraInterface.SchDoc, camera.SchDoc, connections_to_beaglebone.SchDoc, daughterboard.PcbDoc, daughterboard.PrjPcb, power.SchDoc]
2012-02-24 minor pcb changes
    [daughterboard.PcbDoc]
2012-02-25 finished first rev board layout
    [CameraInterface.SchDoc, camera.SchDoc, connections_to_beaglebone.SchDoc, daughterboard.PcbDoc]
2012-02-25 Fixed something on the layout and updated a flowchart
    [CameraInterface.SchDoc, camera.SchDoc, connections_to_beaglebone.SchDoc, daughterboard.PcbDoc]
2012-02-25 CDR slides added
    [daughterboard.PcbDoc]
2012-02-26 final check of board before submission
    [daughterboard.PcbDoc]
2012-02-26 Updated CDR.PPT with some additional camera info
2012-02-27 Final changes for rev1 of the daughterboard, board has been ordered
    [CameraInterface.SchDoc, connections_to_beaglebone.SchDoc, daughterboard.PrjPcb, power.SchDoc]
2012-02-28 Nick changed formatting and block diagrams in dSP section, also updated calibration slide
2012-02-29 fixed flowcharts added stupid boxes to schematics
    [camera.SchDoc, connections_to_beaglebone.SchDoc, power.SchDoc]
2012-02-29 updated budget and CDR slides
    [CameraInterface.SchDoc, budget.xlsx, camera.SchDoc, daughterboard.PrjPcb, power.SchDoc]
2012-02-29 added board layout picture
2012-03-01 Fixed grammar in my power slides.
2012-03-01 Updated camera CDR slide for overview
2012-03-01 Finished updating camera-side slides for CDR PPT
2012-03-01 fixed current status on hardware to reflect where we were with the MSp430
2012-03-09 GPIO bit-bang functional upload
    [daughterboard.PcbDoc, power.SchDoc]
2012-03-09 Tried to upload files wrong, this is right now
    [bitbangI2C.c, rit128x96x4.c, rit128x96x4.h, startup_ccs.c]
2012-03-10 I2C Documentation for operational I2C along with SCL testing analysis
2012-03-10 Upload more I2C documentation and I2C code for Stellaris
2012-03-12 I intended to put the gazeTracker folder into a host_comp_software folder to separate the host computer version from the BeagleBone version, but it didn't work. I'm hoping this will move it...
    [eFEParam.h]
2012-03-13 Updated Wireless section. Note: Track changes is turned on.
2012-03-14 Added the algorithms flow chart visio file.
2012-03-14 Updated system flow chart.
2012-03-14 Functional Decomp: Edited Camera Firmware stuff
2012-03-14 Word had changed the color of the section headers when I added the table of contents; switched that back to black. Also, updated the page numbers on the TOC
2012-03-15 Updated XBEE UART code.
2012-03-15 added beagle bone setup stuff (drivers + starterware)
2012-03-16 small changes to hardware TODO and schematics in altium
    [daughterboard.PcbLib, daughterboard.SchLib]
2012-03-16 added todo for daughterboard
    [daughterboard.PcbDoc, power.SchDoc]
2012-03-16 Edited Milestones document to include MSP430 HW, expanded wireless modules, lighting module, glasses module, stellaris module, and adjusted spacing.
2012-03-18 Lots of changes to the gaze tracking code. Connected regions, adaptive thresholding, aspect ratio testing fully implemented and debugged to a working level. Added code for interactive calibration in 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
2012-03-18 Fixed a bug in the connected region finding code where connected regions that did not fit the size requirement would leave information in the cRBinary and cRMap tensors and interfere with regions tha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
    [eFEParam.h]
2012-03-19 Added msp board todo list
2012-03-19 Updated Host computer software with addition of removeAberrations, Finding direction of gaze, and video calibration and some other minor changes
2012-03-20 Modified generateCursorCommand function as well as some calibration code
2012-03-20 Put MSP430 board altium schemtatics up on svn as a backup. Still need to do pcb part and possibly some power circuit to deal with the 3.3V, 3V and 5V supply reqs.
    [FT232RL.SchLib, MSP430BoardProject.PrjPcb, MSP430F5438A.PcbLib, MSP430F5438A.SchLib, Sheet1.SchDoc, ferrite_bead.PcbLib, ferrite_bead.SchLib, ft232rl_pcb.PcbLib]
2012-03-21 Power PCB added.
    [Power.PcbDoc, Power.SchDoc, PowerPCB.PrjPcb, REG1117-5.PcbLib, REG1117-5.SchLib, daughterboard.PcbDoc]
2012-03-21 Also added power BOM and Solidworks models.
    [BeagleBone.SLDASM, BeagleBone_ARM.SLDPRT, BeagleBone_DC_Jack.SLDPRT, BeagleBone_Ethernet.SLDPRT, BeagleBone_Header.SLDPRT, BeagleBone_PCB.SLDPRT, BeagleBone_USB_A.SLDPRT, Power PCB BOM.xlsx]
2012-03-21 Power PCB update.
    [Power.PcbDoc, Power.SchDoc, REG1117-5.SchLib]
2012-03-21 Began rev 2 of daughterboard
    [CameraInterface.SchDoc, camera.SchDoc, connections_to_beaglebone.SchDoc, daughterboard.PcbLib, daughterboard.PrjPcb, daughterboard.SchLib, power.SchDoc]
2012-03-22 Updated the copy of msp430 stuff to the svn
    [Sheet1.SchDoc]
2012-03-22 work on daughterboard schematics and addition of uartEcho test for milestone 1 demo
    [CameraInterface.SchDoc, camera.SchDoc, connections_to_beaglebone.SchDoc]
2012-03-22 MSP430 board backup
    [MSP430BoardProject.PrjPcb, MSP430F5438A.SchLib, Sheet1.SchDoc]
2012-03-22 Added cursor movement code to the gaze track algorithm for testing.
2012-03-22 update duaghterboard todo
    [daughterboard.PrjPcb]
2012-03-26 updated daughterboard schematics and TODO
    [CameraInterface.SchDoc, camera.SchDoc, connections_to_beaglebone.SchDoc, daughterboard.PcbDoc]
2012-03-27 Add schematics for rapid prototype camera
    [Camera.SchDoc, Rapid_Camera.PrjPcb, p82b96.SchLib]
2012-03-28 did layout for rapidcamera, will need several white wires to finish it
    [Camera.SchDoc, Rapid_Camera.PrjPcb, daughterboard.PrjPcb]
2012-03-28 update msp430 altium
    [MSP430BoardProject.PrjPcb, MSP430_Board.PcbDoc, Serial_and_JTAG.SchDoc, Sheet1.SchDoc, XBee.PcbLib, XBee.SchDoc, usbb_lib.SchLib, usbb_pcb.PcbLib]
2012-03-29 MSP430 board schematics and PCB routing complete. Have yet to attempt Advanced Circuits test yet. Awaiting project review with Mike before proceed to next phase.
    [MSP430_Board.PcbDoc, Serial_and_JTAG.SchDoc, Sheet1.SchDoc, XBee.SchDoc, rapidcamera.PcbDoc, usbb_pcb.PcbLib]
2012-03-29 much layout done for rev 2 of daughterboard
    [Camera.SchDoc, CameraInterface.SchDoc, MSP430BoardProject.PrjPcb, camera.SchDoc, connections_to_beaglebone.SchDoc, daughterboard.PcbDoc, daughterboard.PcbLib, daughterboard.PrjPcb]
2012-03-30 MSP430:Changed foot on crystal, finished doing the DRC in AlAltium, added 2 pours (power and ground), next step is create the Gerber and then submit the Advanced Circuits
    [Camera.SchDoc, Crystal_32K.PcbLib, Crystal_32K.SchLib, MSP430BoardProject.PrjPcb, MSP430_Board.PcbDoc, Rapid_Camera.PrjPcb, Serial_and_JTAG.SchDoc, Sheet1.SchDoc]
2012-03-31 Added BOM for MSP board which includes manufacturer numbers and part status etc.
    [MSP_BOM_Record.xlsx, rapidcamera.PcbDoc]
2012-03-31 Added all datasheets for MSP board
2012-03-31 MSP430 board: optimized pcb, updated leds with correct leds, double checked pcb. passed DRM. Besides that, added digikey and samtec order summaries.
    [MSP430BoardProject.PrjPcb, MSP430_Board.PcbDoc, MSP_BOM_Record.xlsx, Serial_and_JTAG.SchDoc, Sheet1.SchDoc, XBee.SchDoc]
2012-04-02 rev 2 of daughterboard complete
    [connections_to_beaglebone.SchDoc, daughterboard.PcbDoc]
2012-04-03 MSP430 update
    [XBee.PcbLib, ferrite_bead.SchLib]
2012-04-04 Added the calibration GUI. Currently has the ability to calibrate threshold and processing region for the computer implementation of the gaze trackign algorithm.
2012-04-04 Added the ability for the computer implementation of the gaze tracking algorithm to receive threshold and processing region parameters from the Python GUI during video capture mode (still not impleme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
    [eFEParam.h]
2012-04-06 Added functionality to perform step-by-step calibration of threshold, reference size, reference centroid, and processing region. Have not yet interfaced the updated code with the gaze tracking progra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
2012-04-07 Fixed a bug where pressing the PREVIOUS button while the directions were still being displayed would make the direction calibration window unresponsive. Also, if the icon is not present the default o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
2012-04-10 added starterware README
    [connections_to_beaglebone.SchDoc, daughterboard.PcbDoc, daughterboard.PrjPcb]
2012-04-11 Milestone Goals Update: Calibration module and the host computer and Beagle bone module communication module in software
2012-04-11 Milestone 2 goals edited. Deleted XBee communication or any XXBee progress from milestone 2. Updated MSP430 Board goals by deleting XBee. Deleted I2C mention from BeagleBone. Changed the order of har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
    [daughterboard.PrjPcb]
2012-04-11 deleted random reference in milestone 2 goals in camera board that didn't make sense
2012-04-11 I created and added it to svn a BOM for the Daughter and Camera Boards
    [Daughter_and_Camera_Board_PCB_BOM.xlsx]
2012-04-16 Added Documentation of the camera operating using oscilloscope to capture all the pertinant output signals. Determined that level shifter must be taken off of the camera board. This verifies what I h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
2012-04-17 Added new oscope catures, good camera signals with appropriate voltage levels. this is prior to adding the sn74 level shifter again.
2012-04-18 Added the TestCardVideoDemo folder. The demo has the BeagleBone output a test card frame at the request of the host app. The host app receives and displays the test card from the BeagleBone. The demo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
2012-04-18 added code for project, still coalescing all of the parts, but it is a start. need to add sd, reconfigure uart and test
2012-04-19 Capture device is now configurable by the first command line argument.
2012-04-19 Added documentation of MSP430 Board along with document for milestone 2 demo.
    [MSP_BOM_Record.xlsx]
2012-04-29 Uploaded my work in progress on the Technical Reference Manual. I brought in all my written documentation and pictures from throughout the semester and made a really rough outline of documentation fo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
    [MSP430BoardProject.PrjPcb, Serial_and_JTAG.SchDoc, USB Interface.SchDoc, XBee.SchDoc]
2012-04-29 added python and c implenentations of uart for beagle and linux, moved old code into starterware subdirectory.
    [CameraInterface.SchDoc, camera.SchDoc, connections_to_beaglebone.SchDoc, daughterboard.PcbDoc]
2012-04-29 Added Power Rev 2 PCB.
    [BQ2057T.PcbLib, BQ2057T.SchLib, DC Barrel Jack.SchLib, FZT788BTA.PcbLib, FZT788BTA.SchLib, MAX1555.PcbLib, MAX1555.SchLib, PowerPCB_REV_2.PrjPcb]
2012-04-30 Updated MSP430 Board Technical user's manual and updated some Altium schematics
    [FT232RL.SchLib, MSP430BoardProject.PrjPcb, MSP430_Board.PcbDoc, USB Interface.SchDoc]
2012-05-01 added some files that i was missing
    [serialComm.py]
2012-05-02 Fixed a bug where you could shoot in far in front of the duck and it would die when it finally flew over where you clicked.
2012-05-02 Added Xbee and UART to Technical Manual.
2012-05-16 added logic analyzer capture
    [daughterboard.SchLib]
